der-kollege/My_kicad_hardware/FPGA_Board_BA/Render3.png

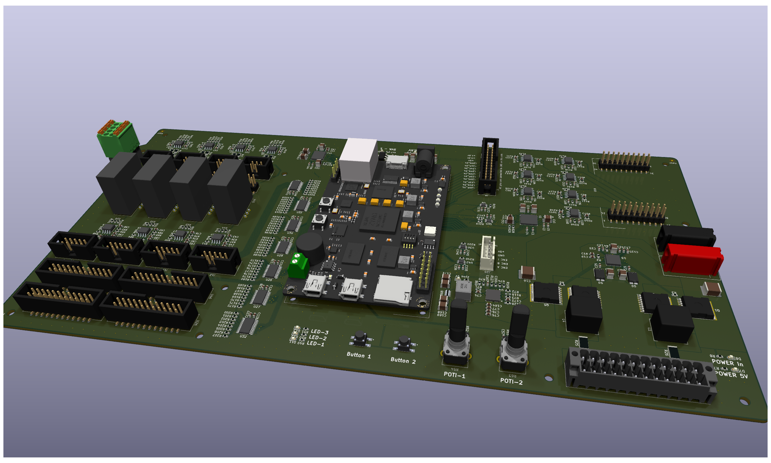
FPGA_Board_BA/Render3.png
