der-kollege/My_kicad_hardware/FPGA_Board_BA/Render1.png

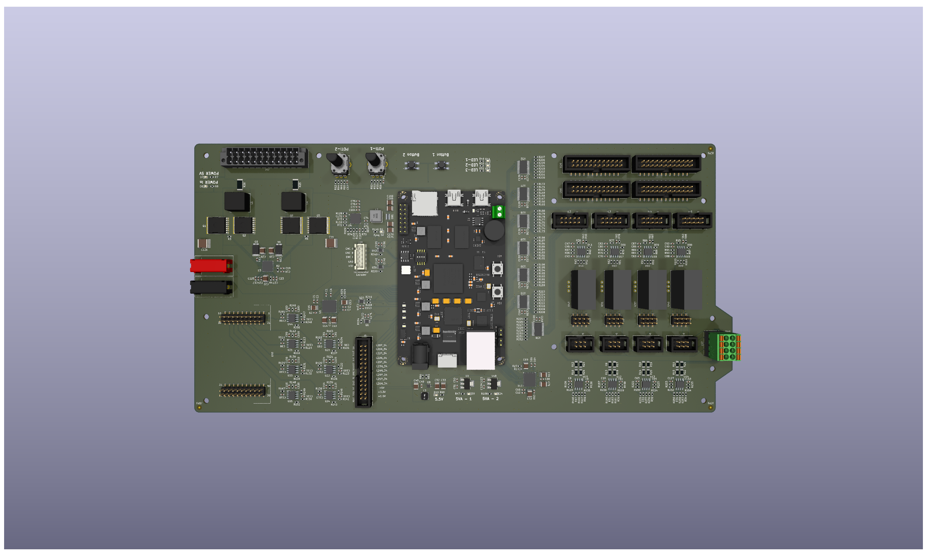
FPGA_Board_BA/Render1.png
