der-kollege/My_kicad_hardware/Adapter_Board/notes.txt

Zweilaging alle gnd stecker an gnd
Pads so breit wie möglich
Bei Versorgung pins viele vias
