der-kollege/My_kicad_hardware/FPGA_Board_BA/Pins FPGA.txt

Pins FPGA:

Bank 13: number of pins 12
Bank 34: ... 48
Bank 35: #48

CHB Connector: Wannenstecker - 10 pin (Harting-ML10)
