der-kollege/My_kicad_hardware/FPGA_Board_BA/FPGA_board.drawio.png

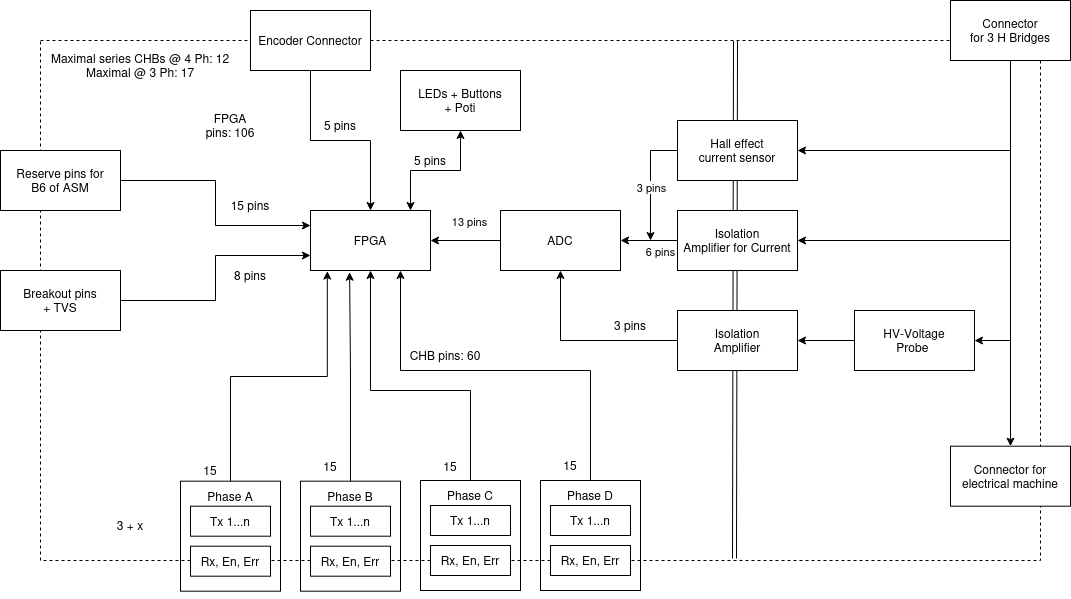
FPGA_Board_BA/FPGA_board.drawio.png
