der-kollege/My_kicad_hardware/FPGA_Board_BA/IMG_6897.jpeg

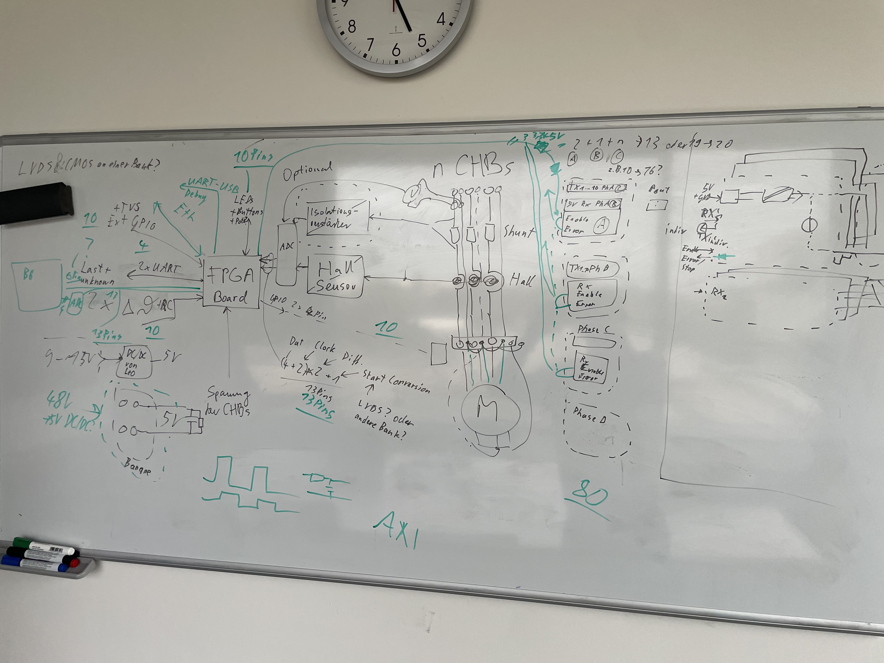
FPGA_Board_BA/IMG_6897.jpeg
