der-kollege/My_kicad_hardware/FPGA_Board_BA/IMG_7021.jpeg

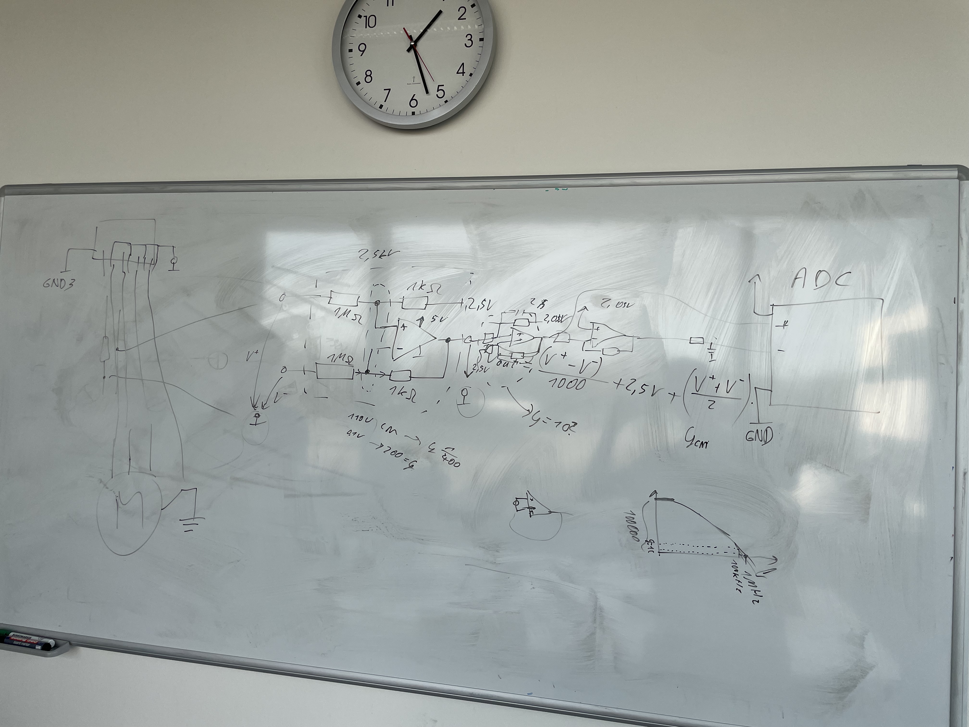
FPGA_Board_BA/IMG_7021.jpeg
