der-kollege/My_kicad_hardware/FPGA_Board_BA/IMG_7337.jpeg

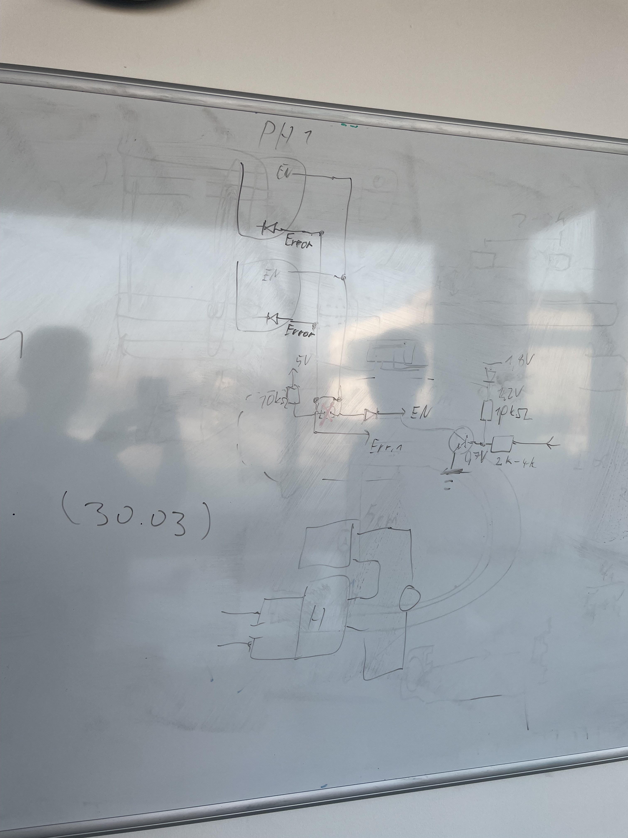
FPGA_Board_BA/IMG_7337.jpeg
