der-kollege/My_kicad_hardware/FPGA_Board_BA/Render2.png

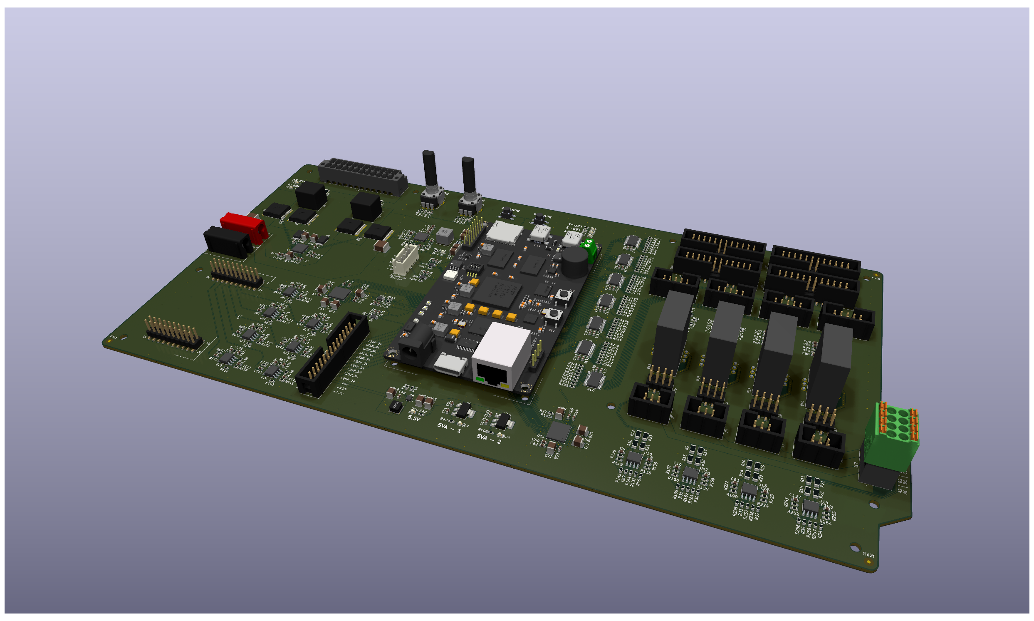
FPGA_Board_BA/Render2.png
