der-kollege/My_kicad_hardware/FPGA_Board_BA/Vivado_pinout_adc_in.png

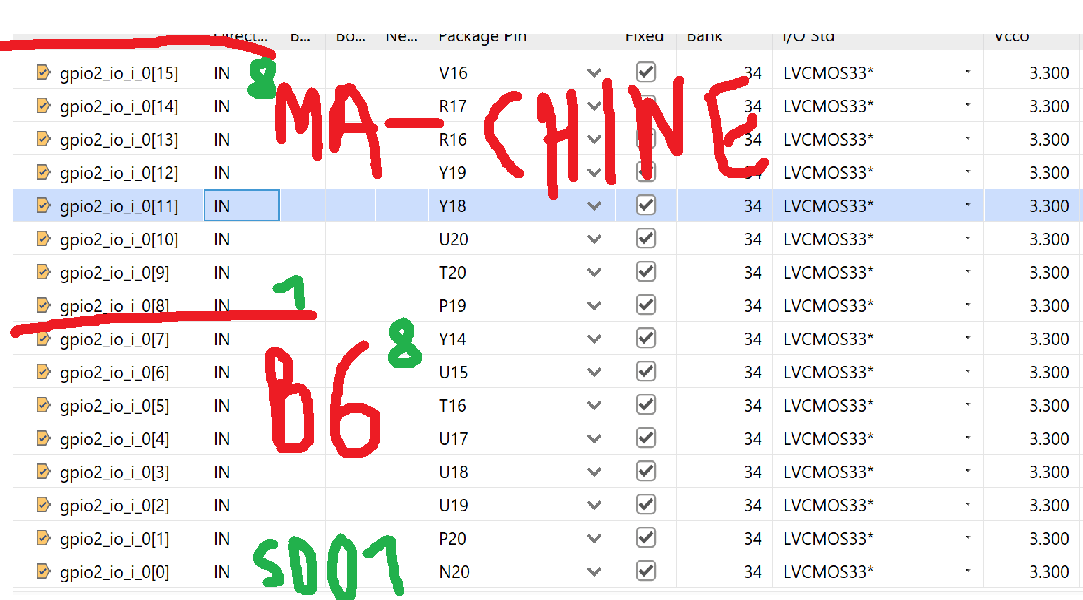
FPGA_Board_BA/Vivado_pinout_adc_in.png
