der-kollege/My_kicad_hardware/FPGA_Board_BA/vivado_pinout_buttons.png

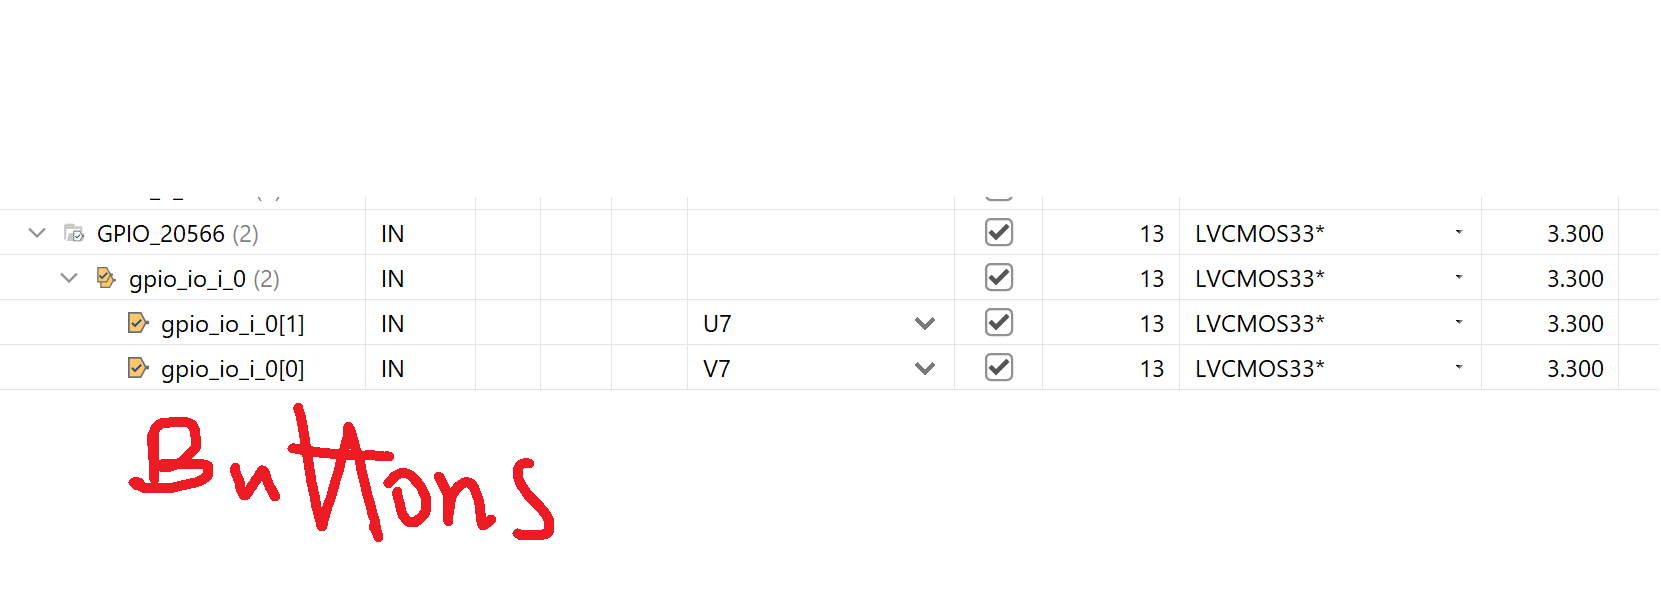
FPGA_Board_BA/vivado_pinout_buttons.png
