der-kollege/My_kicad_hardware/FPGA_Board_BA/vivado_pinout_zynq_out.png

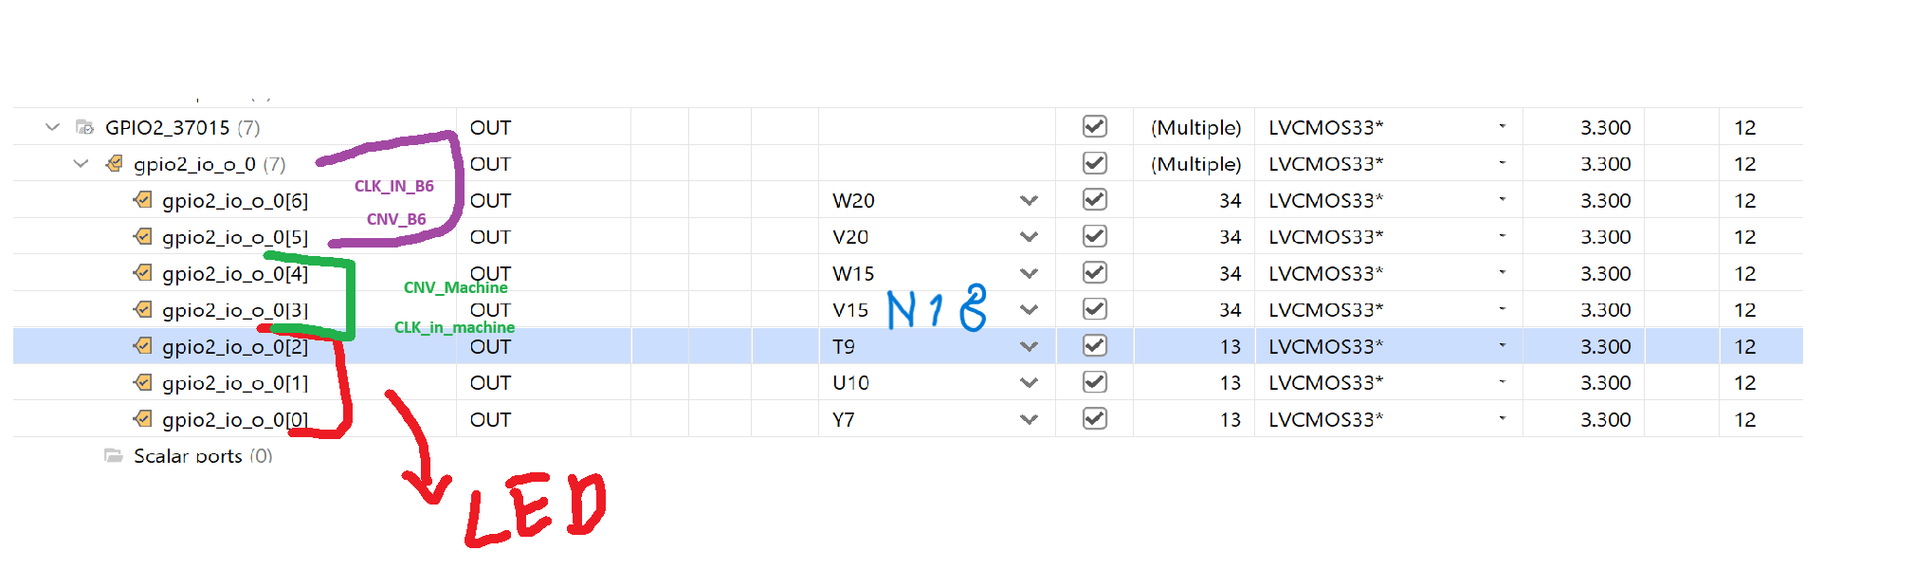
FPGA_Board_BA/vivado_pinout_zynq_out.png
