der-kollege/My_kicad_hardware/FPGA_Board_BA/vivado_pintout_rx_tx.png

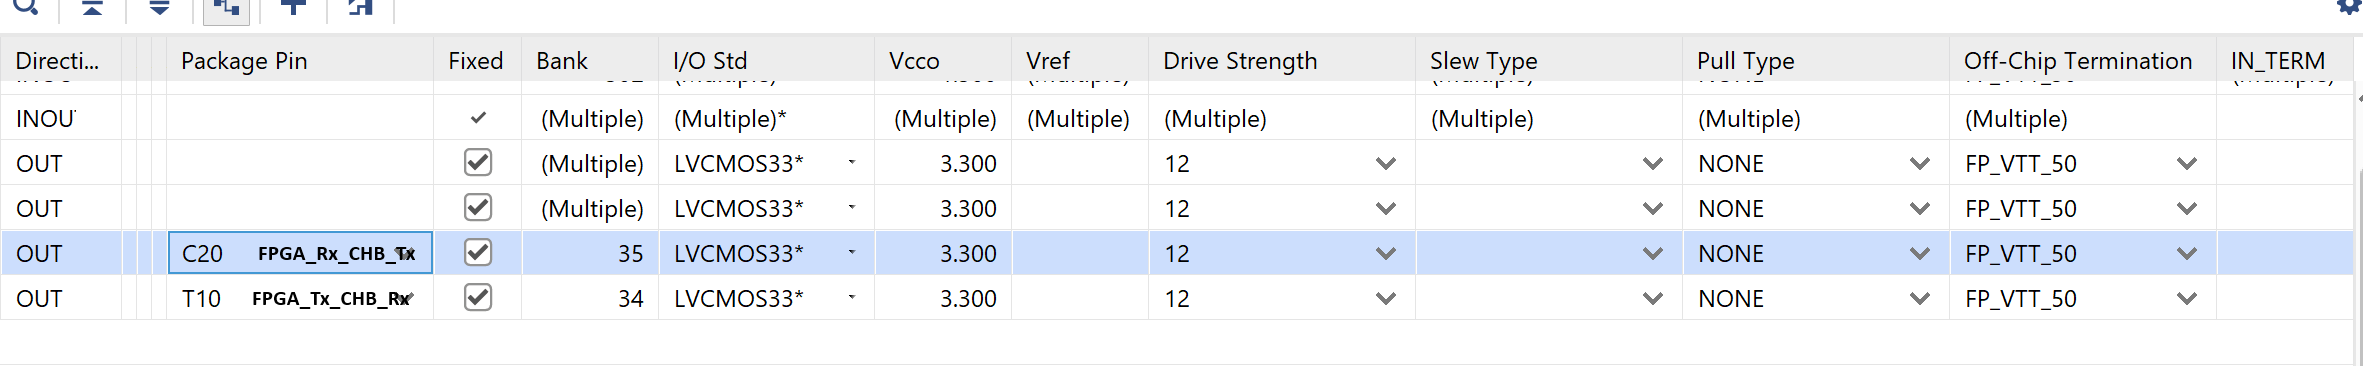
FPGA_Board_BA/vivado_pintout_rx_tx.png
