der-kollege/My_kicad_hardware/FPGA_Board_BA/exports/BOM/FPGA_Board_BA_final_left.csv

Id | Designator | Footprint | Quantity | Designation | Supplier and ref
25 | L2 | L_5u6_78439346056 | 1 | Inductor 5.6uH
35 | U4 | RRX Package, 29-Pin VQFN | 1 | LM70860RRXR
37 | U43,U31,U37,U40 | Tamura_S22P006S05 | 4 | S22P006S05
61 | J20 | JST_XH_B5B-XH-A_1x05_P2.50mm_Vertical | 1 | JST_XH_05_vertical
