der-kollege/My_kicad_hardware/FPGA_Board_BA/exports/BOM/BOM_Mouser_1.xls

WARENKORB
Dies ist keine Rechnung
01-Dez-25 09:17:06
 | Mouser-Nr. | Herst.- Nr. | Hersteller | Kunden-Teilenr | Beschreibung | RoHS | Lebenszyklus | Stückzahl | Preis (EUR) | Gesamtpreis: (EUR)
1 | 584-LT1819IS8#PBF | LT1819IS8#PBF | Analog Devices Inc. | LT1819IS8#PBF | Hochgeschwindigkeits-Operationsverstärker 400MHz, 2500V/ s, 9mA 2x Op Amps | RoHS-konform |  | 15 | 3,84 € | 57,60 €
2 | 838-S22P006S05 | S22P006S05 | Tamura | S22P006S05 | Stromsensoren für Plattenmontage CURRENT SENSOR ( 6A; +5V) | RoHS-konform |  | 4 | 13,52 € | 54,08 €
3 | 595-74LXC2T45QDCURQ1 | SN74LXC2T45QDCURQ1 | Texas Instruments | SN74LXC2T45QDCURQ1 | Übersetzungsspannungs-Pegel Automotive two-bit d ual-supply transceiv | RoHS-konform |  | 6 | 0,869 € | 5,21 €
4 | 595-N74LXCH8T245RHLR | SN74LXCH8T245RHLR | Texas Instruments | SN74LXCH8T245RHLR | Übersetzungsspannungs-Pegel 8-bit dual-supply bu s transceiver with c | RoHS-konform |  | 7 | 1,63 € | 11,41 €
5 | 584-C2320CUKG-16PBF | LTC2320CUKG-16#PBF | Analog Devices Inc. | LTC2320CUKG-16#PBF | Analog-in-Digital-Wandler - ADC Octal, 16-B, 1.5Msps/Ch Simultaneous Smp | RoHS-konform |  | 2 | 31,02 € | 62,04 €
6 | 579-MCP1703AT5002EDB | MCP1703AT-5002E/DB | Microchip | MCP1703AT-5002E/DB | LDO Spannungs-Regulator LOW Iq, High Vin LDO | RoHS-konform |  | 1 | 0,722 € | 0,72 €
7 | 595-TPS61022RWUT | TPS61022RWUT | Texas Instruments | TPS61022RWUT | Schaltspannungsregler 8-A boost converter with 0.5-V ultra-low A 595-TPS61022RWUR | RoHS-konform |  | 1 | 2,06 € | 2,06 €
8 | 595-LM5143RHAR | LM5143RHAR | Texas Instruments | LM5143RHAR | Schaltregler 3.5-V to 65-V dual- output stackable s | RoHS-konform |  | 1 | 4,02 € | 4,02 €
9 | 612-TL3305BF100QG | TL3305BF100QG | E-Switch | TL3305BF100QG | Sensorschalter TACT, 50mA, SPST-NO, Surface Mount | RoHS-konform | Neues Produkt | 2 | 0,181 € | 0,36 €
10 | 688-RK09D1130A1N | RK09D1130A1N | Alps Alpine | RK09D1130A1N | Potentiometer 9MM 10K V/ADJ | RoHS-konform |  | 2 | 3,16 € | 6,32 €
11 | 726-IPT017N12NM6ATMA | IPT017N12NM6ATMA1 | Infineon | IPT017N12NM6ATMA1 | MOSFETs TRENCH >=100V | RoHS-konform |  | 4 | 5,14 € | 20,56 €
12 | 621-SBR10U200P5-13 | SBR10U200P5-13 | Diodes Incorporated | SBR10U200P5-13 | Schottky Dioden & Gleichrichter 10A 200V MATT TIN FINISH | RoHS-konform |  | 2 | 1,23 € | 2,46 €
13 | 871-B72590D50H160 | B72590D50H160 | TDK | B72590D50H160 | Varistoren 5.6 VDC .9P 210PF | RoHS-konform |  | 14 | 0,047 € | 0,66 €
14 | 845-973582101 | 973582101 | Altech | 973582101 | Prüfstecker und Messbuchsen PCB Test Socket PB4 RED | RoHS-konform |  | 1 | 2,92 € | 2,92 €
15 | 845-973582100 | 973582100 | Altech | 973582100 | Prüfstecker und Messbuchsen PCB Test Socket PB 4 BLACK | RoHS-konform |  | 1 | 2,92 € | 2,92 €
16 | 710-61202421621 | 61202421621 | Wurth Elektronik | 61202421621 | Sockel & Kabelgehäuse WR-BHD 2.54mm Male 24P Str Gold Box Hdr | RoHS-konform |  | 4 | 0,869 € | 3,48 €
17 | 755-PMR18EZPJV2L0 | PMR18EZPJV2L0 | ROHM Semiconductor |  | Strommesswiderstände - SMD 1206 2mOhm 5% AEC-Q200 | RoHS-konform |  | 2 | 0,576 € | 1,15 €
18 | 651-1787496 | 1787496 | Phoenix Contact |  | Steckbare Anschlussblöcke 12 Pos 3.5mm Dbl Row Through Hole Header | RoHS-konform |  | 1 | 7,46 € | 7,46 €
19 | 651-1790580 | 1790580 | Phoenix Contact |  | Steckbare Anschlussblöcke 12 Pos 3.5mm Dbl Row Plug 24-16AWG Sprin | RoHS-konform |  | 1 | 15,61 € | 15,61 €
20 | 710-61202423021 | 61202423021 | Wurth Elektronik |  | Sockel & Kabelgehäuse WR-BHD 2.54mm Female 24P Gold IDC Conn | RoHS-konform |  | 4 | 2,00 € | 8,00 €
Durch das Absenden Ihrer Bestellung erklären Sie sich mit diesen Geschäftsbedingungen einverstanden. (https://www.mouser.de/saleterms) |  |  |  |  |  |  |  |  | Ware: | 269,04 €
Die Preise sind zum angezeigten Datum und zur Uhrzeit reflektiert. |  |  |  |  |  |  |  |  | Versandkosten: | 0,00 €
 |  |  |  |  |  |  |  |  | Versand von Nachlieferungen: | 0,00 €
