der-kollege/My_kicad_hardware/FPGA_Board_BA/exports/BOM/Final/Zynq_Farnell_BOM.csv

Nr. | Best.-Nr. | RoHS-konform? | Ihre Bestellnummer | Hinweise | Menge | Hersteller-Teilenr. | Herstellername | Hersteller / Beschreibung | Verfügbarkeit | Stückpreis (&euro;) | Positionspreis (&euro;) | Rabattpreis (&euro;)
1 | 2447451 | RoHS: Y-EX / PHTHALATE: YES |  |  | 10.0 | MCWR06X9101FTL | MULTICOMP PRO | MULTICOMP PRO Chipwiderstand, Oberflächenmontage, 9.1 kohm, ± 1%, 100 mW, 0603 [Metrisch 1608] | 7189 | 0.0054 | 0.05
2 | 2447272 | RoHS: Y-EX / PHTHALATE: YES |  |  | 40.0 | MCWR06X1001FTL | MULTICOMP PRO | MULTICOMP PRO Chipwiderstand, Oberflächenmontage, 1 kohm, ± 1%, 100 mW, 0603 [Metrisch 1608] | 402564 | 0.0048 | 0.19
3 | 2447404 | RoHS: Y-EX / PHTHALATE: YES |  |  | 10.0 | MCWR06X5101FTL | MULTICOMP PRO | MULTICOMP PRO Chipwiderstand, Oberflächenmontage, 5.1 kohm, ± 1%, 100 mW, 0603 [Metrisch 1608] | 35660 | 0.0051 | 0.05
4 | 2447335 | RoHS: Y-EX / PHTHALATE: YES |  |  | 30.0 | MCWR06X30R0FTL | MULTICOMP PRO | MULTICOMP PRO Chipwiderstand, Oberflächenmontage, 30 ohm, ± 1%, 100 mW, 0603 [Metrisch 1608] | 6942 | 0.0051 | 0.15
5 | 2694689 | RoHS: YES / PHTHALATE: YES |  |  | 90.0 | MCWR06X103 JTL | MULTICOMP PRO | MULTICOMP PRO Chipwiderstand, Oberflächenmontage, 10 kohm, ± 5%, 100 mW, 0603 [Metrisch 1608] | 33083 | 0.0048 | 0.43
6 | 2447227 | RoHS: Y-EX / PHTHALATE: YES |  |  | 20.0 | MCWR06X1000FTL | MULTICOMP PRO | MULTICOMP PRO Chipwiderstand, Oberflächenmontage, 100 ohm, ± 1%, 100 mW, 0603 [Metrisch 1608] | 163509 | 0.0049 | 0.10
7 | 2694690 | RoHS: YES / PHTHALATE: YES |  |  | 20.0 | MCWR06X104 JTL | MULTICOMP PRO | MULTICOMP PRO Chipwiderstand, Oberflächenmontage, 100 kohm, ± 5%, 100 mW, 0603 [Metrisch 1608] | 3910 | 0.0049 | 0.10
8 | 2670906 | RoHS: YES / PHTHALATE: YES |  |  | 10.0 | WR06X824 JTL | MULTICOMP PRO | MULTICOMP PRO Chipwiderstand, Oberflächenmontage, 820 kohm, ± 5%, 100 mW, 0603 [Metrisch 1608] | 580 Verfügbar | bis der Lagerbestand erschöpft ist. | 0.0035 | 0.04
9 | 2694815 | RoHS: YES / PHTHALATE: YES |  |  | 10.0 | MCWR06X2R2 JTL | MULTICOMP PRO | MULTICOMP PRO Chipwiderstand, Oberflächenmontage, 2.2 ohm, ± 5%, 100 mW, 0603 [Metrisch 1608] | 3730 Verfügbar | bis der Lagerbestand erschöpft ist. | 0.0051 | 0.05
10 | 2694851 | RoHS: YES / PHTHALATE: YES |  |  | 10.0 | MCWR06X3922FTL | MULTICOMP PRO | MULTICOMP PRO Chipwiderstand, Oberflächenmontage, 39.2 kohm, ± 1%, 100 mW, 0603 [Metrisch 1608] | 1036 | 0.0053 | 0.05
11 | 2670720 | RoHS: YES / PHTHALATE: YES |  |  | 10.0 | WR06X2552FTL | MULTICOMP PRO | MULTICOMP PRO Chipwiderstand, Oberflächenmontage, 25.5 kohm, ± 1%, 100 mW, 0603 [Metrisch 1608] | 2622 | 0.0051 | 0.05
12 | 2073345 | RoHS: Y-EX / PHTHALATE: YES |  |  | 20.0 | MCMR06X000 PTL | MULTICOMP PRO | MULTICOMP PRO Null-Ohm-Widerstand, Jumper, AEC-Q200, 0603 [Metrisch 1608], Dickschichtwiderstand, 100 mW, 1 A | 51500 | 0.0137 | 0.27
13 | 4539043 | RoHS: YES / PHTHALATE: YES |  |  | 10.0 | CL10B104KB8NNNC | SAMSUNG ELECTRO-MECHANICS | SAMSUNG ELECTRO-MECHANICS Keramikvielschichtkondensator, SMD, 0.1 µF, 50 V, 0603 [Metrisch 1608], ± 10%, X7R | 169323 | 0.0060 | 0.06
14 | 3013441 | RoHS: YES / PHTHALATE: YES |  |  | 50.0 | CL10C150JB8NNNC | SAMSUNG ELECTRO-MECHANICS | SAMSUNG ELECTRO-MECHANICS Keramikvielschichtkondensator, SMD, 15 pF, 50 V, 0603 [Metrisch 1608], ± 5%, C0G / NP0 | 8088 | 0.0174 | 0.87
15 | 3013399 | RoHS: YES / PHTHALATE: YES |  |  | 10.0 | CL10A475KQ8NNNC | SAMSUNG ELECTRO-MECHANICS | SAMSUNG ELECTRO-MECHANICS Keramikvielschichtkondensator, SMD, 4.7 µF, 6.3 V, 0603 [Metrisch 1608], ± 10%, X5R | 3173 | 0.0130 | 0.13
16 | 3764545 | RoHS: YES / PHTHALATE: YES |  |  | 10.0 | CC0603KRX7R9BB124 | YAGEO | YAGEO Keramikvielschichtkondensator, SMD, 0.12 µF, 50 V, 0603 [Metrisch 1608], ± 10%, X7R | 2027 | 0.0584 | 0.58
17 | 722054 | RoHS: YES / PHTHALATE: YES |  |  | 10.0 | CC0603JRNPO9BN560 | YAGEO | YAGEO Keramikvielschichtkondensator, SMD, 56 pF, 50 V, 0603 [Metrisch 1608], ± 5%, C0G / NP0 | 11673 | 0.0201 | 0.20
18 | 8819920 | RoHS: YES / PHTHALATE: YES |  |  | 10.0 | GRM1885C1H102JA01D | MURATA | MURATA Keramikvielschichtkondensator, SMD, 1000 pF, 50 V, 0603 [Metrisch 1608], ± 5%, C0G / NP0 | 31700 | 0.0105 | 0.11
19 | 4666646 | RoHS: YES / PHTHALATE: YES |  |  | 5.0 | MSASE32NSB5106KTNA01 | TAIYO YUDEN | TAIYO YUDEN Keramikvielschichtkondensator, SMD, 10 µF, 16 V, 1210 [Metrisch 3225], ± 10%, X5R | 1640 | 0.1410 | 0.71
20 | 4255901 | RoHS: YES / PHTHALATE: YES |  |  | 6.0 | CC1210KFX7R9BB106 | YAGEO | YAGEO Keramikvielschichtkondensator, SMD, 10 µF, 50 V, 1210 [Metrisch 3225], ± 10%, X7R | 4765 Verfügbar | bis der Lagerbestand erschöpft ist. | 0.5700 | 3.42
21 | 1358511 | RoHS: YES / PHTHALATE: YES |  |  | 10.0 | C1210C475K5RACTU | KEMET | KEMET Keramikvielschichtkondensator, SMD, 4.7 µF, 50 V, 1210 [Metrisch 3225], ± 10%, X7R | 26895 | 0.2860 | 2.86
22 | 2610410 | RoHS: YES / PHTHALATE: YES |  |  | 5.0 | KPT-1608LVVBC-D | KINGBRIGHT | KINGBRIGHT LED, 1.6mm x 0.8mm, Blau, Oberflächenmontage, 603, 2 mA, 2.65 V, 470 nm | 1760 | 0.3170 | 1.59
23 | 2610409 | RoHS: YES / PHTHALATE: YES |  |  | 10.0 | KPT-1608LVZGCK | KINGBRIGHT | KINGBRIGHT LED, 1.6mm x 0.8mm, Grün, Oberflächenmontage, 603, 2 mA, 2.65 V, 525 nm | 20148 | 0.2700 | 2.70
24 | 2610406 | RoHS: YES / PHTHALATE: YES |  |  | 5.0 | KPT-1608LVSECK-J3-PRV | KINGBRIGHT | KINGBRIGHT LED, 1.6mm x 0.8mm, Rot, Oberflächenmontage, 603, 2 mA, 1.8 V, 625 nm | 38399 | 0.2880 | 1.44
25 | 3785802 | RoHS: YES / PHTHALATE: YES |  |  | 10.0 | GRM155R61A106ME11D | MURATA | MURATA Keramikvielschichtkondensator, SMD, 10 µF, 10 V, 0402 [Metrisch 1005], ± 20%, X5R | 130241 | 0.0134 | 0.13
26 | 3013435 | RoHS: YES / PHTHALATE: YES |  |  | 10.0 | CL10B474KO8NNNC | SAMSUNG ELECTRO-MECHANICS | SAMSUNG ELECTRO-MECHANICS Keramikvielschichtkondensator, SMD, 0.47 µF, 16 V, 0603 [Metrisch 1608], ± 10%, X7R | 12152 | 0.0238 | 0.24
27 | 3764545 | RoHS: YES / PHTHALATE: YES |  |  | 10.0 | CC0603KRX7R9BB124 | YAGEO | YAGEO Keramikvielschichtkondensator, SMD, 0.12 µF, 50 V, 0603 [Metrisch 1608], ± 10%, X7R | 2027 | 0.0584 | 0.58
28 | 4539043 | RoHS: YES / PHTHALATE: YES |  |  | 90.0 | CL10B104KB8NNNC | SAMSUNG ELECTRO-MECHANICS | SAMSUNG ELECTRO-MECHANICS Keramikvielschichtkondensator, SMD, 0.1 µF, 50 V, 0603 [Metrisch 1608], ± 10%, X7R | 169323 | 0.0060 | 0.54
29 | 2496840 | RoHS: YES / PHTHALATE: YES |  |  | 10.0 | 0603B153K500CT | MULTICOMP PRO | MULTICOMP PRO Keramikvielschichtkondensator, SMD, 0.015 µF, 50 V, 0603 [Metrisch 1608], ± 10%, X7R | 2872 Verfügbar | bis der Lagerbestand erschöpft ist. | 0.0225 | 0.23
30 | 3013384 | RoHS: YES / PHTHALATE: YES |  |  | 20.0 | CL10A105KO8NNNC | SAMSUNG ELECTRO-MECHANICS | SAMSUNG ELECTRO-MECHANICS Keramikvielschichtkondensator, SMD, 1 µF, 16 V, 0603 [Metrisch 1608], ± 10%, X5R | 96218 | 0.0101 | 0.20
31 | 3816866 | RoHS: YES / PHTHALATE: YES |  |  | 4.0 | C5750X7R1H226M250KB | TDK | TDK Keramikvielschichtkondensator, SMD, 22 µF, 50 V, 2220 [Metrisch 5750], ± 20%, X7R | 2719 | 4.2000 | 16.80
32 | 3581426 | RoHS: YES / PHTHALATE: YES |  |  | 10.0 | GRM32EC81C476KE15K | MURATA | MURATA Keramikvielschichtkondensator, SMD, 47 µF, 16 V, 1210 [Metrisch 3225], ± 10%, X6S | 13848 | 0.2130 | 2.13
33 | 3764454 | RoHS: YES / PHTHALATE: YES |  |  | 10.0 | CC0603JPNPO9BN220 | YAGEO | YAGEO Keramikvielschichtkondensator, SMD, 22 pF, 50 V, 0603 [Metrisch 1608], ± 5%, C0G / NP0 | 377510 | 0.0190 | 0.19
34 | 2562024 | RoHS: Y-EX / PHTHALATE: YES |  |  | 10.0 | ERJPA3F4122V | PANASONIC | PANASONIC Chipwiderstand, Oberflächenmontage, 41.2 kohm, ± 1%, 250 mW, 0603 [Metrisch 1608] | 4854 | 0.0639 | 0.64
35 | 2447351 | RoHS: Y-EX / PHTHALATE: YES |  |  | 10.0 | MCWR06X3832FTL | MULTICOMP PRO | MULTICOMP PRO Chipwiderstand, Oberflächenmontage, 38.3 kohm, ± 1%, 100 mW, 0603 [Metrisch 1608] | 6289 | 0.0053 | 0.05
36 | 3539940 | RoHS: Y-EX / PHTHALATE: YES |  |  | 10.0 | RK73H1JTTD3922F | KOA | KOA Chipwiderstand, Oberflächenmontage, 39.2 kohm, ± 1%, 100 mW, 0603 [Metrisch 1608] | 24721 | 0.0138 | 0.14
37 | 3993385 | RoHS: Y-EX / PHTHALATE: YES |  |  | 30.0 | RC0603FR-075K1P | YAGEO | YAGEO Chipwiderstand, Oberflächenmontage, 5.1 kohm, ± 1%, 100 mW, 0603 [Metrisch 1608] | 3120 | 0.0098 | 0.29
38 | 1469649 | RoHS: Y-EX / PHTHALATE: YES |  |  | 10.0 | CRCW0603100KFKEA | VISHAY | VISHAY Chipwiderstand, Oberflächenmontage, 100 kohm, ± 1%, 125 mW, 0603 [Metrisch 1608] | 3953063 | 0.0164 | 0.16
39 | 4009405 | RoHS: YES / PHTHALATE: YES |  |  | 10.0 | ESR03EZPF8203 | ROHM | ROHM Chipwiderstand, Oberflächenmontage, 820 kohm, ± 1%, 250 mW, 0603 [Metrisch 1608] | 4620 | 0.0649 | 0.65
40 | 2059474 | RoHS: Y-EX / PHTHALATE: YES |  |  | 10.0 | ERJ3EKF5232V | PANASONIC | PANASONIC Chipwiderstand, Oberflächenmontage, 52.3 kohm, ± 1%, 100 mW, 0603 [Metrisch 1608] | 17000 | 0.0248 | 0.25
41 | 4079285 | RoHS: Y-EX / PHTHALATE: YES |  |  | 10.0 | RP0603BRD0724K9L | YAGEO | YAGEO Chipwiderstand, Oberflächenmontage, 24.9 kohm, ± 0.1%, 100 mW, 0603 [Metrisch 1608] | 7720 | 0.1250 | 1.25
42 | 2059483 | RoHS: Y-EX / PHTHALATE: YES |  |  | 10.0 | ERJ3EKF7152V | PANASONIC | PANASONIC Chipwiderstand, Oberflächenmontage, 71.5 kohm, ± 1%, 100 mW, 0603 [Metrisch 1608] | 31169 | 0.0201 | 0.20
43 | 3646096 | RoHS: YES / PHTHALATE: YES |  |  | 10.0 | ERJH3QJ1R0V | PANASONIC | PANASONIC Chipwiderstand, Oberflächenmontage, 1 ohm, ± 5%, 250 mW, 0603 [Metrisch 1608] | 4300 | 0.0805 | 0.81
44 | 4312048 | RoHS: Y-EX / PHTHALATE: YES |  |  | 20.0 | RC1206FR-13100KL | YAGEO | YAGEO Chipwiderstand, Oberflächenmontage, 100 kohm, ± 1%, 250 mW, 1206 [Metrisch 3216] | 12180 | 0.0108 | 0.22
45 | 722054 | RoHS: YES / PHTHALATE: YES |  |  | 10.0 | CC0603JRNPO9BN560 | YAGEO | YAGEO Keramikvielschichtkondensator, SMD, 56 pF, 50 V, 0603 [Metrisch 1608], ± 5%, C0G / NP0 | 11673 | 0.0201 | 0.20
 |  |  |  |  |  |  | Zwischensumme | &euro;42.10
 |  |  |  |  |  |  | Warengesamtsumme | &euro;42.10
 |  |  |  |  |  |  | Lieferung | &euro;11.99
 |  |  |  |  |  |  | USt. | &euro;10.28
 |  |  |  |  |  |  | Gesamt | &euro;64.37
