der-kollege/My_kicad_hardware/FPGA_Board_BA/exports/BOM/Final/Zynq_Mouser_BOM.xls

SHOPPING BASKET
This is not an invoice
27-Jan-26 10:34:43
 | Mouser No | Mfr. No | Manufacturer | Customer No | Description | RoHS | Lifecycle | Order Qty. | Price (EUR) | Ext.: (EUR)
1 | 584-LT1819IS8#PBF | LT1819IS8#PBF | Analog Devices Inc. |  | High Speed Operational Amplifiers 400MHz, 2500V/ s, 9mA 2x Op Amps | RoHS Compliant |  | 15 | 5,60 € | 84,00 €
2 | 595-74LXC2T45QDCURQ1 | SN74LXC2T45QDCURQ1 | Texas Instruments |  | Translation - Voltage Levels Automotive two-bit d ual-supply transcei | RoHS Compliant |  | 8 | 1,73 € | 13,84 €
3 | 595-N74LXCH8T245RHLR | SN74LXCH8T245RHLR | Texas Instruments |  | Translation - Voltage Levels 8-bit dual-supply bu s transceiver with | RoHS Compliant |  | 7 | 1,84 € | 12,88 €
4 | 584-C2320CUKG-16PBF | LTC2320CUKG-16#PBF | Analog Devices Inc. |  | Analog to Digital Converters - ADC Octal, 16-B, 1.5Msps/Ch Simultaneous Smp | RoHS Compliant |  | 2 | 38,11 € | 76,22 €
5 | 579-MCP1703AT5002EDB | MCP1703AT-5002E/DB | Microchip |  | LDO Voltage Regulators LOW Iq, High Vin LDO | RoHS Compliant |  | 2 | 0,722 € | 1,44 €
6 | 595-TPS61022RWUT | TPS61022RWUT | Texas Instruments |  | Switching Voltage Regulators 8-A boost converter with 0.5-V ultra-low A 595-TPS61022RWUR | RoHS Compliant |  | 1 | 2,06 € | 2,06 €
7 | 595-LM5143RHAR | LM5143RHAR | Texas Instruments |  | Switching Controllers 3.5-V to 65-V dual- output stackable s | RoHS Compliant |  | 1 | 4,02 € | 4,02 €
8 | 612-TL3305BF100QG | TL3305BF100QG | E-Switch |  | Tactile Switches TACT, 50mA, SPST-NO, Surface Mount | RoHS Compliant | New Product | 2 | 0,181 € | 0,36 €
9 | 688-RK09D1130A1N | RK09D1130A1N | Alps Alpine |  | Potentiometers 9MM 10K V/ADJ | RoHS Compliant |  | 2 | 3,11 € | 6,22 €
10 | 726-IPT017N12NM6ATMA | IPT017N12NM6ATMA1 | Infineon |  | MOSFETs IFX FET >100-150V | RoHS Compliant |  | 4 | 5,14 € | 20,56 €
11 | 621-SBR10U200P5-13 | SBR10U200P5-13 | Diodes Incorporated |  | Schottky Diodes & Rectifiers 10A 200V MATT TIN FINISH | RoHS Compliant |  | 2 | 1,23 € | 2,46 €
12 | 871-B72590D50H160 | B72590D50H160 | TDK |  | Varistors 5.6 VDC .9P 210PF | RoHS Compliant |  | 13 | 0,046 € | 0,60 €
13 | 845-973582101 | 973582101 | Altech |  | Test Plugs & Test Jacks PCB Test Socket PB4 RED | RoHS Compliant |  | 1 | 2,92 € | 2,92 €
14 | 845-973582100 | 973582100 | Altech |  | Test Plugs & Test Jacks PCB Test Socket PB 4 BLACK | RoHS Compliant |  | 1 | 2,92 € | 2,92 €
15 | 710-61202421621 | 61202421621 | Wurth Elektronik |  | Headers & Wire Housings WR-BHD 2.54mm Male 24P Str Gold Box Hdr | RoHS Compliant |  | 8 | 0,869 € | 6,95 €
16 | 651-1787496 | 1787496 | Phoenix Contact |  | Pluggable Terminal Blocks 12 Pos 3.5mm Dbl Row Through Hole Header | RoHS Compliant |  | 1 | 7,46 € | 7,46 €
17 | 651-1790580 | 1790580 | Phoenix Contact |  | Pluggable Terminal Blocks 12 Pos 3.5mm Dbl Row Plug 24-16AWG Sprin | RoHS Compliant |  | 1 | 15,61 € | 15,61 €
18 | 710-61202423021 | 61202423021 | Wurth Elektronik |  | Headers & Wire Housings WR-BHD 2.54mm Female 24P Gold IDC Conn | RoHS Compliant |  | 4 | 2,00 € | 8,00 €
19 | 754-PRL1632-R006-FT1 | PRL1632-R006-F-T1 | Susumu |  | Current Sense Resistors - SMD 1W 0.006ohm 1% | RoHS Compliant |  | 1 | 0,679 € | 0,68 €
20 | 708-CSNL2512FT2L00 | CSNL2512FT2L00 | SEI Stackpole |  | Current Sense Resistors - SMD 0.002Ohms 2512 2W 50 ppm 1% Metal Plate | RoHS Compliant |  | 2 | 0,533 € | 1,07 €
21 | 621-B130LAW-F | B130LAW-7-F | Diodes Incorporated |  | Schottky Diodes & Rectifiers 30V 1A | RoHS Compliant |  | 8 | 0,292 € | 2,34 €
22 | 710-74404043010A | 74404043010A | Wurth Elektronik |  | Power Inductors - SMD WE-LQS 1uH 4.9A DCR=14mOhms AEC-Q200 | RoHS Compliant |  | 1 | 0,55 € | 0,55 €
23 | 651-1787221 | 1787221 | Phoenix Contact |  | Pluggable Terminal Blocks 4 Pos 3.5mm Dbl Row Through Hole Header | RoHS Compliant |  | 1 | 2,13 € | 2,13 €
24 | 651-1790124 | 1790124 | Phoenix Contact |  | Pluggable Terminal Blocks 4 Pos 3.5mm Dbl Row Plug 24-16AWG Spring | RoHS Compliant |  | 1 | 5,27 € | 5,27 €
25 | 994-XAL1010-152MED | XAL1010-152MED | Coilcraft |  | Power Inductors - SMD 1.5uH Shld 20% 40.5A 1.76mOhms AECQ2 | RoHS Compliant |  | 2 | 7,13 € | 14,26 €
26 | 863-NTR5103NT1G | NTR5103NT1G | onsemi |  | MOSFETs NFET SOT23 60V 310MA 2.5 | RoHS Compliant |  | 4 | 0,163 € | 0,65 €
27 | 200-TFM14002LDWT | TFM-140-02-L-D-WT | Samtec |  | Headers & Wire Housings High-Reliability Tiger Eye Terminal Strips | RoHS Compliant |  | 2 | 7,76 € | 15,52 €
28 | 710-61002021121 | 61002021121 | Wurth Elektronik |  | Headers & Wire Housings WR-PHD 2.54mm SMT 20 P Hdr Dual Strt | RoHS Compliant |  | 2 | 3,20 € | 6,40 €
29 | 594-MCT06030D5000BP1 | MCT06030D5000BP100 | Vishay |  | Thin Film Resistors - SMD MCT 0603-25 0.1% P1 500R | RoHS Compliant By Exemption |  | 22 | 0,463 € | 10,19 €
30 | 710-61030821121 | 61030821121 | Wurth Elektronik |  | Headers & Wire Housings WR-PHD 2.54mm SMTHdr 8P Dual Strt Gold | RoHS Compliant |  | 4 | 1,57 € | 6,28 €
31 | 855-M7680-46 | M7680-46 | Harwin |  | Headers & Wire Housings 14MM JUMPER SKT W/HNDL LT GREY | RoHS Compliant |  | 16 | 0,382 € | 6,11 €
By submitting your order you agree to these terms and conditions. (https://www.mouser.de/saleterms) |  |  |  |  |  |  |  |  | Merchandise: | 339,97 €
Prices are reflected at the date and time shown. |  |  |  |  |  |  |  |  | Delivery Charge: | 0,00 €
