der-kollege/My_kicad_hardware/FPGA_Board_BA/Zynq_pinout.xlsx

 | GPIO_0 |  |  | GPIO_1
 | CN1 |  |  | CN1 |  |  | CN2
 | Pin nr | Package Pin | Description | Pin nr | Package Pin | Description | 2 | W8 | ENC_I
 | 12 | T15 | En_ph_c | 29 | V7 | User_btn_2 | 1 | V8 | ENC_B | GPIO_0 | Output
 | 11 | U13 | En_ph_b | 28 | U7 | User_btn_1 | 0 | Y6 | ENC_A | GPIO_1 | Input
 | 10 | T11 | En_ph_a | 27 | Y8 | Err_ph_c
 | 9 | T14 | Rx_ph_c | 26 | V11 | Err_ph_b
 | 8 | V13 | Rx_ph_b | 25 | V10 | Err_ph_a
 | 7 | T10 | Rx_ph_a | 24 | J18 | Tx3_ph_c_CHB
 | 6 | W20 | CNV_B6 | 23 | H17 | Tx2_ph_c_CHB
 | 5 | V20 | CLK_B6 | 22 | H16 | Tx1_ph_c_CHB
 | 4 | W15 | CNV_CHB | 21 | M17 | Tx3_ph_b_CHB
 | 3 | Y17 | CLK_CHB | 20 | M20 | Tx2_ph_b_CHB
 | 2 | T9 | LED3 | 19 | M19 | Tx1_ph_b_CHB
 | 1 | U10 | LED2 | 18 | B19 | Tx3_ph_a_CHB
 | 0 | Y7 | LED1 | 17 | B20 | Tx2_ph_a_CHB
 |  |  |  | 16 | C20 | Tx1_ph_a_CHB
 |  |  |  | 15 | Y16 | SDO8_CHB
Correction: | En_ph_c | T14 |  | 14 | R17 | SDO7_CHB
 | Rx_ph_c | T15 |  | 13 | R16 | SDO6_CHB
 |  |  |  | 12 | Y19 | SDO5_CHB
Noticed | T14 | Y17 |  | 11 | Y18 | SDO4_CHB
 |  |  |  | 10 | U20 | SDO3_CHB
 |  |  |  | 9 | T20 | SDO2_CHB
 |  |  |  | 8 | P19 | SDO1_CHB
 |  |  |  | 7 | Y14 | SDO8_B6
 |  |  |  | 6 | U15 | SDO7_B6
 |  |  |  | 5 | T16 | SDO6_B6
 |  |  |  | 4 | U17 | SDO5_B6
 |  |  |  | 3 | U18 | SDO4_B6
 |  |  |  | 2 | U19 | SDO3_B6
 |  |  |  | 1 | P20 | SDO2_B6
 |  |  |  | 0 | N20 | SDO1_B6
