der-kollege/My_kicad_hardware/FPGA_Board_BA/exports/BOM/Reichelt_BOM.txt

WSL 10G (Stecker)- 4 St
  + PFL 10 (Buchse) - 4 St
WSL 6W (Stecker)- 4 St
  + PFL 6 (Buchse) - 4 St
WSL 26G (Stecker) - 1 St
  + PFL 26 (Buchse) - 1 St
