der-kollege/My_kicad_hardware/FPGA_Board_BA/exports/Drawings/FPGA_Board_BA-User_Comments.dxf

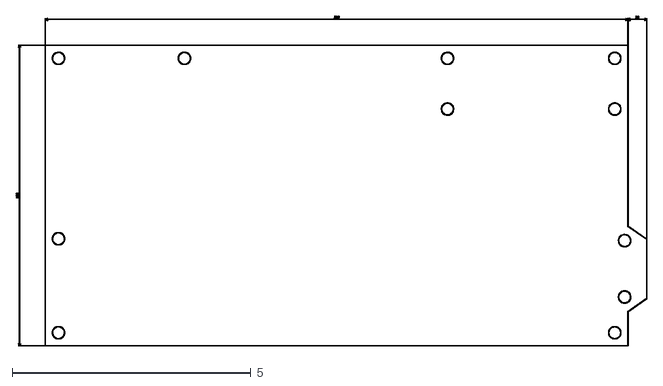
[picture p13: CAD file, 2026-03-02]
FPGA_Board_BA/exports/Drawings/FPGA_Board_BA-User_Comments.dxf
13.2 x 6.91
