der-kollege/My_kicad_hardware/FPGA_Board_BA/exports/Drawings/FPGA_Board_BA-User_Drawings.dxf

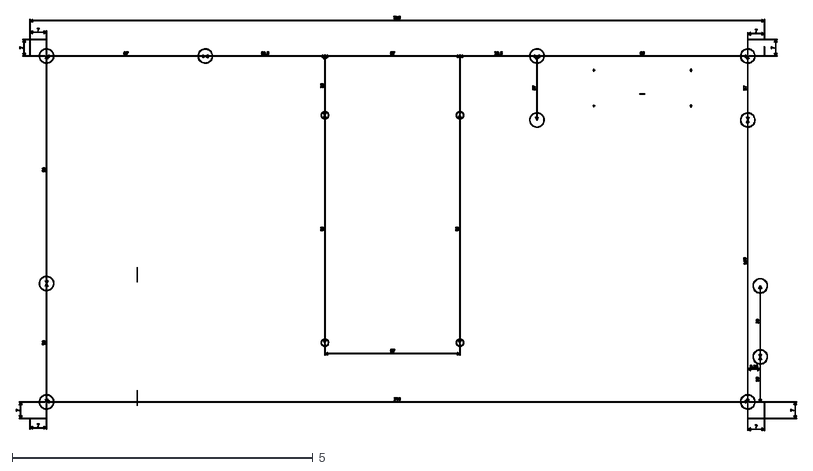
[picture p14: CAD file, 2026-03-02]
FPGA_Board_BA/exports/Drawings/FPGA_Board_BA-User_Drawings.dxf
13.0 x 6.89
