der-kollege/My_kicad_hardware/FPGA_Board_BA/PCB/FPGA_Board_BA.kicad_pcb

## KiCad design FPGA_Board_BA/PCB/FPGA_Board_BA.kicad_pcb (2025-12-30)

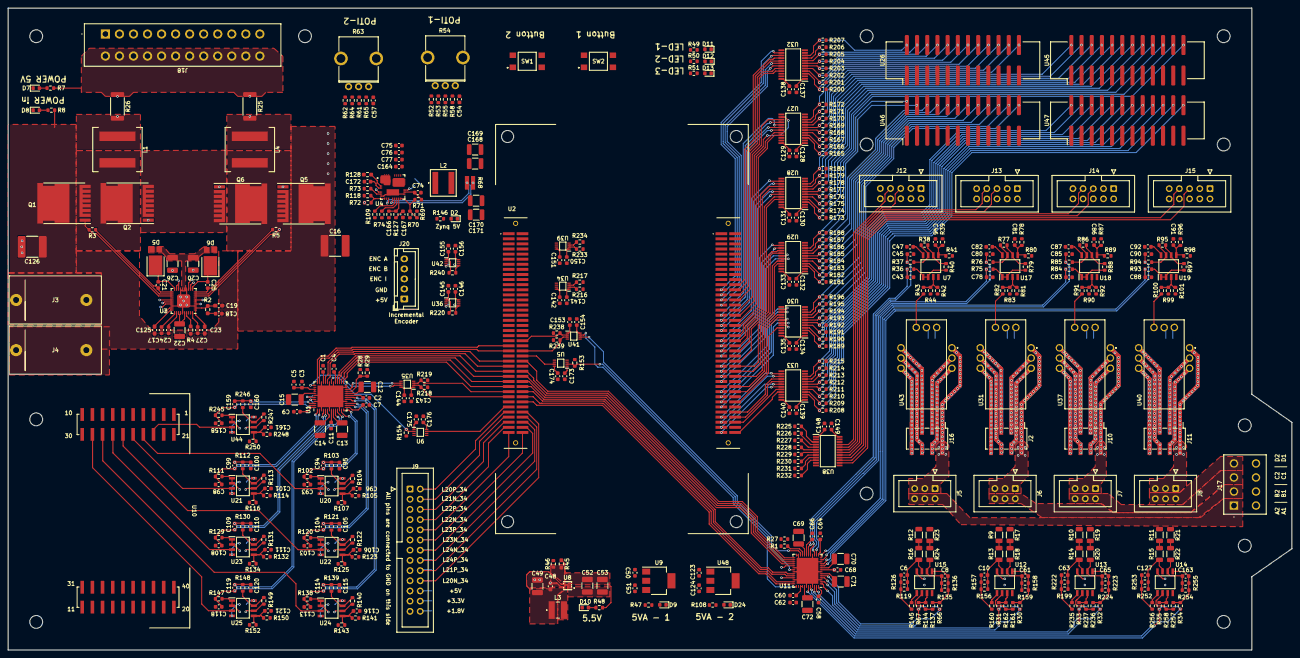
[picture p15: board FPGA_Board_BA.kicad_pcb from above]

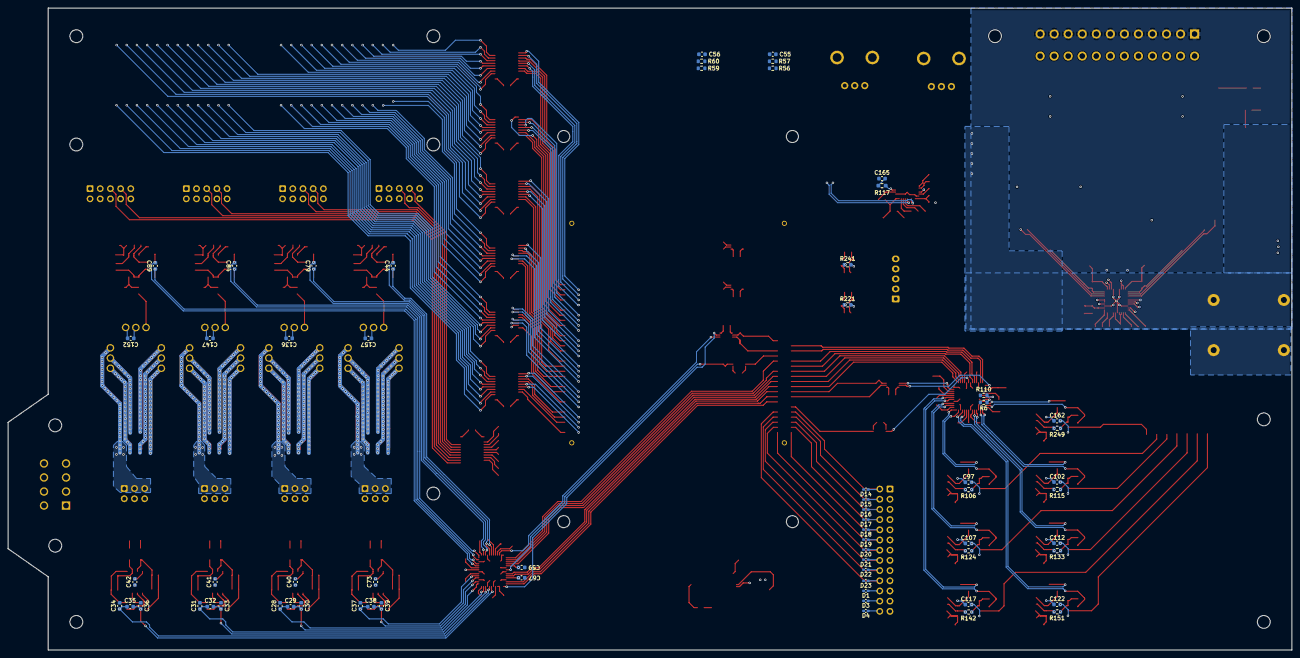
[picture p16: board FPGA_Board_BA.kicad_pcb from below]

Board: 4 copper layers, 320.0 x 160.0 mm, 524 parts (65 on the bottom side), 390 nets.

Parts:
C1, C2, C11, C24, C50, C51, C58, C59, C68, C123, C124: 1u_0603; C_0603
C3, C4, C5, C6, C7, C8, C9, C10, C40, C41, C42, C46, C47, C48, C54, C55, C56, C57, C60, C61, C62, C63, C64, C65, C66, C67, C73, C81, C82, C86, C87, C91, C92, C96, C97, C101, C102, C106, C107, C111, C112, C116, C117, C121, C122, C127, C128, C129, C130, C131, C132, C133, C134, C135, C136, C137, C138, C139, C140, C141, C142, C143, C144, C145, C146, C147, C148, C149, C150, C151, C152, C153, C154, C155, C156, C157, C161, C162, C163, C173, C174, C175, C176: 100n_0603; C_0603
C12, C13, C14, C15, C20, C22, C26, C49, C52, C53, C69, C70, C71, C72: 10u_1210; C_1210
C16, C126: 25uF_2220; C_2220_5650Metric_Pad1.97x5.40mm_HandSolder
C17, C21, C25, C27, C75, C76, C77, C164, C165: 4u7_0603; C_0603
C18: 1n_0603; C_0603
C19: 56pF_0603; C_0603_1608Metric_Pad1.08x0.95mm_HandSolder
C23, C125: 120nF_0603; C_0603_1608Metric_Pad1.08x0.95mm_HandSolder
C28, C29, C30, C31, C32, C33, C34, C35, C36, C37, C38, C39, C43, C44, C45, C78, C79, C80, C83, C84, C85, C88, C89, C90, C93, C94, C95, C98, C99, C100, C103, C104, C105, C108, C109, C110, C113, C114, C115, C118, C119, C120, C158, C159, C160: 15p_0603; C_0603
C74: 470n_0603; C_0603
C166: 220p_0603; R_0603_1608Metric
C167, C172: 15n_0603; C_0603
C168, C169, C170, C171: 47u_1210; C_1210_3225Metric
D1, D3, D4, D14, D15, D16, D17, D18, D19, D20, D21, D22, D23: B72590D50H160; C_0402_1005Metric_Pad0.74x0.62mm_HandSolder
D2, D7, D8, D9, D10, D12, D24: LED_G_0603; LED_0603_1608Metric
D5, D6: SBR10U200P5-13; SBR10U200P5
D11: LED_B_0603; LED_0603_1608Metric
D13: LED_R_0603; LED_0603_1608Metric
J2, J10, J11, J16: PinHeader_2x4_SMD; PinHeader_2x04_P2.54mm_Vertical_SMD
J3: Banana_Socket_Red; Banana_Socket_Altech_Red
J4: Banana_Socket_Black; Banana_Socket_Aletch_Black
J5, J6, J7, J8: Box_Header_6pin; IDC-Header_2x03_P2.54mm_Vertical
J9: Box_Header_26pin; IDC-Header_2x13_P2.54mm_Vertical
J12, J13, J14, J15: Box_Header_2x05_THT; IDC-Header_2x05_P2.54mm_Vertical
J17: Plug_Terminal_2x4_Vertical
J18: Plug_Terminal_2x12pin; DMCV 1,5_12-G1F-3,5-LR P20THR
J20: JST_XH_05_vertical; JST_XH_B5B-XH-A_1x05_P2.50mm_Vertical
L1, L4: XAL1010-152MED; L_Coilcraft_XAL1010-XXX
L2: Inductor 5.6uH; L_5u6_78439346056
L3: SMD_Inductor_1u; 74404043010A
Q1, Q2, Q5, Q6: IPT017N12NM6; Infineon_PG-HSOF-8-1
R1, R27, R28, R29, R72, R118, R220, R221, R240, R241: 0R_0603; R_0603_1608Metric
R2: 25k5_0603; R_0603_1608Metric_Pad0.98x0.95mm_HandSolder
R3, R5: 2R2_0603; R_0603_1608Metric
R4: 39k2_0603; R_0603_1608Metric_Pad0.98x0.95mm_HandSolder
R6, R43, R82, R91, R100, R110, R119, R126, R135, R136, R137, R144, R145, R156, R157, R158, R159, R160, R161, R162, R199, R222, R223, R224, R235, R236, R237, R252, R253, R254, R255, R256, R257, R258: 1k_0603; R_0603_1608Metric
R7, R47, R48, R49, R50, R51, R52, R53, R55, R57, R60, R61, R62, R64, R70, R108, R146, R153, R154, R165, R166, R167, R168, R169, R170, R171, R172, R173, R174, R175, R176, R177, R178, R179, R180, R181, R182, R183, R184, R185, R186, R187, R188, R189, R190, R191, R192, R193, R194, R195, R196, R200, R201, R202, R203, R204, R205, R206, R207, R208, R209, R210, R211, R212, R213, R214, R215, R216, R217, R218, R219, R225, R226, R227, R228, R229, R230, R231, R232, R233, R234, R238, R239: 10k_0603; R_0603_1608Metric
R8, R46, R73: 100k_0603; R_0603_1608Metric
R9, R10, R11, R12, R13, R14, R15, R16, R17, R18, R19, R20, R21, R22, R23, R24: 100k_1206; R_1206_3216Metric
R25, R26: 0R002_2512; R_2512_6332Metric
R30, R31, R32, R33, R34, R35, R36, R37, R66, R67, R75, R76, R84, R85, R93, R94, R102, R103, R111, R112, R120, R121, R129, R130, R138, R139, R147, R148, R245, R246: 30R_0603; R_0603_1608Metric
R38, R40, R77, R79, R86, R88, R95, R97, R104, R106, R113, R115, R122, R124, R131, R133, R140, R142, R149, R151, R247, R249: 500R_0603; R_0603_1608Metric
R39, R41, R78, R80, R87, R89, R96, R98, R105, R107, R114, R116, R123, R125, R132, R134, R141, R143, R150, R152, R248, R250: 5k1_0603; R_0603_1608Metric
R42, R44, R81, R83, R90, R92, R99, R101: 9k1_0603; R_0603_1608Metric
R45: 820k_0603; R_0603_1608Metric_Pad0.98x0.95mm_HandSolder
R54, R63: Poti_10k; RK09D1130A1N
R56, R58, R59, R65: 100R_0603; R_0603_1608Metric
R68: Shunt_0R006; PRL1632-R006-F-T1
R69: 52K3_0603; R_0603_1608Metric
R71: 24k9_0603; R_0603_1608Metric
R74: 71k5_0603; R_0603_1608Metric
R109: 41k2_0603; R_0603_1608Metric
R117, R128: 1R_0603; R_0603_1608Metric_Pad0.98x0.95mm_HandSolder
R127: 3k83_0603; R_0603_1608Metric
SW1, SW2: TL3305BF100QG; TL3305BF160QG
U1, U11: LTC2320-16_CMOS; UKG_52_7mm_8mm
U2: Zynq7020
U3: LM5143; VQFN 40 pin 5.8mm x 5.8mm
U4: LM70860RRXR; RRX Package, 29-Pin VQFN
U5, U6, U34, U35, U36, U39, U41, U42: SN74LXC2T45Q1; SN74LXC2T45QDCURQ1
U7, U12, U13, U14, U15, U17, U18, U19, U20, U21, U22, U23, U24, U25, U44: 1819_IS8; LT1819
U8: TPS61022
U9, U48: MCP1703AT-5002EDB; SOT-223
U10: BOOSTXL-3PHGANINV; TI_BOOSTXL_3PH
U26, U45, U46, U47: BoxHeader_24pin; IDC-Header_2x12_P2.54mm_Vertical_SMD
U27, U28, U29, U30, U32, U33, U38: SN74LXCH8T245RHLR; SN74LXCH8T245
U31, U37, U40, U43: S22P006S05; Tamura_S22P006S05

Connections:
+1V8: C1.1, C4.1, C59.1, C67.1, C144.1, C154.1, C173.2, C175.2, D4.1 (A1), J9.26, R1.2, R28.2, U1.31 (OVDD), U1.37 (OVDD), U2.b9 (XADC_VCC), U5.1 (VCCA), U6.1 (VCCA), U11.31 (OVDD), U11.37 (OVDD), U35.8 (VCCB), U41.8 (VCCB)
+3.3V: C129.1, C131.1, C133.1, C135.1, C138.1, C140.1, C142.1, C143.2, C146.1, C148.2, C151.1, C153.2, C156.1, C174.1, C176.1, D3.1 (A1), J9.24, R218.1, R219.1, R225.1, R226.1, R227.1, R228.1, R229.1, R230.1, R231.1, R232.1, R238.1, R239.1, SW1.3, SW1.4, SW2.3, SW2.4, U2.a3 (VDD_3V), U2.b3 (VDD_3V), U5.8 (VCCB), U6.8 (VCCB), U27.23 (V_{CCB}), U27.24 (V_{CCB}), U28.23 (V_{CCB}), U28.24 (V_{CCB}), U29.23 (V_{CCB}), U29.24 (V_{CCB}), U30.23 (V_{CCB}), U30.24 (V_{CCB}), U32.23 (V_{CCB}), U32.24 (V_{CCB}), U33.23 (V_{CCB}), U33.24 (V_{CCB}), U34.8 (VCCB), U35.1 (VCCA), U36.8 (VCCB), U38.1 (V_{CCA}), U38.2 (DIR), U39.8 (VCCB), U41.1 (VCCA), U42.8 (VCCB)
+5V: C48.1, C49.1, C128.2, C130.2, C132.2, C134.2, C137.2, C139.2, C141.2, C145.2, C149.1, C150.2, C155.2, D1.1 (A1), J9.22, J12.9, J12.10, J13.9, J13.10, J14.9, J14.10, J15.9, J15.10, J18.2, J18.4, J18.6, J18.8, J18.10, J18.12, J18.14, J18.16, J18.18, J18.20, J18.22, J18.24, J20.1, L3.1, R7.1, R25.1, R26.1, R165.1, R166.1, R167.1, R168.1, R169.1, R170.1, R171.1, R172.1, R173.1, R174.1, R175.1, R176.1, R177.1, R178.1, R179.1, R180.1, R181.1, R182.1, R183.1, R184.1, R185.1, R186.1, R187.1, R188.1, R189.1, R190.1, R191.1, R192.1, R193.1, R194.1, R195.1, R196.1, R200.1, R201.1, R202.1, R203.1, R204.1, R205.1, R206.1, R207.1, R208.1, R209.1, R210.1, R211.1, R212.1, R213.1, R214.1, R215.1, R216.1, R217.1, R220.1, R233.1, R234.1, R240.1, U3.5 (VOUT2), U3.6 (VCCX), U3.26 (VOUT1), U8.5 (EN), U8.7 (VIN), U27.1 (V_{CCA}), U27.2 (DIR), U28.1 (V_{CCA}), U28.2 (DIR), U29.1 (V_{CCA}), U29.2 (DIR), U30.1 (V_{CCA}), U30.2 (DIR), U32.1 (V_{CCA}), U32.2 (DIR), U33.1 (V_{CCA}), U33.2 (DIR), U34.1 (VCCA), U36.1 (VCCA), U38.23 (V_{CCB}), U38.24 (V_{CCB}), U39.1 (VCCA), U42.1 (VCCA)
+5VA: C2.1, C3.1, C5.1, C7.1, C9.1, C40.2, C41.2, C42.2, C47.1, C51.1, C58.1, C60.1, C62.1, C64.1, C66.1, C73.2, C82.1, C87.1, C92.1, C97.1, C102.1, C107.1, C112.1, C117.1, C122.1, C162.1, R47.1, R52.1, R53.1, R55.1, R61.1, R62.1, R64.1, U1.15 (VDD), U1.21 (VDD), U1.43 (REFBUFEN), U1.44 (VDD), U1.52 (VDD), U7.8 (V+), U9.3 (Vout), U11.15 (VDD), U11.21 (VDD), U11.43 (REFBUFEN), U11.44 (VDD), U11.52 (VDD), U12.4 (V-), U13.4 (V-), U14.4 (V-), U15.4 (V-), U17.8 (V+), U18.8 (V+), U19.8 (V+), U20.8 (V+), U21.8 (V+), U22.8 (V+), U23.8 (V+), U24.8 (V+), U25.8 (V+), U44.8 (V+)
+5VA_2: C124.1, C136.2, C147.2, C152.2, C157.2, R108.1, U31.9 (5V), U37.9 (5V), U40.9 (5V), U43.9 (5V), U48.3 (Vout)
+5V_Zynq: C168.2, C169.2, C170.2, C171.2, R68.2, R69.1, R146.1, U2.a1 (VDD_5V), U2.b1 (VDD_5V), U4.6 (BIAS), U4.12 (Vout)
/ADC for B6/CLK_IN: R218.2, U2.a65 (IO_L16N_T2_34), U35.2 (A1)
/ADC for B6/CLK_OUT: U2.a69 (IO_L18N_T2_34), U6.7 (B1)
/ADC for B6/Diffamp_1/Ain+: C158.1, C159.1, R245.1, U1.51 (Ain7+)
/ADC for B6/Diffamp_1/Ain-: C159.2, C160.1, R246.1, U1.50 (Ain7-)
/ADC for B6/Diffamp_2/Ain+: C93.1, C94.1, R102.1, U1.14 (Ain3+)
/ADC for B6/Diffamp_2/Ain-: C94.2, C95.1, R103.1, U1.13 (Ain3-)
/ADC for B6/Diffamp_3/Ain+: C98.1, C99.1, R111.1, U1.2 (Ain6+)
/ADC for B6/Diffamp_3/Ain-: C99.2, C100.1, R112.1, U1.1 (Ain6-)
/ADC for B6/Diffamp_4/Ain+: C103.1, C104.1, R120.1, U1.17 (Ain2+)
/ADC for B6/Diffamp_4/Ain-: C104.2, C105.1, R121.1, U1.16 (Ain2-)
/ADC for B6/Diffamp_5/Ain+: C108.1, C109.1, R129.1, U1.5 (Ain5+)
/ADC for B6/Diffamp_5/Ain-: C109.2, C110.1, R130.1, U1.4 (Ain5-)
/ADC for B6/Diffamp_6/Ain+: C113.1, C114.1, R138.1, U1.20 (Ain1+)
/ADC for B6/Diffamp_6/Ain-: C114.2, C115.1, R139.1, U1.19 (Ain1-)
/ADC for B6/Diffamp_7/Ain+: C118.1, C119.1, R147.1, U1.11 (Ain4+)
/ADC for B6/Diffamp_7/Ain-: C119.2, C120.1, R148.1, U1.10 (Ain4-)
/ADC for B6/I_A: U10.27 (IA), U23.3 (+)
/ADC for B6/I_B: U10.28 (IB), U24.3 (+)
/ADC for B6/I_C: U10.29 (IC), U25.3 (+)
/ADC for B6/LS CLKOUT/A1: R154.1, U1.33 (CLKOUT+), U6.2 (A1)
/ADC for B6/Level Shift for DIO/B1: U1.41 (SCK), U35.7 (B1)
/ADC for B6/Level Shift for DIO/B2: U1.24 (~CNV), U35.6 (B2)
/ADC for B6/SDO1: U1.27 (SDO1), U2.a59 (IO_L14P_T2_34)
/ADC for B6/SDO2: U1.28 (SDO2), U2.a61 (IO_L14N_T2_34)
/ADC for B6/SDO3: U1.29 (SDO3), U2.a57 (IO_L12N_T1_34)
/ADC for B6/SDO4: U1.30 (SDO4), U2.a55 (IO_L12P_T1_34)
/ADC for B6/SDO5: U1.35 (SDO5), U2.a53 (IO_L9N_T2_34)
/ADC for B6/SDO6: U1.36 (SDO6), U2.a51 (IO_L9P_T1_34)
/ADC for B6/SDO7: U1.39 (SDO7), U2.a47 (IO_L11N_T1_34)
/ADC for B6/SDO8: U1.40 (SDO8), U2.a43 (IO_L8N_T1_34)
/ADC for B6/V_A: U10.24 (VA), U20.3 (+)
/ADC for B6/V_B: U10.25 (VB), U21.3 (+)
/ADC for B6/V_C: U10.26 (VC), U22.3 (+)
/ADC for B6/V_DC: U10.23 (VDC), U44.3 (+)
/ADC for B6/~CNV: R219.2, U2.a63 (IO_L16P_T2_34), U35.3 (A2)
/ADC for Machine/CLK_IN_1: R238.2, U2.a46 (IO_L10P_T1_34), U41.2 (A1)
/ADC for Machine/CLK_OUT_1: U2.a50 (IO_L13P_T2_34), U5.7 (B1)
/ADC for Machine/Diffamp5/Ain+: C43.1, C44.1, R36.1, U11.20 (Ain1+)
/ADC for Machine/Diffamp5/Ain-: C44.2, C45.1, R37.1, U11.19 (Ain1-)
/ADC for Machine/Diffamp6/Ain+: C78.1, C79.1, R75.1, U11.17 (Ain2+)
/ADC for Machine/Diffamp6/Ain-: C79.2, C80.1, R76.1, U11.16 (Ain2-)
/ADC for Machine/Diffamp7/Ain+: C83.1, C84.1, R84.1, U11.14 (Ain3+)
/ADC for Machine/Diffamp7/Ain-: C84.2, C85.1, R85.1, U11.13 (Ain3-)
/ADC for Machine/Diffamp8/Ain+: C88.1, C89.1, R93.1, U11.11 (Ain4+)
/ADC for Machine/Diffamp8/Ain-: C89.2, C90.1, R94.1, U11.10 (Ain4-)
/ADC for Machine/LS CLKOUT/A1: R153.1, U5.2 (A1), U11.33 (CLKOUT+)
/ADC for Machine/Level Shift for DIO/B1: U11.41 (SCK), U41.7 (B1)
/ADC for Machine/Level Shift for DIO/B2: U11.24 (~CNV), U41.6 (B2)
/ADC for Machine/SDO1_1: U2.a52 (IO_L13N_T2_34), U11.27 (SDO1)
/ADC for Machine/SDO2_1: U2.a56 (IO_L15P_T2_34), U11.28 (SDO2)
/ADC for Machine/SDO3_1: U2.a58 (IO_L15N_T2_34), U11.29 (SDO3)
/ADC for Machine/SDO4_1: U2.a60 (IO_L17P_T2_34), U11.30 (SDO4)
/ADC for Machine/SDO5_1: U2.a62 (IO_L17N_T2_34), U11.35 (SDO5)
/ADC for Machine/SDO6_1: U2.a64 (IO_L19P_T3_34), U11.36 (SDO6)
/ADC for Machine/SDO7_1: U2.a66 (IO_L19N_T3_34), U11.39 (SDO7)
/ADC for Machine/SDO8_1: U2.a70 (IO_L18P_T2_34), U11.40 (SDO8)
/ADC for Machine/~CNV_1: R239.2, U2.a48 (IO_L10N_T1_34), U41.3 (A2)
/Analog Voltage/5.5V: C50.1, C52.1, C53.1, C123.1, R45.1, R48.1, U8.3 (VOUT), U9.1 (Vin), U48.1 (Vin)
/CHB Communication/En_Ph1: R225.2, U38.3 (A1)
/CHB Communication/En_Ph2: R227.2, U38.5 (A3)
/CHB Communication/En_Ph3: R229.2, U38.7 (A5)
/CHB Communication/En_Ph4: R231.2, U38.9 (A7)
/CHB Communication/Level_Shifter_8bit_1/A1: R200.2, U26.16, U32.3 (A1)
/CHB Communication/Level_Shifter_8bit_1/A2: R201.2, U26.14, U32.4 (A2)
/CHB Communication/Level_Shifter_8bit_1/A3: R202.2, U26.12, U32.5 (A3)
/CHB Communication/Level_Shifter_8bit_1/A4: R203.2, U26.10, U32.6 (A4)
/CHB Communication/Level_Shifter_8bit_1/A5: R204.2, U26.8, U32.7 (A5)
/CHB Communication/Level_Shifter_8bit_1/A6: R205.2, U26.6, U32.8 (A6)
/CHB Communication/Level_Shifter_8bit_1/A7: R206.2, U26.4, U32.9 (A7)
/CHB Communication/Level_Shifter_8bit_2/A1: R165.2, U27.3 (A1), U45.8
/CHB Communication/Level_Shifter_8bit_2/A2: R166.2, U27.4 (A2), U45.6
/CHB Communication/Level_Shifter_8bit_2/A3: R167.2, U27.5 (A3), U45.4
/CHB Communication/Level_Shifter_8bit_2/A5: R169.2, U26.24, U27.7 (A5)
/CHB Communication/Level_Shifter_8bit_2/A6: R170.2, U26.22, U27.8 (A6)
/CHB Communication/Level_Shifter_8bit_2/A7: R171.2, U26.20, U27.9 (A7)
/CHB Communication/Level_Shifter_8bit_2/A8: R172.2, U26.18, U27.10 (A8)
/CHB Communication/Level_Shifter_8bit_3/A1: R173.2, U28.3 (A1), U45.24
/CHB Communication/Level_Shifter_8bit_3/A2: R174.2, U28.4 (A2), U45.22
/CHB Communication/Level_Shifter_8bit_3/A3: R175.2, U28.5 (A3), U45.20
/CHB Communication/Level_Shifter_8bit_3/A4: R176.2, U28.6 (A4), U45.18
/CHB Communication/Level_Shifter_8bit_3/A5: R177.2, U28.7 (A5), U45.16
/CHB Communication/Level_Shifter_8bit_3/A6: R178.2, U28.8 (A6), U45.14
/CHB Communication/Level_Shifter_8bit_3/A7: R179.2, U28.9 (A7), U45.12
/CHB Communication/Level_Shifter_8bit_3/A8: R180.2, U28.10 (A8), U45.10
/CHB Communication/Level_Shifter_8bit_4/A1: R181.2, U29.3 (A1), U46.16
/CHB Communication/Level_Shifter_8bit_4/A2: R182.2, U29.4 (A2), U46.14
/CHB Communication/Level_Shifter_8bit_4/A3: R183.2, U29.5 (A3), U46.12
/CHB Communication/Level_Shifter_8bit_4/A4: R184.2, U29.6 (A4), U46.10
/CHB Communication/Level_Shifter_8bit_4/A5: R185.2, U29.7 (A5), U46.8
/CHB Communication/Level_Shifter_8bit_4/A6: R186.2, U29.8 (A6), U46.6
/CHB Communication/Level_Shifter_8bit_4/A7: R187.2, U29.9 (A7), U46.4
/CHB Communication/Level_Shifter_8bit_5/A1: R189.2, U30.3 (A1), U47.8
/CHB Communication/Level_Shifter_8bit_5/A2: R190.2, U30.4 (A2), U47.6
/CHB Communication/Level_Shifter_8bit_5/A3: R191.2, U30.5 (A3), U47.4
/CHB Communication/Level_Shifter_8bit_5/A5: R193.2, U30.7 (A5), U46.24
/CHB Communication/Level_Shifter_8bit_5/A6: R194.2, U30.8 (A6), U46.22
/CHB Communication/Level_Shifter_8bit_5/A7: R195.2, U30.9 (A7), U46.20
/CHB Communication/Level_Shifter_8bit_5/A8: R196.2, U30.10 (A8), U46.18
/CHB Communication/Level_Shifter_8bit_6/A1: R208.2, U33.3 (A1), U47.24
/CHB Communication/Level_Shifter_8bit_6/A2: R209.2, U33.4 (A2), U47.22
/CHB Communication/Level_Shifter_8bit_6/A3: R210.2, U33.5 (A3), U47.20
/CHB Communication/Level_Shifter_8bit_6/A4: R211.2, U33.6 (A4), U47.18
/CHB Communication/Level_Shifter_8bit_6/A5: R212.2, U33.7 (A5), U47.16
/CHB Communication/Level_Shifter_8bit_6/A6: R213.2, U33.8 (A6), U47.14
/CHB Communication/Level_Shifter_8bit_6/A7: R214.2, U33.9 (A7), U47.12
/CHB Communication/Level_Shifter_8bit_6/A8: R215.2, U33.10 (A8), U47.10
/CHB Communication/Level_shifter_Rx_En/B1: J12.7, U38.21 (B1)
/CHB Communication/Level_shifter_Rx_En/B2: J12.5, U38.20 (B2)
/CHB Communication/Level_shifter_Rx_En/B3: J13.7, U38.19 (B3)
/CHB Communication/Level_shifter_Rx_En/B4: J13.5, U38.18 (B4)
/CHB Communication/Level_shifter_Rx_En/B5: J14.7, U38.17 (B5)
/CHB Communication/Level_shifter_Rx_En/B6: J14.5, U38.16 (B6)
/CHB Communication/Level_shifter_Rx_En/B7: J15.7, U38.15 (B7)
/CHB Communication/Level_shifter_Rx_En/B8: J15.5, U38.14 (B8)
/CHB Communication/Level_shifter_error_1/A1: J12.1, R233.2, U39.2 (A1)
/CHB Communication/Level_shifter_error_1/A2: J13.1, R234.2, U39.3 (A2)
/CHB Communication/Level_shifter_error_2/A1: J14.1, R216.2, U34.2 (A1)
/CHB Communication/Level_shifter_error_2/A2: J15.1, R217.2, U34.3 (A2)
/CHB Communication/Ph_A_Tx1: U2.b23 (IO_L1P_T0_35), U32.14 (B8)
/CHB Communication/Ph_A_Tx1_5V: J12.3, R207.2, U26.2, U32.10 (A8)
/CHB Communication/Ph_A_Tx2: U2.b25 (IO_L1N_T0_35), U32.15 (B7)
/CHB Communication/Ph_A_Tx3: U2.b22 (IO_L2P_T0_35), U32.16 (B6)
/CHB Communication/Ph_A_Tx4: U2.b24 (IO_L2N_T0_35), U32.17 (B5)
/CHB Communication/Ph_A_Tx5: U2.b27 (IO_L3P_T0_35), U32.18 (B4)
/CHB Communication/Ph_A_Tx6: U2.b29 (IO_L3N_T0_35), U32.19 (B3)
/CHB Communication/Ph_A_Tx7: U2.b26 (IO_L4P_T0_35), U32.20 (B2)
/CHB Communication/Ph_A_Tx8: U2.b28 (IO_L4N_T0_35), U32.21 (B1)
/CHB Communication/Ph_A_Tx9: U2.b34 (IO_L6N_T0_35), U27.14 (B8)
/CHB Communication/Ph_A_Tx10: U2.b32 (IO_L6P_T0_35), U27.15 (B7)
/CHB Communication/Ph_A_Tx11: U2.b35 (IO_L5N_T0_35), U27.16 (B6)
/CHB Communication/Ph_A_Tx12: U2.b33 (IO_L5P_T0_35), U27.17 (B5)
/CHB Communication/Ph_B_Tx1: U2.b37 (IO_L7P_T1_35), U27.18 (B4)
/CHB Communication/Ph_B_Tx1_5V: J13.3, R168.2, U27.6 (A4), U45.2
/CHB Communication/Ph_B_Tx2: U2.b39 (IO_L7N_T1_35), U27.19 (B3)
/CHB Communication/Ph_B_Tx3: U2.b36 (IO_L8P_T1_35), U27.20 (B2)
/CHB Communication/Ph_B_Tx4: U2.b38 (IO_L8N_T1_35), U27.21 (B1)
/CHB Communication/Ph_B_Tx5: U2.b43 (IO_L9P_T1_35), U28.14 (B8)
/CHB Communication/Ph_B_Tx6: U2.b45 (IO_L9N_T1_35), U28.15 (B7)
/CHB Communication/Ph_B_Tx7: U2.b42 (IO_L10P_T1_35), U28.16 (B6)
/CHB Communication/Ph_B_Tx8: U2.b44 (IO_L10N_T1_35), U28.17 (B5)
/CHB Communication/Ph_B_Tx9: U2.b47 (IO_L11P_T1_35), U28.18 (B4)
/CHB Communication/Ph_B_Tx10: U2.b49 (IO_L11N_T1_35), U28.19 (B3)
/CHB Communication/Ph_B_Tx11: U2.b46 (IO_L12P_T1_35), U28.20 (B2)
/CHB Communication/Ph_B_Tx12: U2.b48 (IO_L12N_T1_35), U28.21 (B1)
/CHB Communication/Ph_C_Tx1: U2.b53 (IO_L13P_35), U29.14 (B8)
/CHB Communication/Ph_C_Tx1_5V: J14.3, R188.2, U29.10 (A8), U46.2
/CHB Communication/Ph_C_Tx2: U2.b55 (IO_L13N_35), U29.15 (B7)
/CHB Communication/Ph_C_Tx3: U2.b52 (IO_L14P_T2_35), U29.16 (B6)
/CHB Communication/Ph_C_Tx4: U2.b54 (IO_L14N_T2_35), U29.17 (B5)
/CHB Communication/Ph_C_Tx5: U2.b57 (IO_L15P_T2_35), U29.18 (B4)
/CHB Communication/Ph_C_Tx6: U2.b59 (IO_L15N_T2_35), U29.19 (B3)
/CHB Communication/Ph_C_Tx7: U2.b56 (IO_L16P_T2_35), U29.20 (B2)
/CHB Communication/Ph_C_Tx8: U2.b58 (IO_L16N_T2_35), U29.21 (B1)
/CHB Communication/Ph_C_Tx9: U2.b63 (IO_L17P_T2_35), U30.14 (B8)
/CHB Communication/Ph_C_Tx10: U2.b65 (IO_L17N_T2_35), U30.15 (B7)
/CHB Communication/Ph_C_Tx11: U2.b62 (IO_L18P_T2_35), U30.16 (B6)
/CHB Communication/Ph_C_Tx12: U2.b64 (IO_L18N_T2_35), U30.17 (B5)
/CHB Communication/Ph_D_Tx1: U2.b67 (IO_L19P_T3_35), U30.18 (B4)
/CHB Communication/Ph_D_Tx1_5V: J15.3, R192.2, U30.6 (A4), U47.2
/CHB Communication/Ph_D_Tx2: U2.b69 (IO_L19N_T3_35), U30.19 (B3)
/CHB Communication/Ph_D_Tx3: U2.b66 (IO_L20P_T3_35), U30.20 (B2)
/CHB Communication/Ph_D_Tx4: U2.b68 (IO_L20N_T3_35), U30.21 (B1)
/CHB Communication/Ph_D_Tx5: U2.b73 (IO_L21P_T3_35), U33.14 (B8)
/CHB Communication/Ph_D_Tx6: U2.b75 (IO_L21N_T3_35), U33.15 (B7)
/CHB Communication/Ph_D_Tx7: U2.b72 (IO_L22P_T3_35), U33.16 (B6)
/CHB Communication/Ph_D_Tx8: U2.b74 (IO_L22N_T3_35), U33.17 (B5)
/CHB Communication/Ph_D_Tx9: U2.b77 (IO_L23P_T3_35), U33.18 (B4)
/CHB Communication/Ph_D_Tx10: U2.b79 (IO_L23N_T3_35), U33.19 (B3)
/CHB Communication/Ph_D_Tx11: U2.b76 (IO_L24P_T3_35), U33.20 (B2)
/CHB Communication/Ph_D_Tx12: U2.b78 (IO_L24N_T3_35), U33.21 (B1)
/CHB Communication/Rx_Ph1: R226.2, U38.4 (A2)
/CHB Communication/Rx_Ph2: R228.2, U38.6 (A4)
/CHB Communication/Rx_Ph3: R230.2, U38.8 (A6)
/CHB Communication/Rx_Ph4: R232.2, U38.10 (A8)
/CHB to 3Ph/Ph_A2_out: J5.2, J5.4, J5.6, J17.1, R23.1
/CHB to 3Ph/Ph_B2_out: J6.2, J6.4, J6.6, J17.2 (Pin_3), R17.1
/CHB to 3Ph/Ph_C2_out: J7.2, J7.4, J7.6, J17.3 (Pin_5), R19.1
/CHB to 3Ph/Ph_D2_out: J8.2, J8.4, J8.6, J17.4 (Pin_7), R21.1
/Current measure/Tamura_1/pin1: J5.1, J5.3, J5.5, J16.1, J16.2, U43.1 (In_1)
/Current measure/Tamura_1/pin2: J16.3, U43.2 (In_2)
/Current measure/Tamura_1/pin3: J16.4, U43.3 (In_3)
/Current measure/Tamura_1/pin4: J16.7, J16.8, J17.5 (Pin_2), R12.1, U43.4 (Out_1)
/Current measure/Tamura_1/pin5: J16.6, U43.5 (Out_2)
/Current measure/Tamura_1/pin6: J16.5, U43.6 (Out_3)
/Current measure/Tamura_2/pin1: J2.1, J2.2, J6.1, J6.3, J6.5, U31.1 (In_1)
/Current measure/Tamura_2/pin2: J2.3, U31.2 (In_2)
/Current measure/Tamura_2/pin3: J2.4, U31.3 (In_3)
/Current measure/Tamura_2/pin4: J2.7, J2.8, J17.6 (Pin_4), R9.1, U31.4 (Out_1)
/Current measure/Tamura_2/pin5: J2.6, U31.5 (Out_2)
/Current measure/Tamura_2/pin6: J2.5, U31.6 (Out_3)
/Current measure/Tamura_3/pin1: J7.1, J7.3, J7.5, J10.1, J10.2, U37.1 (In_1)
/Current measure/Tamura_3/pin2: J10.3, U37.2 (In_2)
/Current measure/Tamura_3/pin3: J10.4, U37.3 (In_3)
/Current measure/Tamura_3/pin4: J10.7, J10.8, J17.7 (Pin_6), R10.1, U37.4 (Out_1)
/Current measure/Tamura_3/pin5: J10.6, U37.5 (Out_2)
/Current measure/Tamura_3/pin6: J10.5, U37.6 (Out_3)
/Current measure/Tamura_4/pin1: J8.1, J8.3, J8.5, J11.1, J11.2, U40.1 (In_1)
/Current measure/Tamura_4/pin2: J11.3, U40.2 (In_2)
/Current measure/Tamura_4/pin3: J11.4, U40.3 (In_3)
/Current measure/Tamura_4/pin4: J11.7, J11.8, J17.8, R11.1, U40.4 (Out_1)
/Current measure/Tamura_4/pin5: J11.6, U40.5 (Out_2)
/Current measure/Tamura_4/pin6: J11.5, U40.6 (Out_3)
/Encoder/ENC_A_5V: J20.5, U42.2 (A1)
/Encoder/ENC_B_5V: J20.4, U42.3 (A2)
/Encoder/ENC_I_5V: J20.3, U36.2 (A1)
/FPGA/B6_En: U2.a16 (IO_L14P_T2_13), U10.13 (En)
/FPGA/Button1: C55.1, R56.2, R57.1
/FPGA/Button2: C56.1, R59.2, R60.1
/FPGA/Freepin1: D23.1 (A1), J9.20, U2.a72 (IO_L20N_T3_34)
/FPGA/Freepin2: D22.1 (A1), J9.18, U2.a74 (IO_L21P_T3_34)
/FPGA/Freepin3: D21.1 (A1), J9.16, U2.a76 (IO_L24P_T3_34)
/FPGA/Freepin4: D20.1 (A1), J9.14, U2.a78 (IO_L24N_T3_34)
/FPGA/Freepin5: D19.1 (A1), J9.12, U2.a80 (IO_L23N_T3_34)
/FPGA/Freepin6: D18.1 (A1), J9.10, U2.a79 (IO_L23P_T3_34)
/FPGA/Freepin7: D17.1 (A1), J9.8, U2.a77 (IO_L22N_T3_34)
/FPGA/Freepin8: D16.1 (A1), J9.6, U2.a75 (IO_L22P_T3_34)
/FPGA/Freepin9: D15.1 (A1), J9.4, U2.a73 (IO_L21N_T3_34)
/FPGA/Freepin10: D14.1 (A1), J9.2, U2.a71 (IO_L20P_T3_34)
/FPGA/OT: U2.a18 (IO_L14N_T2_13), U10.34 (OT)
/FPGA/PWM_AH: U2.a7 (IO_L11P_T1_13), U10.40 (PWM_AH)
/FPGA/PWM_AL: U2.a9 (IO_L11N_T1_13), U10.39 (PWM_AL)
/FPGA/PWM_BH: U2.a11 (IO_L12P_T1_13), U10.38 (PWM_BH)
/FPGA/PWM_BL: U2.a13 (IO_L12N_T1_13), U10.37 (PWM_BL)
/FPGA/PWM_CH: U2.a17 (IO_L13P_T2_13), U10.36 (PWM_CH)
/FPGA/PWM_CL: U2.a19 (IO_L13N_T2_13), U10.35 (PWM_CL)
/FPGA/Poti: R58.2, U2.b5 (XADC_INP0)
/FPGA/Poti2: R65.2, U2.b6 (DXP_0)
/Main_DCDC/Comp1: C19.1, R2.2, U3.2 (COMP2), U3.29 (COMP1)
/Main_DCDC/Leg-1/Gate_H: Q1.1 (G), R3.1, U3.23 (HOL1)
/Main_DCDC/Leg-1/Gate_L: Q2.1 (G), U3.18 (LO1), U3.19 (LOL1)
/Main_DCDC/Leg-1/R_I+: L1.1, R26.2, U3.27 (CS1)
/Main_DCDC/Leg-1/SW: C21.2, L1.2, Q1.2 (S), Q2.3 (D), U3.21 (SW1)
/Main_DCDC/Leg-2/Gate_H: Q5.1 (G), R5.1, U3.8 (HOL2)
/Main_DCDC/Leg-2/Gate_L: Q6.1 (G), U3.12 (LOL2), U3.13 (LO2)
/Main_DCDC/Leg-2/R_I+: L4.1, R25.2, U3.4 (CS2)
/Main_DCDC/Leg-2/SW: C25.2, L4.2, Q5.2 (S), Q6.3 (D), U3.10 (SW2)
/Main_DCDC/Mode: C22.1, U3.33 (DEMB), U3.34 (MODE), U3.36 (VDDA)
/Main_DCDC/Vin: C16.1, C17.1, C27.1, C75.1, C76.1, C77.1, C126.1, C164.1, J3.1, Q1.3 (D), Q5.3 (D), R8.1, R72.1, U3.25 (VIN), U3.31 (EN1), U3.40 (EN2), U4.1 (Vin), U4.2 (Vin), U4.3 (Vin), U4.27 (Vin), U4.28 (Vin), U4.29 (Vin)
/Voltage Measure/PHA_V+: C37.1, C38.1, R66.1
/Voltage Measure/PHA_V-: C38.2, C39.1, R67.1
/Voltage Measure/PHB_V+: C28.1, C29.1, R30.1
/Voltage Measure/PHB_V-: C29.2, C30.1, R31.1
/Voltage Measure/PHC_V+: C31.1, C32.1, R32.1
/Voltage Measure/PHC_V-: C32.2, C33.1, R33.1
/Voltage Measure/PHD_V+: C34.1, C35.1, R34.1
/Voltage Measure/PHD_V-: C35.2, C36.1, R35.1
/Zynq_5V/CBOOT: R128.2, U4.4 (CBOOT)
/Zynq_5V/FB: R69.2, R70.1, R71.1, U4.16 (FB)
/Zynq_5V/SW: C172.2, L2.1, U4.5 (SW), U4.20 (SW), U4.21 (SW), U4.22 (SW)
GND: C1.2, C2.2, C3.2, C4.2, C5.2, C7.2, C9.2, C11.2, C12.2, C13.2, C14.2, C15.2, C16.2, C17.2, C18.2, C19.2, C20.2, C22.2, C23.2, C24.2, C26.2, C27.2, C28.2, C30.2, C31.2, C33.2, C34.2, C36.2, C37.2, C39.2, C40.1, C41.1, C42.1, C43.2, C45.2, C46.2, C47.2, C48.2, C49.2, C50.2, C51.2, C52.2, C53.2, C54.2, C55.2, C56.2, C57.2, C58.2, C59.2, C60.2, C62.2, C64.2, C66.2, C67.2, C68.2, C69.2, C70.2, C71.2, C72.2, C73.1, C74.2, C75.2, C76.2, C77.2, C78.2, C80.2, C81.2, C82.2, C83.2, C85.2, C86.2, C87.2, C88.2, C90.2, C91.2, C92.2, C93.2, C95.2, C96.2, C97.2, C98.2, C100.2, C101.2, C102.2, C103.2, C105.2, C106.2, C107.2, C108.2, C110.2, C111.2, C112.2, C113.2, C115.2, C116.2, C117.2, C118.2, C120.2, C121.2, C122.2, C123.2, C124.2, C125.2, C126.2, C128.1, C129.2, C130.1, C131.2, C132.1, C133.2, C134.1, C135.2, C136.1, C137.1, C138.2, C139.1, C140.2, C141.1, C142.2, C143.1, C144.2, C145.1, C146.2, C147.1, C148.1, C149.2, C150.1, C151.2, C152.1, C153.1, C154.2, C155.1, C156.2, C157.1, C158.2, C160.2, C161.2, C162.2, C164.2, C165.2, C166.1, C167.2, C168.1, C169.1, C170.1, C171.1, C173.1, C174.2, C175.1, C176.2, D1.2 (A2), D2.1 (K), D3.2 (A2), D4.2 (A2), D7.1 (K), D8.1 (K), D9.1 (K), D10.1 (K), D11.1 (K), D12.1 (K), D13.1 (K), D14.2 (A2), D15.2 (A2), D16.2 (A2), D17.2 (A2), D18.2 (A2), D19.2 (A2), D20.2 (A2), D21.2 (A2), D22.2 (A2), D23.2 (A2), D24.1 (K), J4.1, J9.1, J9.3, J9.5, J9.7, J9.9, J9.11, J9.13, J9.15, J9.17, J9.19, J9.21, J9.23, J9.25, J12.2, J12.4, J12.6, J12.8, J13.2, J13.4, J13.6, J13.8, J14.2, J14.4, J14.6, J14.8, J15.2, J15.4, J15.6, J15.8, J18.1, J18.3, J18.5, J18.7, J18.9, J18.11, J18.13, J18.15, J18.17, J18.19, J18.21, J18.23, J20.2, Q2.2 (S), Q6.2 (S), R4.1, R6.2, R27.2, R29.2, R39.1, R42.2, R44.2, R46.2, R54.3, R54.4, R54.5, R57.2, R60.2, R63.3, R63.4, R63.5, R70.2, R73.1, R74.1, R78.1, R81.2, R83.2, R87.1, R90.2, R92.2, R96.1, R99.2, R101.2, R105.1, R109.1, R110.2, R114.1, R118.1, R123.1, R132.1, R141.1, R150.1, R153.2, R154.2, R221.1, R241.1, R248.1, U1.3 (GND), U1.7 (GND), U1.12 (GND), U1.18 (GND), U1.25 (~CMOS/LVDS), U1.26 (GND), U1.32 (GND), U1.34 (CLKOUT-), U1.38 (GND), U1.46 (GND), U1.49 (GND), U1.53 (GND), U2.a2 (GND), U2.a4 (GND), U2.a24 (GND), U2.a25 (GND), U2.a34 (GND), U2.a35 (GND), U2.a44 (GND), U2.a54 (GND), U2.a67 (GND), U2.a68 (GND), U2.b2 (GND), U2.b4 (GND), U2.b7 (XADC_INN0), U2.b8 (DXN_0), U2.b10 (GND), U2.b20 (GND), U2.b21 (GND), U2.b30 (GND), U2.b31 (GND), U2.b40 (GND), U2.b41 (GND), U2.b50 (GND), U2.b60 (GND), U2.b61 (GND), U2.b70 (GND), U2.b71 (GND), U2.b80 (GND), U3.3 (FB2), U3.14 (PGND2), U3.17 (PGND1), U3.28 (FB1), U3.35 (AGND), U3.41 (Pad), U4.8 (PFM/SYNCIN), U4.17 (AGND), U4.23 (PGND), U4.24 (PGND), U4.25 (PGND), U4.26 (PGND), U4.30 (PGND), U5.4 (GND), U5.5 (DIR), U6.4 (GND), U6.5 (DIR), U7.4 (V-), U8.1 (GND), U8.6 (MODE), U9.2 (GND), U9.4 (GND), U10.20 (GND), U10.22 (GND), U11.3 (GND), U11.7 (GND), U11.12 (GND), U11.18 (GND), U11.25 (~CMOS/LVDS), U11.26 (GND), U11.32 (GND), U11.34 (CLKOUT-), U11.38 (GND), U11.46 (GND), U11.49 (GND), U11.53 (GND), U12.8 (V+), U13.8 (V+), U14.8 (V+), U15.8 (V+), U17.4 (V-), U18.4 (V-), U19.4 (V-), U20.4 (V-), U21.4 (V-), U22.4 (V-), U23.4 (V-), U24.4 (V-), U25.4 (V-), U26.1, U26.3, U26.5, U26.7, U26.9, U26.11, U26.13, U26.15, U26.17, U26.19, U26.21, U26.23, U27.11 (GND), U27.12 (GND), U27.13 (GND), U27.22 (~OE), U28.11 (GND), U28.12 (GND), U28.13 (GND), U28.22 (~OE), U29.11 (GND), U29.12 (GND), U29.13 (GND), U29.22 (~OE), U30.11 (GND), U30.12 (GND), U30.13 (GND), U30.22 (~OE), U31.8 (GND), U32.11 (GND), U32.12 (GND), U32.13 (GND), U32.22 (~OE), U33.11 (GND), U33.12 (GND), U33.13 (GND), U33.22 (~OE), U34.4 (GND), U34.5 (DIR), U35.4 (GND), U35.5 (DIR), U36.4 (GND), U37.8 (GND), U38.11 (GND), U38.12 (GND), U38.13 (GND), U38.22 (~OE), U39.4 (GND), U39.5 (DIR), U40.8 (GND), U41.4 (GND), U41.5 (DIR), U42.4 (GND), U43.8 (GND), U44.4 (V-), U45.1, U45.3, U45.5, U45.7, U45.9, U45.11, U45.13, U45.15, U45.17, U45.19, U45.21, U45.23, U46.1, U46.3, U46.5, U46.7, U46.9, U46.11, U46.13, U46.15, U46.17, U46.19, U46.21, U46.23, U47.1, U47.3, U47.5, U47.7, U47.9, U47.11, U47.13, U47.15, U47.17, U47.19, U47.21, U47.23, U48.2 (GND), U48.4 (GND)
unnamed: C8.2, R66.2, R135.2, R136.2, R137.1, U15.1
unnamed: C18.1, R2.1
unnamed: C54.1, R54.2, R58.1
unnamed: C57.1, R63.2, R65.1
unnamed: C61.2, R30.2, R158.2, R159.2, R161.1, U12.1
unnamed: C65.2, R32.2, R223.2, R224.2, R236.1, U13.1
unnamed: C163.2, R34.2, R254.2, R255.2, R257.1, U14.1
unnamed: C165.1, R117.2
unnamed: C167.1, R127.1
unnamed: C172.1, R128.1
unnamed: D2.2 (A), R146.2
unnamed: C20.1, C26.1, D5.2 (A), D6.2 (A), U3.15 (VCC), U3.16 (VCC)
unnamed: C21.1, D5.1 (K), U3.20 (HB1)
unnamed: C25.1, D6.1 (K), U3.11 (HB2)
unnamed: D7.2 (A), R7.2
unnamed: D8.2 (A), R8.2
unnamed: D9.2 (A), R47.2
unnamed: D10.2 (A), R48.2
unnamed: D11.2 (A), R49.2
unnamed: D12.2 (A), R50.2
unnamed: D13.2 (A), R51.2
unnamed: D24.2 (A), R108.2
unnamed: R10.2, R14.1
unnamed: R11.2, R15.1
unnamed: R12.2, R16.1
unnamed: R9.2, R13.1
unnamed: R17.2, R18.1
unnamed: R19.2, R20.1
unnamed: R21.2, R22.1
unnamed: R23.2, R24.1
unnamed: R37.2, R38.1, U7.7
unnamed: R52.2, R53.2, R54.1, R55.2
unnamed: R56.1, SW1.1, SW1.2
unnamed: R59.1, SW2.1, SW2.2
unnamed: R61.2, R62.2, R63.1, R64.2
unnamed: R76.2, R77.1, U17.7
unnamed: R85.2, R86.1, U18.7
unnamed: R94.2, R95.1, U19.7
unnamed: R103.2, R104.1, U20.7
unnamed: R112.2, R113.1, U21.7
unnamed: R121.2, R122.1, U22.7
unnamed: R130.2, R131.1, U23.7
unnamed: R139.2, R140.1, U24.7
unnamed: R67.2, R144.2, U15.7
unnamed: R148.2, R149.1, U25.7
unnamed: R31.2, R162.2, U12.7
unnamed: R33.2, R237.2, U13.7
unnamed: R246.2, R247.1, U44.7
unnamed: R35.2, R258.2, U14.7
unnamed: R6.1, U1.48 (Ain8+)
unnamed: R110.1, U1.47 (Ain8-)
unnamed: C12.1, U1.22 (REFOUT1)
unnamed: C13.1, U1.9 (REFOUT2)
unnamed: C14.1, U1.6 (REFOUT3)
unnamed: C15.1, U1.45 (REFOUT4)
unnamed: R28.1, R29.1, U1.23 (~SDR/DDR)
unnamed: R3.2, U3.22 (HO1)
unnamed: R5.2, U3.9 (HO2)
unnamed: C24.1, U3.32 (RES)
unnamed: R4.2, U3.37 (RT)
unnamed: C125.1, U3.30 (SS1)
unnamed: C23.1, U3.1 (SS2)
unnamed: R109.2, U4.13 (CONFIG)
unnamed: C166.2, R127.2, U4.15 (EXTCOMP)
unnamed: R72.2, R118.2, U4.9 (En/UVLO)
unnamed: L2.2, R68.1, U4.11 (ISNS+)
unnamed: R73.2, U4.7 (PG/SYNCOUT)
unnamed: R74.2, U4.14 (RT)
unnamed: R117.1, U4.19 (VCC)
unnamed: C74.1, R71.2, U4.18 (VDDA)
unnamed: R42.1, R43.2, R44.1, U7.3 (+)
unnamed: R36.2, R40.2, U7.1, U7.2 (-)
unnamed: C46.1, R39.2, R41.1, U7.5 (+)
unnamed: R38.2, R40.1, U7.6 (-)
unnamed: R45.2, R46.1, U8.4 (FB)
unnamed: L3.2, U8.2 (SW)
unnamed: C69.1, U11.22 (REFOUT1)
unnamed: C70.1, U11.9 (REFOUT2)
unnamed: C71.1, U11.6 (REFOUT3)
unnamed: C72.1, U11.45 (REFOUT4)
unnamed: R1.1, R27.1, U11.23 (~SDR/DDR)
unnamed: C10.1, R13.2, R156.1, R157.1, U12.3 (+)
unnamed: C61.1, R18.2, R158.1, R159.1, U12.2 (-)
unnamed: R160.2, U12.5 (+)
unnamed: R161.2, R162.1, U12.6 (-)
unnamed: C63.1, R14.2, R199.1, R222.1, U13.3 (+)
unnamed: C65.1, R20.2, R223.1, R224.1, U13.2 (-)
unnamed: R235.2, U13.5 (+)
unnamed: R236.2, R237.1, U13.6 (-)
unnamed: C127.1, R15.2, R252.1, R253.1, U14.3 (+)
unnamed: C163.1, R22.2, R254.1, R255.1, U14.2 (-)
unnamed: R256.2, U14.5 (+)
unnamed: R257.2, R258.1, U14.6 (-)
unnamed: C6.1, R16.2, R119.1, R126.1, U15.3 (+)
unnamed: C8.1, R24.2, R135.1, R136.1, U15.2 (-)
unnamed: R145.2, U15.5 (+)
unnamed: R137.2, R144.1, U15.6 (-)
unnamed: R81.1, R82.2, R83.1, U17.3 (+)
unnamed: R75.2, R79.2, U17.1, U17.2 (-)
unnamed: C81.1, R78.2, R80.1, U17.5 (+)
unnamed: R77.2, R79.1, U17.6 (-)
unnamed: R90.1, R91.2, R92.1, U18.3 (+)
unnamed: R84.2, R88.2, U18.1, U18.2 (-)
unnamed: C86.1, R87.2, R89.1, U18.5 (+)
unnamed: R86.2, R88.1, U18.6 (-)
unnamed: R99.1, R100.2, R101.1, U19.3 (+)
unnamed: R93.2, R97.2, U19.1, U19.2 (-)
unnamed: C91.1, R96.2, R98.1, U19.5 (+)
unnamed: R95.2, R97.1, U19.6 (-)
unnamed: R102.2, R106.2, U20.1, U20.2 (-)
unnamed: C96.1, R105.2, R107.1, U20.5 (+)
unnamed: R104.2, R106.1, U20.6 (-)
unnamed: R111.2, R115.2, U21.1, U21.2 (-)
unnamed: C101.1, R114.2, R116.1, U21.5 (+)
unnamed: R113.2, R115.1, U21.6 (-)
unnamed: R120.2, R124.2, U22.1, U22.2 (-)
unnamed: C106.1, R123.2, R125.1, U22.5 (+)
unnamed: R122.2, R124.1, U22.6 (-)
unnamed: R129.2, R133.2, U23.1, U23.2 (-)
unnamed: C111.1, R132.2, R134.1, U23.5 (+)
unnamed: R131.2, R133.1, U23.6 (-)
unnamed: R138.2, R142.2, U24.1, U24.2 (-)
unnamed: C116.1, R141.2, R143.1, U24.5 (+)
unnamed: R140.2, R142.1, U24.6 (-)
unnamed: R147.2, R151.2, U25.1, U25.2 (-)
unnamed: C121.1, R150.2, R152.1, U25.5 (+)
unnamed: R149.2, R151.1, U25.6 (-)
unnamed: R220.2, R221.2, U36.5 (DIR)
unnamed: R240.2, R241.2, U42.5 (DIR)
unnamed: R245.2, R249.2, U44.1, U44.2 (-)
unnamed: C161.1, R248.2, R250.1, U44.5 (+)
unnamed: R247.2, R249.1, U44.6 (-)
REFOUT_B6: C11.1, R107.2, R116.2, R125.2, R134.2, R143.2, R152.2, R250.2, U1.8 (REF)
REFOUT_M: C6.2, C10.2, C63.2, C68.1, C127.2, R41.2, R80.2, R89.2, R98.2, R119.2, R126.2, R145.1, R156.2, R157.2, R160.1, R199.2, R222.2, R235.1, R252.2, R253.2, R256.1, U11.8 (REF)
