der-kollege/My_kicad_hardware/FPGA_Board_BA/PCB_Leo_edit/FPGA_Board_feb 01/5va.kicad_sch

## KiCad design FPGA_Board_BA/PCB_Leo_edit/FPGA_Board_feb 01/5va.kicad_sch (2025-12-10)

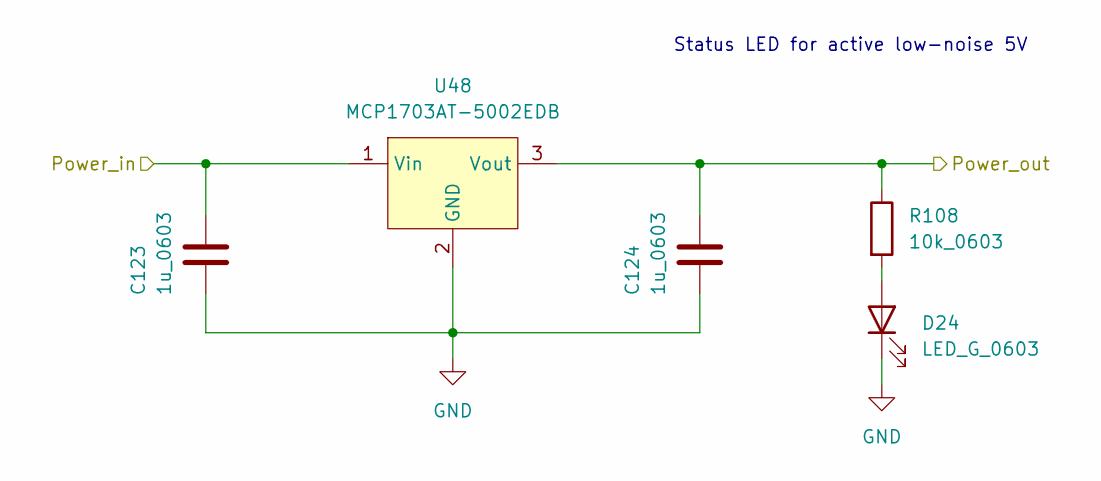
[picture p17: schematic 5va.kicad_sch]

Parts:
C123, C124: 1u_0603; C_0603; FARNELL 3013414
D24: LED_G_0603; LED_0603_1608Metric; Forward Voltage 2.65 V @ 2mA; FARNELL 2610409
R108: 10k_0603; R_0603_1608Metric; FARNELL 2447230
U48: MCP1703AT-5002EDB; SOT-223; Mouser nr 579-MCP1703AT5002EDB

Connections:
GND: C123.2, C124.2, D24.1 (K), U48.2 (GND), U48.4 (GND)
unnamed: D24.2 (A), R108.2
Power_in: C123.1, U48.1 (Vin)
Power_out: C124.1, R108.1, U48.3 (Vout)

Notes on the sheet:
Status LED for active low-noise 5V
