der-kollege/My_kicad_hardware/FPGA_Board_BA/PCB_Leo_edit/FPGA_Board_feb 01/adc.kicad_sch

## KiCad design FPGA_Board_BA/PCB_Leo_edit/FPGA_Board_feb 01/adc.kicad_sch (2026-02-26)

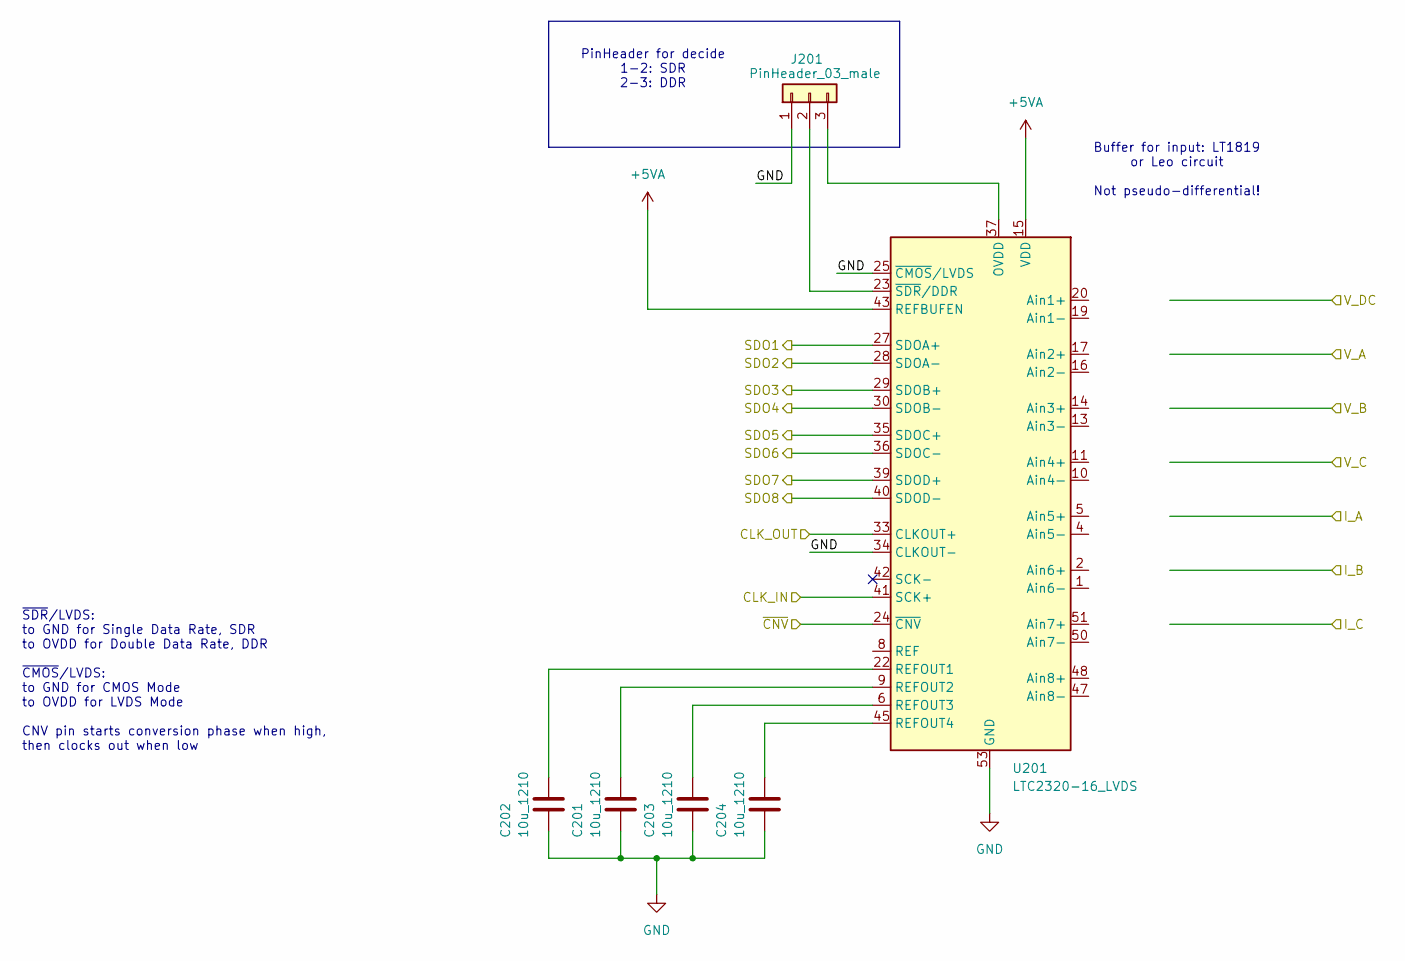
[picture p18: schematic adc.kicad_sch]

Parts:
C201, C202, C203, C204: 10u_1210; C_1210; FARNELL 1327737
J201: PinHeader_03_male; PinHeader_1x03_P2.54mm_Vertical; FARNELL 1022248
U201: LTC2320-16_LVDS; UKG_52_7mm_8mm

Connections:
+5VA: U201.15 (VDD), U201.21 (VDD), U201.43 (REFBUFEN), U201.44 (VDD), U201.52 (VDD)
CLK_IN: U201.41 (SCK+)
CLK_OUT: U201.33 (CLKOUT+)
GND: C201.2, C202.2, C203.2, C204.2, J201.1, U201.3 (GND), U201.7 (GND), U201.12 (GND), U201.18 (GND), U201.25 (~CMOS/LVDS), U201.26 (GND), U201.32 (GND), U201.34 (CLKOUT-), U201.38 (GND), U201.46 (GND), U201.49 (GND), U201.53 (GND)
unnamed: C201.1, U201.9 (REFOUT2)
unnamed: C202.1, U201.22 (REFOUT1)
unnamed: C203.1, U201.6 (REFOUT3)
unnamed: C204.1, U201.45 (REFOUT4)
unnamed: J201.2, U201.23 (~SDR/DDR)
unnamed: J201.3, U201.31 (OVDD), U201.37 (OVDD)
SDO1: U201.27 (SDOA+)
SDO2: U201.28 (SDOA-)
SDO3: U201.29 (SDOB+)
SDO4: U201.30 (SDOB-)
SDO5: U201.35 (SDOC+)
SDO6: U201.36 (SDOC-)
SDO7: U201.39 (SDOD+)
SDO8: U201.40 (SDOD-)
~CNV: U201.24 (~CNV)

Notes on the sheet:
Buffer for input: LT1819 or Leo circuit Not pseudo-differential!
PinHeader for decide 1-2: SDR 2-3: DDR
~{SDR}/LVDS: to GND for Single Data Rate, SDR to OVDD for Double Data Rate, DDR ~{CMOS}/LVDS: to GND for CMOS Mode to OVDD for LVDS Mode CNV pin starts conversion phase when high, then clocks out when low
