der-kollege/My_kicad_hardware/FPGA_Board_BA/PCB_Leo_edit/FPGA_Board_feb 01/adc_for_b6.kicad_sch

## KiCad design FPGA_Board_BA/PCB_Leo_edit/FPGA_Board_feb 01/adc_for_b6.kicad_sch (2026-01-24)

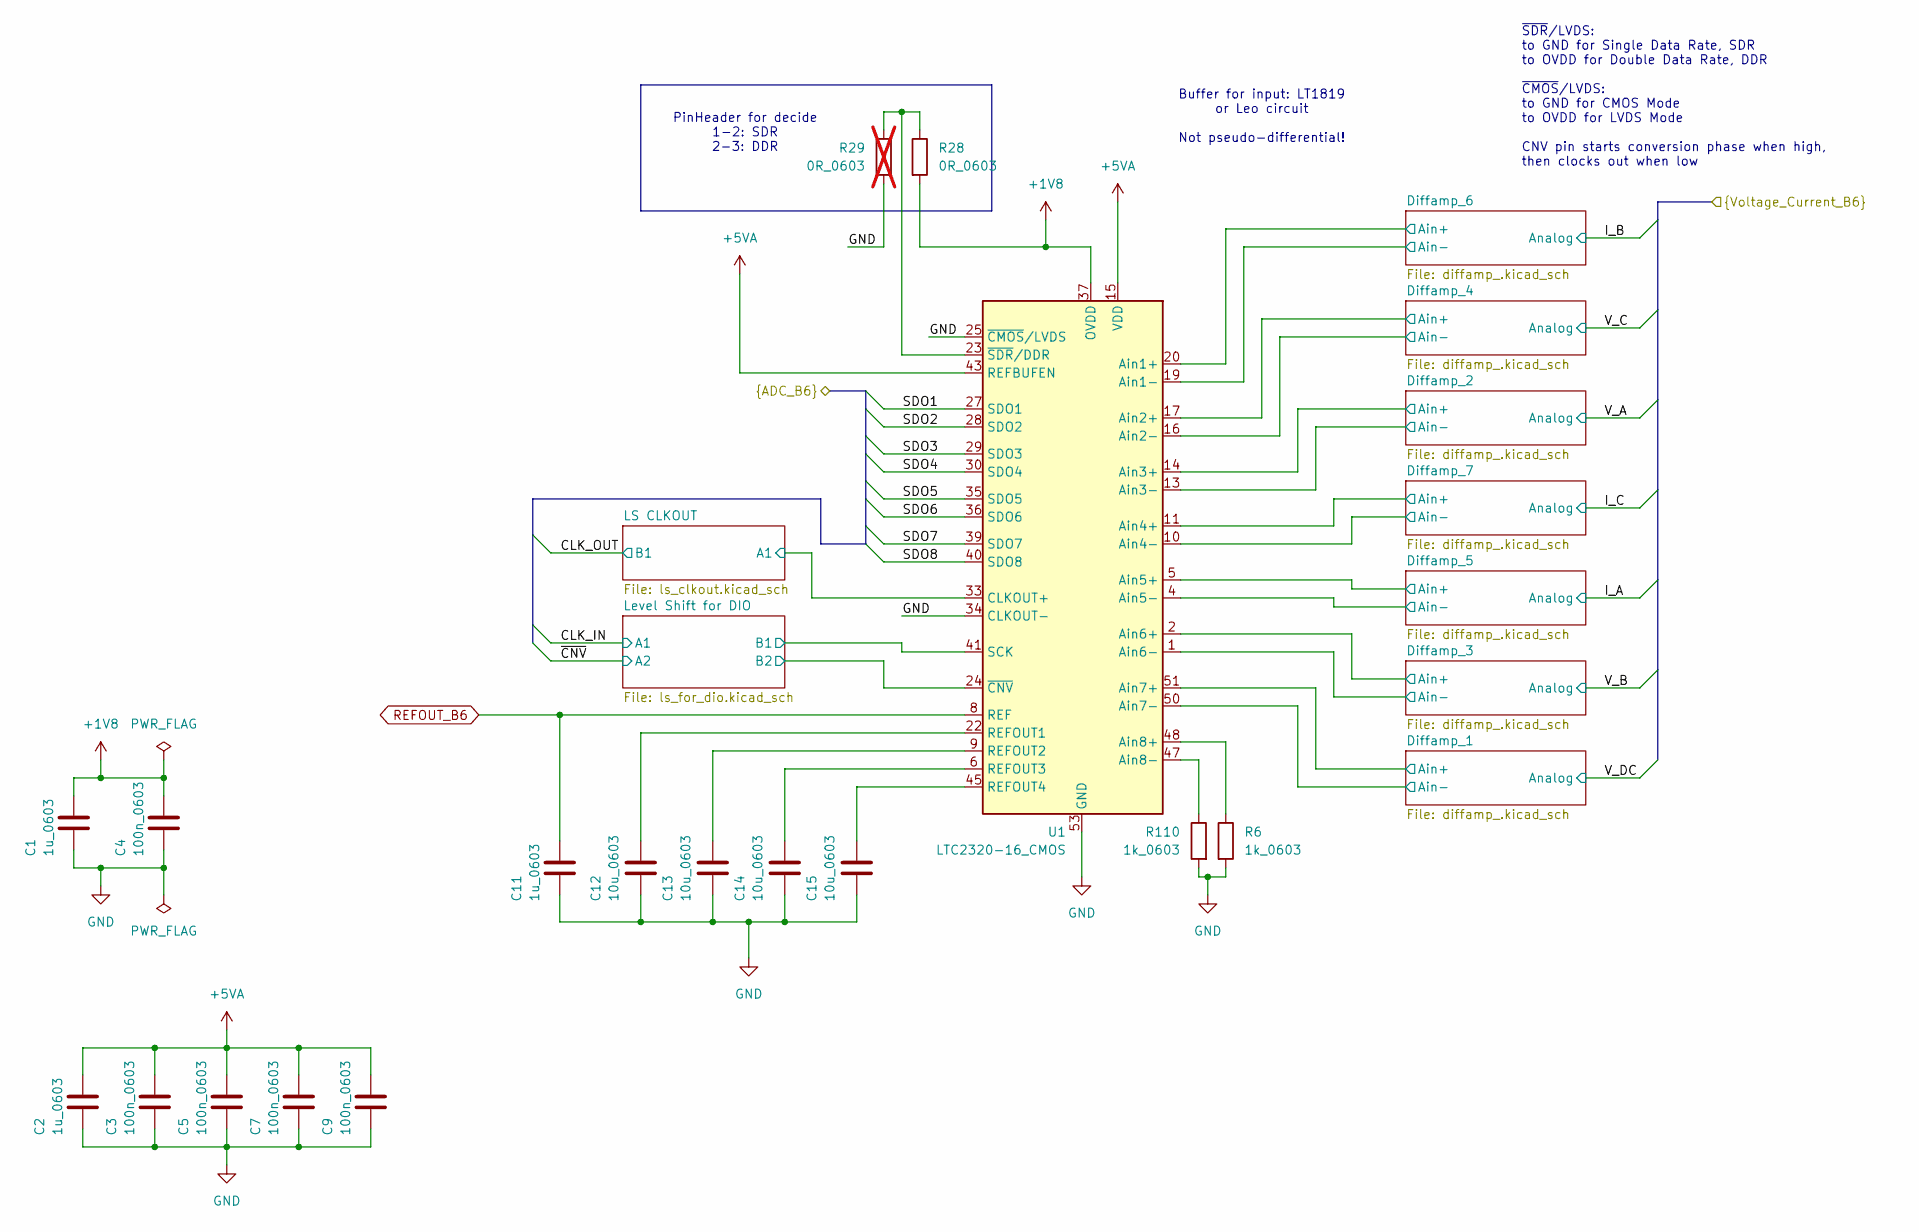
[picture p19: schematic adc_for_b6.kicad_sch]

Parts:
C1, C2, C11: 1u_0603; C_0603; FARNELL 3013414
C3, C4, C5, C7, C9: 100n_0603; C_0603; FARNELL 1759037
C12, C13, C14, C15: 10u_0603; C_0603_1608Metric
R6, R110: 1k_0603; R_0603_1608Metric; FARNELL 2078907
R28: 0R_0603; R_0603_1608Metric; FARNELL 2309111
R29: 0R_0603; R_0603_1608Metric; FARNELL 2309111; not fitted
U1: LTC2320-16_CMOS; UKG_52_7mm_8mm

Connections:
+1V8: C1.1, C4.1, R28.2, U1.31 (OVDD), U1.37 (OVDD)
+5VA: C2.1, C3.1, C5.1, C7.1, C9.1, U1.15 (VDD), U1.21 (VDD), U1.43 (REFBUFEN), U1.44 (VDD), U1.52 (VDD)
A1: U1.33 (CLKOUT+)
Ain+: U1.2 (Ain6+), U1.5 (Ain5+), U1.11 (Ain4+), U1.14 (Ain3+), U1.17 (Ain2+), U1.20 (Ain1+), U1.51 (Ain7+)
Ain-: U1.1 (Ain6-), U1.4 (Ain5-), U1.10 (Ain4-), U1.13 (Ain3-), U1.16 (Ain2-), U1.19 (Ain1-), U1.50 (Ain7-)
B1: U1.41 (SCK)
B2: U1.24 (~CNV)
GND: C1.2, C2.2, C3.2, C4.2, C5.2, C7.2, C9.2, C11.2, C12.1, C13.1, C14.1, C15.1, R6.2, R29.2, R110.2, U1.3 (GND), U1.7 (GND), U1.12 (GND), U1.18 (GND), U1.25 (~CMOS/LVDS), U1.26 (GND), U1.32 (GND), U1.34 (CLKOUT-), U1.38 (GND), U1.46 (GND), U1.49 (GND), U1.53 (GND)
unnamed: C12.2, U1.22 (REFOUT1)
unnamed: C13.2, U1.9 (REFOUT2)
unnamed: C14.2, U1.6 (REFOUT3)
unnamed: C15.2, U1.45 (REFOUT4)
unnamed: R6.1, U1.48 (Ain8+)
unnamed: R28.1, R29.1, U1.23 (~SDR/DDR)
unnamed: R110.1, U1.47 (Ain8-)
REFOUT_B6: C11.1, U1.8 (REF)
SDO1: U1.27 (SDO1)
SDO2: U1.28 (SDO2)
SDO3: U1.29 (SDO3)
SDO4: U1.30 (SDO4)
SDO5: U1.35 (SDO5)
SDO6: U1.36 (SDO6)
SDO7: U1.39 (SDO7)
SDO8: U1.40 (SDO8)

Notes on the sheet:
Buffer for input: LT1819 or Leo circuit Not pseudo-differential!
PinHeader for decide 1-2: SDR 2-3: DDR
~{SDR}/LVDS: to GND for Single Data Rate, SDR to OVDD for Double Data Rate, DDR ~{CMOS}/LVDS: to GND for CMOS Mode to OVDD for LVDS Mode CNV pin starts conversion phase when high, then clocks out when low
