der-kollege/My_kicad_hardware/FPGA_Board_BA/PCB_Leo_edit/FPGA_Board_feb 01/adc_machine.kicad_sch

## KiCad design FPGA_Board_BA/PCB_Leo_edit/FPGA_Board_feb 01/adc_machine.kicad_sch (2026-01-25)

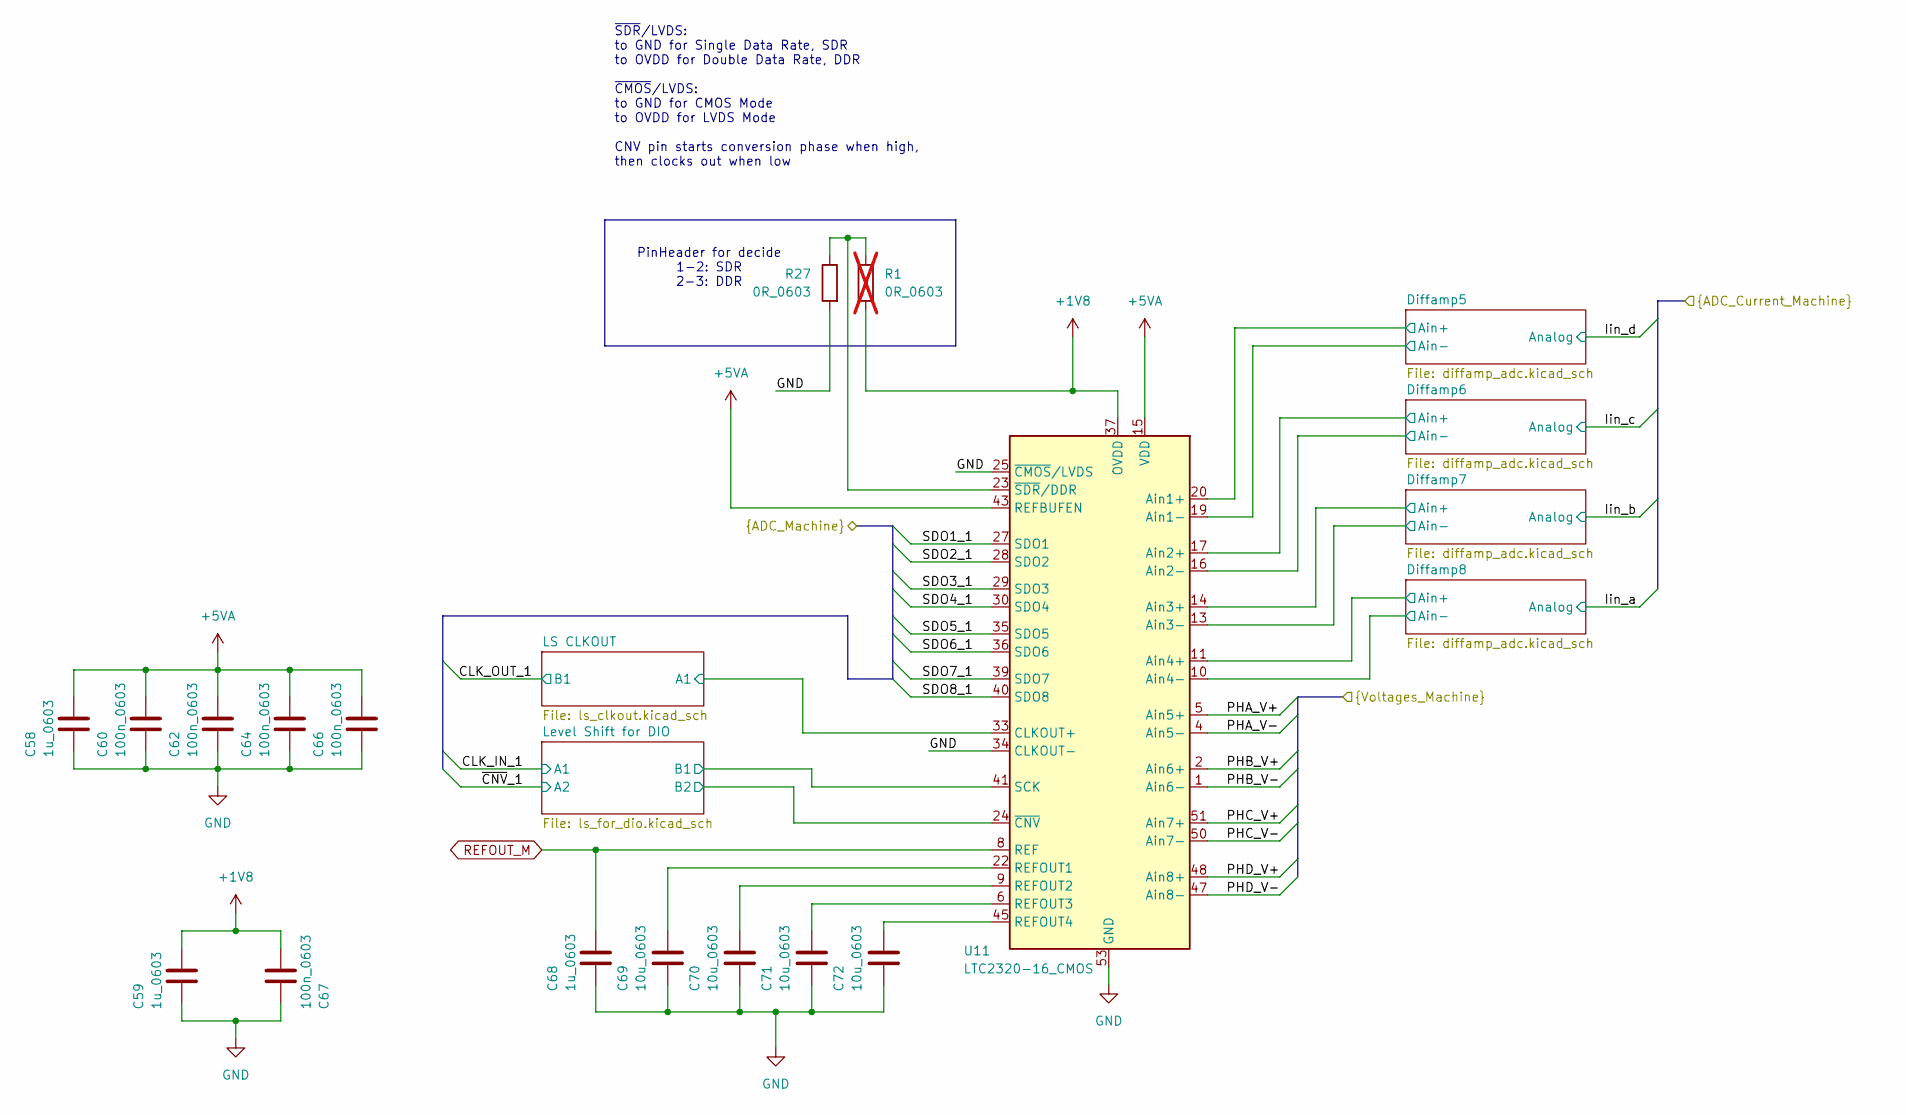
[picture p20: schematic adc_machine.kicad_sch]

Parts:
C58, C59, C68: 1u_0603; C_0603; FARNELL 3013414
C60, C62, C64, C66, C67: 100n_0603; C_0603; FARNELL 1759037
C69, C70, C71, C72: 10u_0603; C_0603_1608Metric
R1: 0R_0603; R_0603_1608Metric; FARNELL 2309111; not fitted
R27: 0R_0603; R_0603_1608Metric; FARNELL 2309111
U11: LTC2320-16_CMOS; UKG_52_7mm_8mm

Connections:
+1V8: C59.1, C67.1, R1.2, U11.31 (OVDD), U11.37 (OVDD)
+5VA: C58.1, C60.1, C62.1, C64.1, C66.1, U11.15 (VDD), U11.21 (VDD), U11.43 (REFBUFEN), U11.44 (VDD), U11.52 (VDD)
A1: U11.33 (CLKOUT+)
Ain+: U11.11 (Ain4+), U11.14 (Ain3+), U11.17 (Ain2+), U11.20 (Ain1+)
Ain-: U11.10 (Ain4-), U11.13 (Ain3-), U11.16 (Ain2-), U11.19 (Ain1-)
B1: U11.41 (SCK)
B2: U11.24 (~CNV)
GND: C58.2, C59.2, C60.2, C62.2, C64.2, C66.2, C67.2, C68.2, C69.1, C70.1, C71.1, C72.1, R27.2, U11.3 (GND), U11.7 (GND), U11.12 (GND), U11.18 (GND), U11.25 (~CMOS/LVDS), U11.26 (GND), U11.32 (GND), U11.34 (CLKOUT-), U11.38 (GND), U11.46 (GND), U11.49 (GND), U11.53 (GND)
unnamed: C69.2, U11.22 (REFOUT1)
unnamed: C70.2, U11.9 (REFOUT2)
unnamed: C71.2, U11.6 (REFOUT3)
unnamed: C72.2, U11.45 (REFOUT4)
unnamed: R1.1, R27.1, U11.23 (~SDR/DDR)
PHA_V+: U11.5 (Ain5+)
PHA_V-: U11.4 (Ain5-)
PHB_V+: U11.2 (Ain6+)
PHB_V-: U11.1 (Ain6-)
PHC_V+: U11.51 (Ain7+)
PHC_V-: U11.50 (Ain7-)
PHD_V+: U11.48 (Ain8+)
PHD_V-: U11.47 (Ain8-)
REFOUT_M: C68.1, U11.8 (REF)
SDO1_1: U11.27 (SDO1)
SDO2_1: U11.28 (SDO2)
SDO3_1: U11.29 (SDO3)
SDO4_1: U11.30 (SDO4)
SDO5_1: U11.35 (SDO5)
SDO6_1: U11.36 (SDO6)
SDO7_1: U11.39 (SDO7)
SDO8_1: U11.40 (SDO8)

Notes on the sheet:
~{SDR}/LVDS: to GND for Single Data Rate, SDR to OVDD for Double Data Rate, DDR ~{CMOS}/LVDS: to GND for CMOS Mode to OVDD for LVDS Mode CNV pin starts conversion phase when high, then clocks out when low
PinHeader for decide 1-2: SDR 2-3: DDR
