der-kollege/My_kicad_hardware/FPGA_Board_BA/PCB_Leo_edit/FPGA_Board_feb 01/adc_power.kicad_sch

## KiCad design FPGA_Board_BA/PCB_Leo_edit/FPGA_Board_feb 01/adc_power.kicad_sch (2025-11-18)

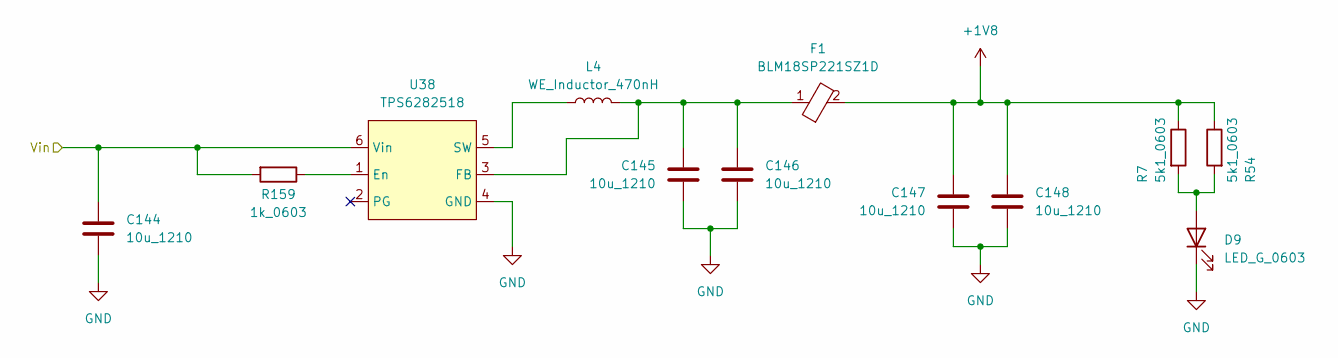
[picture p21: schematic adc_power.kicad_sch]

Parts:
C144, C145, C146, C147, C148: 10u_1210; C_1210; FARNELL 1327737
D9: LED_G_0603; LED_0603_1608Metric; Forward Voltage 2.65 V @ 2mA; FARNELL 2610409
F1: BLM18SP221SZ1D
L4: WE_Inductor_470nH; WE_74479275147; Mouser Nr 710-74479275147
R7, R54: 5k1_0603; R_0603_1608Metric; FARNELL 2447404
R159: 1k_0603; R_0603_1608Metric; FARNELL 2078907
U38: TPS6282518; TPS6282518DMQR; Mouser nr 595-TPS6282518DMQR

Connections:
+1V8: C147.1, C148.1, F1.2, R7.1, R54.1
GND: C144.2, C145.2, C146.2, C147.2, C148.2, D9.1 (K), U38.4 (GND)
unnamed: C145.1, C146.1, F1.1, L4.2, U38.3 (FB)
unnamed: D9.2 (A), R7.2, R54.2
unnamed: L4.1, U38.5 (SW)
unnamed: R159.1, U38.1 (En)
Vin: C144.1, R159.2, U38.6 (Vin)
