der-kollege/My_kicad_hardware/FPGA_Board_BA/PCB_Leo_edit/FPGA_Board_feb 01/analog_voltage.kicad_sch

## KiCad design FPGA_Board_BA/PCB_Leo_edit/FPGA_Board_feb 01/analog_voltage.kicad_sch (2025-12-28)

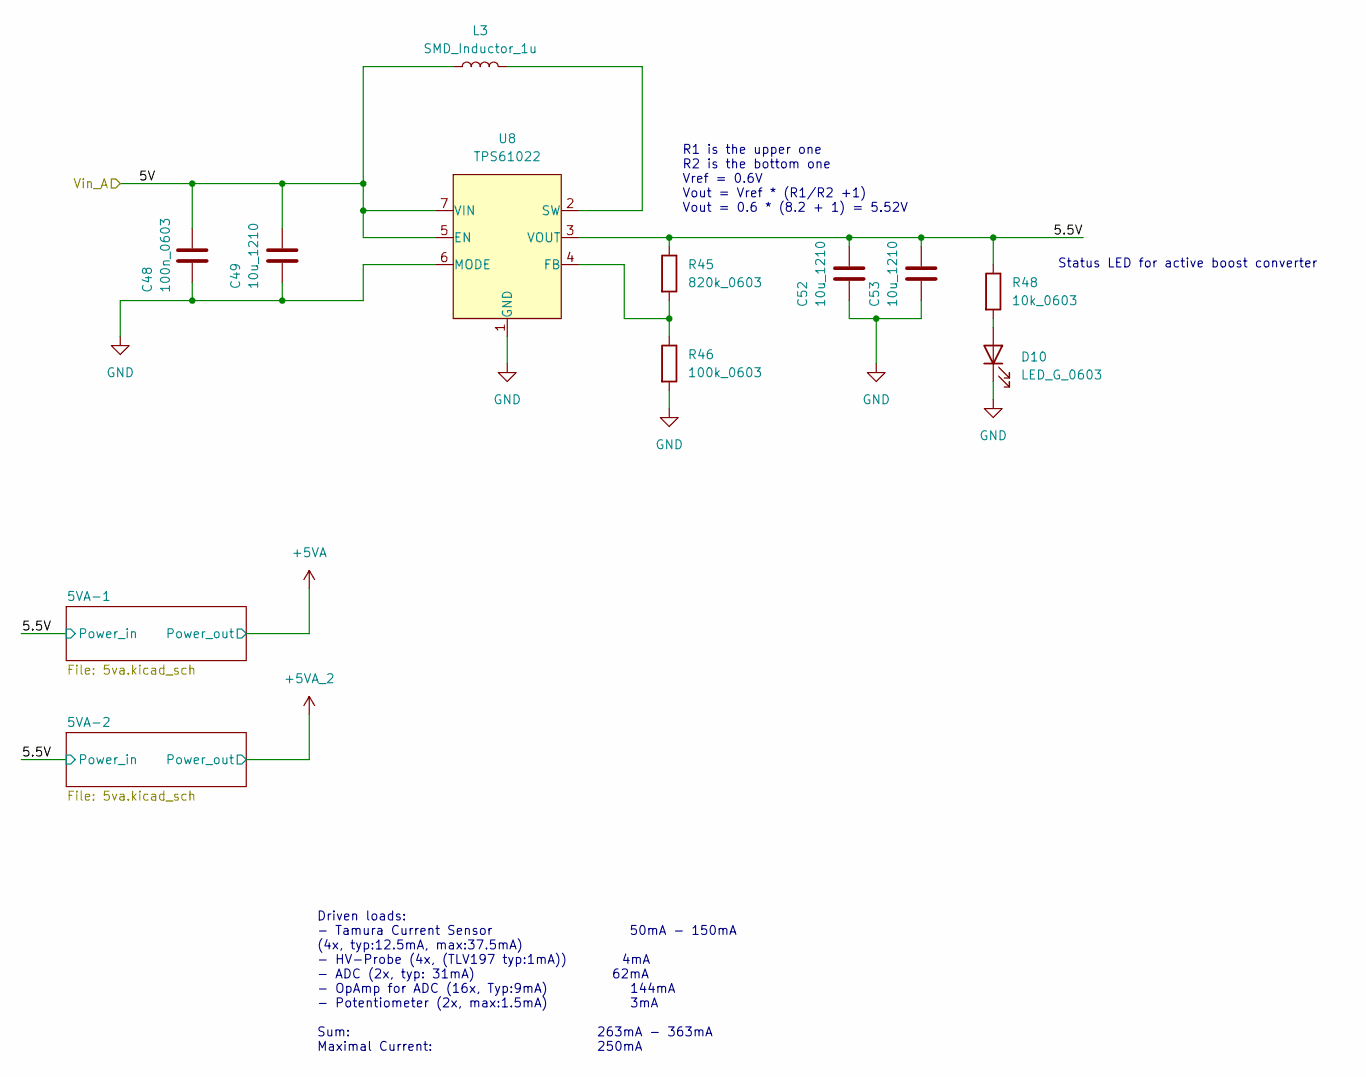
[picture p22: schematic analog_voltage.kicad_sch]

Parts:
C48: 100n_0603; C_0603; FARNELL 1759037
C49, C52, C53: 10u_1210; C_1210; FARNELL 1327737
D10: LED_G_0603; LED_0603_1608Metric; Forward Voltage 2.65 V @ 2mA; FARNELL 2610409
L3: SMD_Inductor_1u; 74404043010A; Mouser nr. 710-74404043010A
R45: 820k_0603; R_0603_1608Metric_Pad0.98x0.95mm_HandSolder
R46: 100k_0603; R_0603_1608Metric; Power Rating 100mW; FARNELL 2078921
R48: 10k_0603; R_0603_1608Metric; FARNELL 2447230
U8: TPS61022

Connections:
5.5V: C52.1, C53.1, R45.1, R48.1, U8.3 (VOUT)
5V: C48.1, C49.1, L3.1, U8.5 (EN), U8.7 (VIN)
GND: C48.2, C49.2, C52.2, C53.2, D10.1 (K), R46.2, U8.1 (GND), U8.6 (MODE)
unnamed: D10.2 (A), R48.2
unnamed: L3.2, U8.2 (SW)
unnamed: R45.2, R46.1, U8.4 (FB)

Notes on the sheet:
Status LED for active boost converter
R1 is the upper one R2 is the bottom one Vref = 0.6V Vout = Vref * (R1/R2 +1) Vout = 0.6 * (8.2 + 1) = 5.52V
Driven loads: - Tamura Current Sensor 50mA - 150mA (4x, typ:12.5mA, max:37.5mA) - HV-Probe (4x, (TLV197 typ:1mA)) 4mA - ADC (2x, typ: 31mA) 62mA - OpAmp for ADC (16x, Typ:9mA) 144mA - Potentiometer (2x, max:1.5mA) 3mA Sum: 263mA - 363mA Maximal Current: 250mA
