der-kollege/My_kicad_hardware/FPGA_Board_BA/PCB_Leo_edit/FPGA_Board_feb 01/b6_ain1.kicad_sch

## KiCad design FPGA_Board_BA/PCB_Leo_edit/FPGA_Board_feb 01/b6_ain1.kicad_sch (2025-11-17)

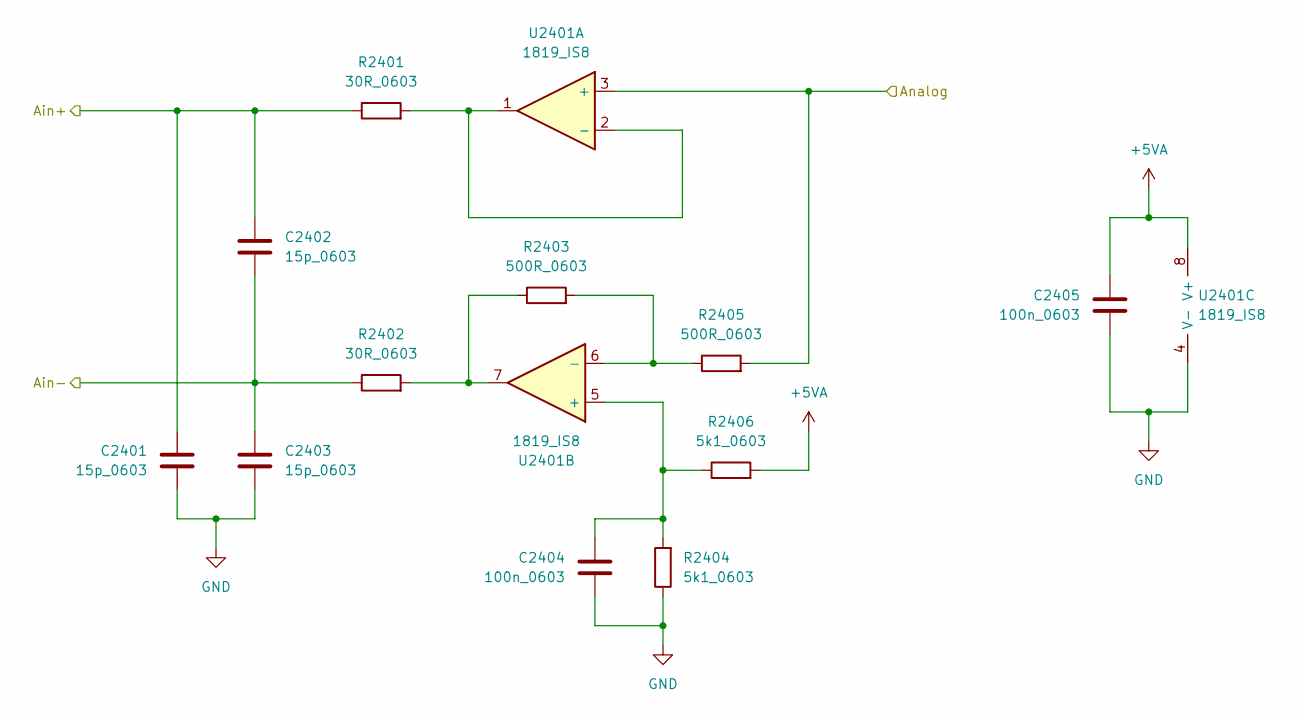
[picture p23: schematic b6_ain1.kicad_sch]

Parts:
C2401, C2402, C2403: 15p_0603; C_0603; FARNELL 1759124
C2404, C2405: 100n_0603; C_0603; FARNELL 1759037
R2401, R2402: 30R_0603; R_0603_1608Metric; Power Rating 50mW; FARNELL 1711574
R2403, R2405: 500R_0603; R_0603_1608Metric; FARNELL 2059312
R2404, R2406: 5k1_0603; R_0603_1608Metric; FARNELL 2447404
U2401: 1819_IS8; LT1819

Connections:
+5VA: C2405.1, R2406.2, U2401.8 (V+)
Ain+: C2401.1, C2402.1, R2401.1
Ain-: C2402.2, C2403.1, R2402.1
Analog: R2405.2, U2401.3 (+)
GND: C2401.2, C2403.2, C2404.2, C2405.2, R2404.1, U2401.4 (V-)
unnamed: C2404.1, R2404.2, R2406.1, U2401.5 (+)
unnamed: R2401.2, U2401.1, U2401.2 (-)
unnamed: R2402.2, R2403.1, U2401.7
unnamed: R2403.2, R2405.1, U2401.6 (-)
