der-kollege/My_kicad_hardware/FPGA_Board_BA/PCB_Leo_edit/FPGA_Board_feb 01/chb_com.kicad_sch

## KiCad design FPGA_Board_BA/PCB_Leo_edit/FPGA_Board_feb 01/chb_com.kicad_sch (2026-01-25)

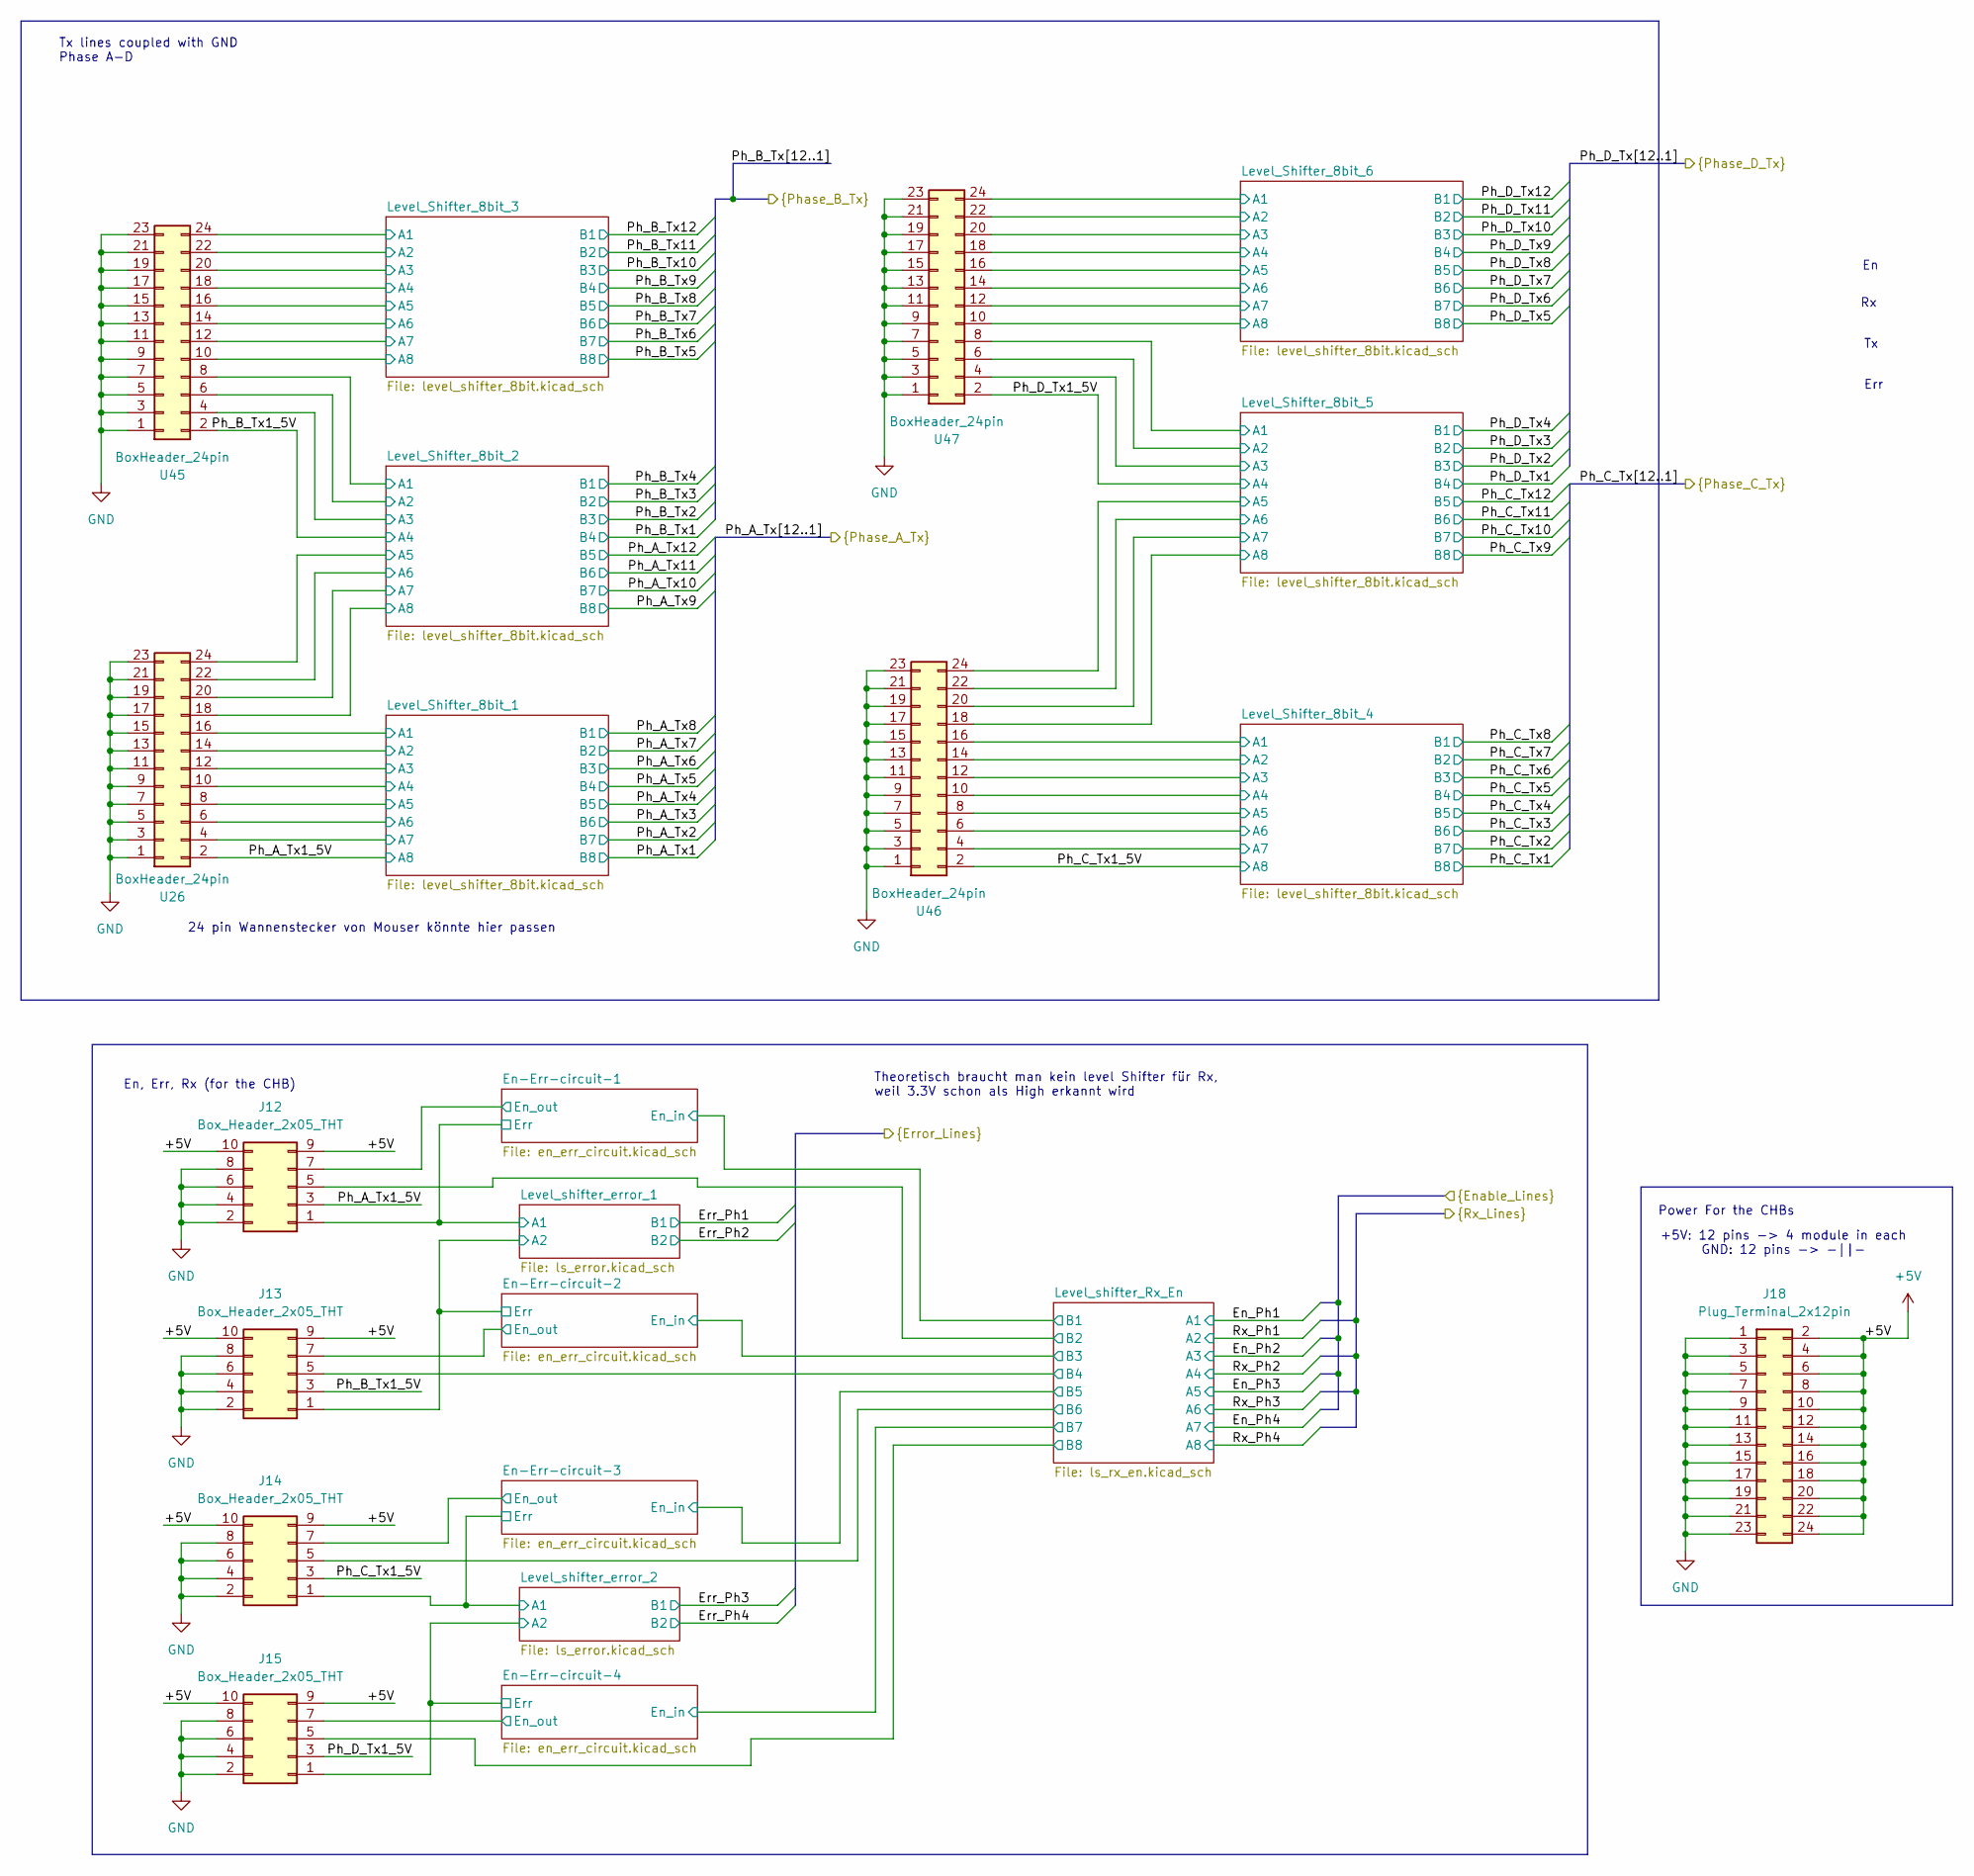
[picture p24: schematic chb_com.kicad_sch]

Parts:
J12, J13, J14, J15: Box_Header_2x05_THT; IDC-Header_2x05_P2.54mm_Vertical
J18: Plug_Terminal_2x12pin; DMCV 1,5_12-G1F-3,5-LR P20THR
U26, U45, U46, U47: BoxHeader_24pin; IDC-Header_2x12_P2.54mm_Vertical_SMD; Mouser nr 710-61202421621

Connections:
+5V: J12.9, J12.10, J13.9, J13.10, J14.9, J14.10, J15.9, J15.10, J18.2, J18.4, J18.6, J18.8, J18.10, J18.12, J18.14, J18.16, J18.18, J18.20, J18.22, J18.24
A1: J12.1, J14.1, U26.16, U45.8, U45.24, U46.16, U47.8, U47.24
A2: J13.1, J15.1, U26.14, U45.6, U45.22, U46.14, U47.6, U47.22
A3: U26.12, U45.4, U45.20, U46.12, U47.4, U47.20
A4: U26.10, U45.18, U46.10, U47.18
A5: U26.8, U26.24, U45.16, U46.8, U46.24, U47.16
A6: U26.6, U26.22, U45.14, U46.6, U46.22, U47.14
A7: U26.4, U26.20, U45.12, U46.4, U46.20, U47.12
A8: U26.18, U45.10, U46.18, U47.10
B2: J12.5
B4: J13.5
B6: J14.5
B8: J15.5
En_out: J12.7, J13.7, J14.7, J15.7
GND: J12.2, J12.4, J12.6, J12.8, J13.2, J13.4, J13.6, J13.8, J14.2, J14.4, J14.6, J14.8, J15.2, J15.4, J15.6, J15.8, J18.1, J18.3, J18.5, J18.7, J18.9, J18.11, J18.13, J18.15, J18.17, J18.19, J18.21, J18.23, U26.1, U26.3, U26.5, U26.7, U26.9, U26.11, U26.13, U26.15, U26.17, U26.19, U26.21, U26.23, U45.1, U45.3, U45.5, U45.7, U45.9, U45.11, U45.13, U45.15, U45.17, U45.19, U45.21, U45.23, U46.1, U46.3, U46.5, U46.7, U46.9, U46.11, U46.13, U46.15, U46.17, U46.19, U46.21, U46.23, U47.1, U47.3, U47.5, U47.7, U47.9, U47.11, U47.13, U47.15, U47.17, U47.19, U47.21, U47.23
Ph_A_Tx1_5V: J12.3, U26.2
Ph_B_Tx1_5V: J13.3, U45.2
Ph_C_Tx1_5V: J14.3, U46.2
Ph_D_Tx1_5V: J15.3, U47.2

Notes on the sheet:
Err
24 pin Wannenstecker von Mouser könnte hier passen
Power For the CHBs
En, Err, Rx (for the CHB)
Tx lines coupled with GND Phase A-D
Theoretisch braucht man kein level Shifter für Rx, weil 3.3V schon als High erkannt wird
+5V: 12 pins -> 4 module in each GND: 12 pins -> -||-
