der-kollege/My_kicad_hardware/FPGA_Board_BA/PCB_Leo_edit/FPGA_Board_feb 01/chb_phase_a.kicad_sch

## KiCad design FPGA_Board_BA/PCB_Leo_edit/FPGA_Board_feb 01/chb_phase_a.kicad_sch (2025-11-10)

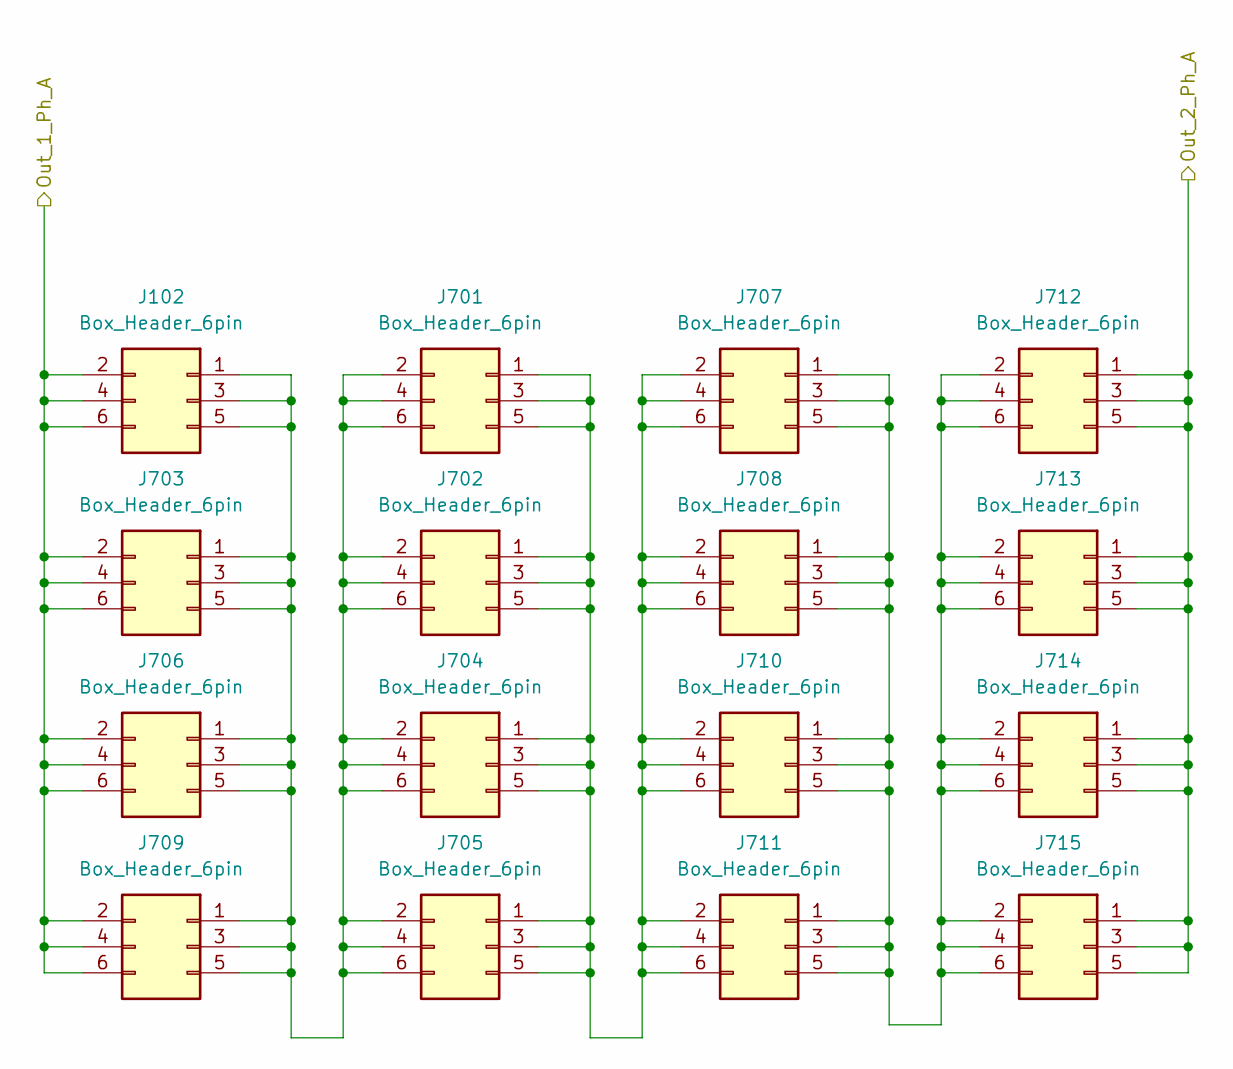
[picture p25: schematic chb_phase_a.kicad_sch]

Parts:
J102, J701, J702, J703, J704, J705, J706, J707, J708, J709, J710, J711, J712, J713, J714, J715: Box_Header_6pin; IDC-Header_2x03_P2.54mm_Vertical

Connections:
unnamed: J102.1, J102.3, J102.5, J701.2, J701.4, J701.6, J702.2, J702.4, J702.6, J703.1, J703.3, J703.5, J704.2, J704.4, J704.6, J705.2, J705.4, J705.6, J706.1, J706.3, J706.5, J709.1, J709.3, J709.5
unnamed: J701.1, J701.3, J701.5, J702.1, J702.3, J702.5, J704.1, J704.3, J704.5, J705.1, J705.3, J705.5, J707.2, J707.4, J707.6, J708.2, J708.4, J708.6, J710.2, J710.4, J710.6, J711.2, J711.4, J711.6
unnamed: J707.1, J707.3, J707.5, J708.1, J708.3, J708.5, J710.1, J710.3, J710.5, J711.1, J711.3, J711.5, J712.2, J712.4, J712.6, J713.2, J713.4, J713.6, J714.2, J714.4, J714.6, J715.2, J715.4, J715.6
Out_1_Ph_A: J102.2, J102.4, J102.6, J703.2, J703.4, J703.6, J706.2, J706.4, J706.6, J709.2, J709.4, J709.6
Out_2_Ph_A: J712.1, J712.3, J712.5, J713.1, J713.3, J713.5, J714.1, J714.3, J714.5, J715.1, J715.3, J715.5
