der-kollege/My_kicad_hardware/FPGA_Board_BA/PCB_Leo_edit/FPGA_Board_feb 01/chb_phase_b.kicad_sch

## KiCad design FPGA_Board_BA/PCB_Leo_edit/FPGA_Board_feb 01/chb_phase_b.kicad_sch (2025-11-10)

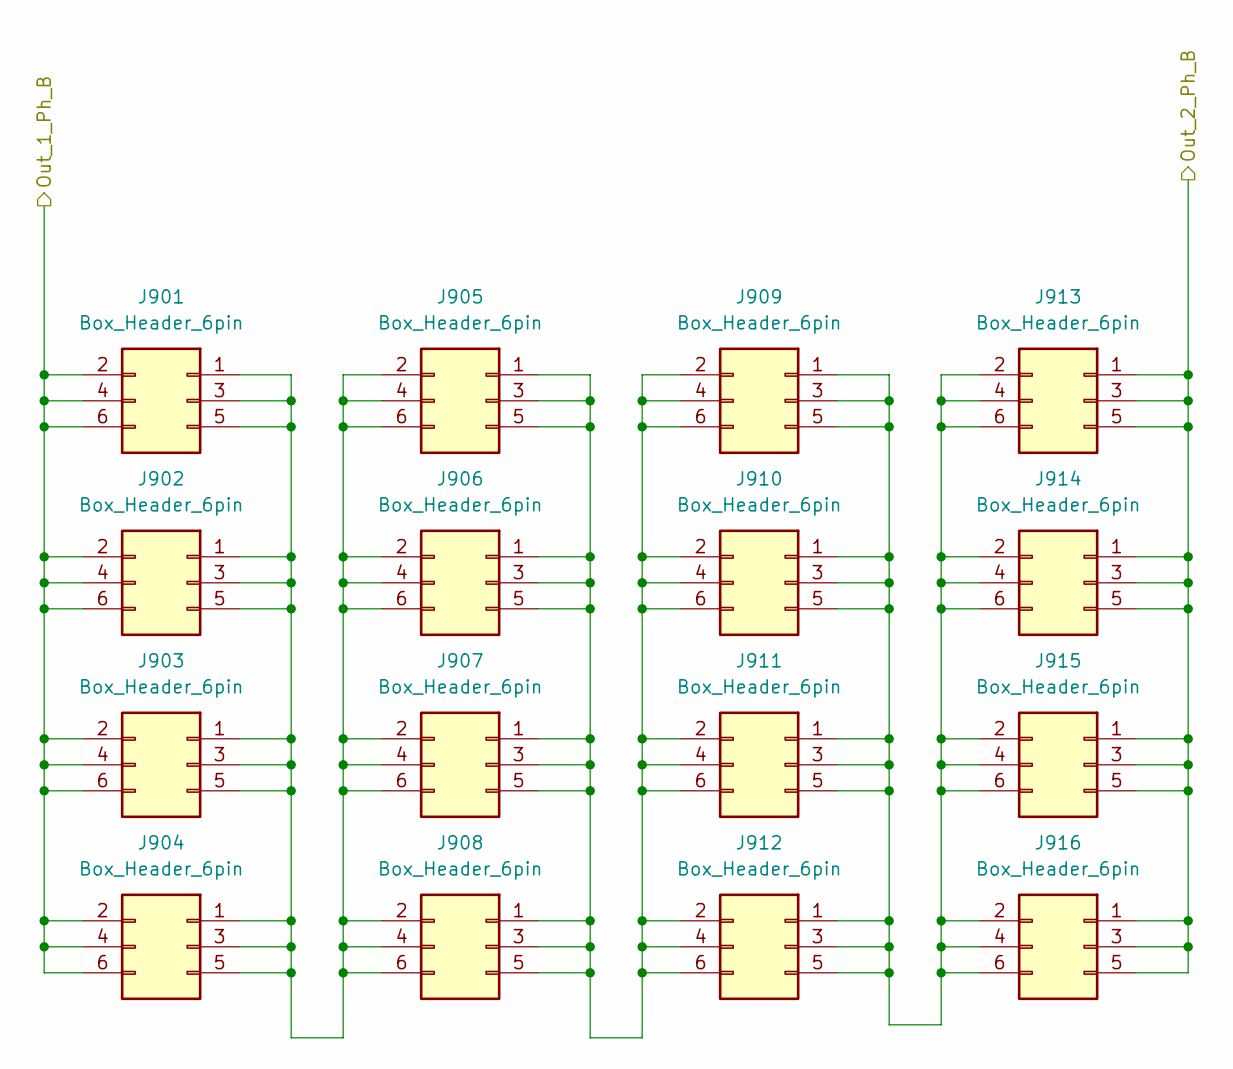
[picture p26: schematic chb_phase_b.kicad_sch]

Parts:
J901, J902, J903, J904, J905, J906, J907, J908, J909, J910, J911, J912, J913, J914, J915, J916: Box_Header_6pin; IDC-Header_2x03_P2.54mm_Vertical

Connections:
unnamed: J901.1, J901.3, J901.5, J902.1, J902.3, J902.5, J903.1, J903.3, J903.5, J904.1, J904.3, J904.5, J905.2, J905.4, J905.6, J906.2, J906.4, J906.6, J907.2, J907.4, J907.6, J908.2, J908.4, J908.6
unnamed: J905.1, J905.3, J905.5, J906.1, J906.3, J906.5, J907.1, J907.3, J907.5, J908.1, J908.3, J908.5, J909.2, J909.4, J909.6, J910.2, J910.4, J910.6, J911.2, J911.4, J911.6, J912.2, J912.4, J912.6
unnamed: J909.1, J909.3, J909.5, J910.1, J910.3, J910.5, J911.1, J911.3, J911.5, J912.1, J912.3, J912.5, J913.2, J913.4, J913.6, J914.2, J914.4, J914.6, J915.2, J915.4, J915.6, J916.2, J916.4, J916.6
Out_1_Ph_B: J901.2, J901.4, J901.6, J902.2, J902.4, J902.6, J903.2, J903.4, J903.6, J904.2, J904.4, J904.6
Out_2_Ph_B: J913.1, J913.3, J913.5, J914.1, J914.3, J914.5, J915.1, J915.3, J915.5, J916.1, J916.3, J916.5
