der-kollege/My_kicad_hardware/FPGA_Board_BA/PCB_Leo_edit/FPGA_Board_feb 01/chb_phase_c.kicad_sch

## KiCad design FPGA_Board_BA/PCB_Leo_edit/FPGA_Board_feb 01/chb_phase_c.kicad_sch (2025-11-10)

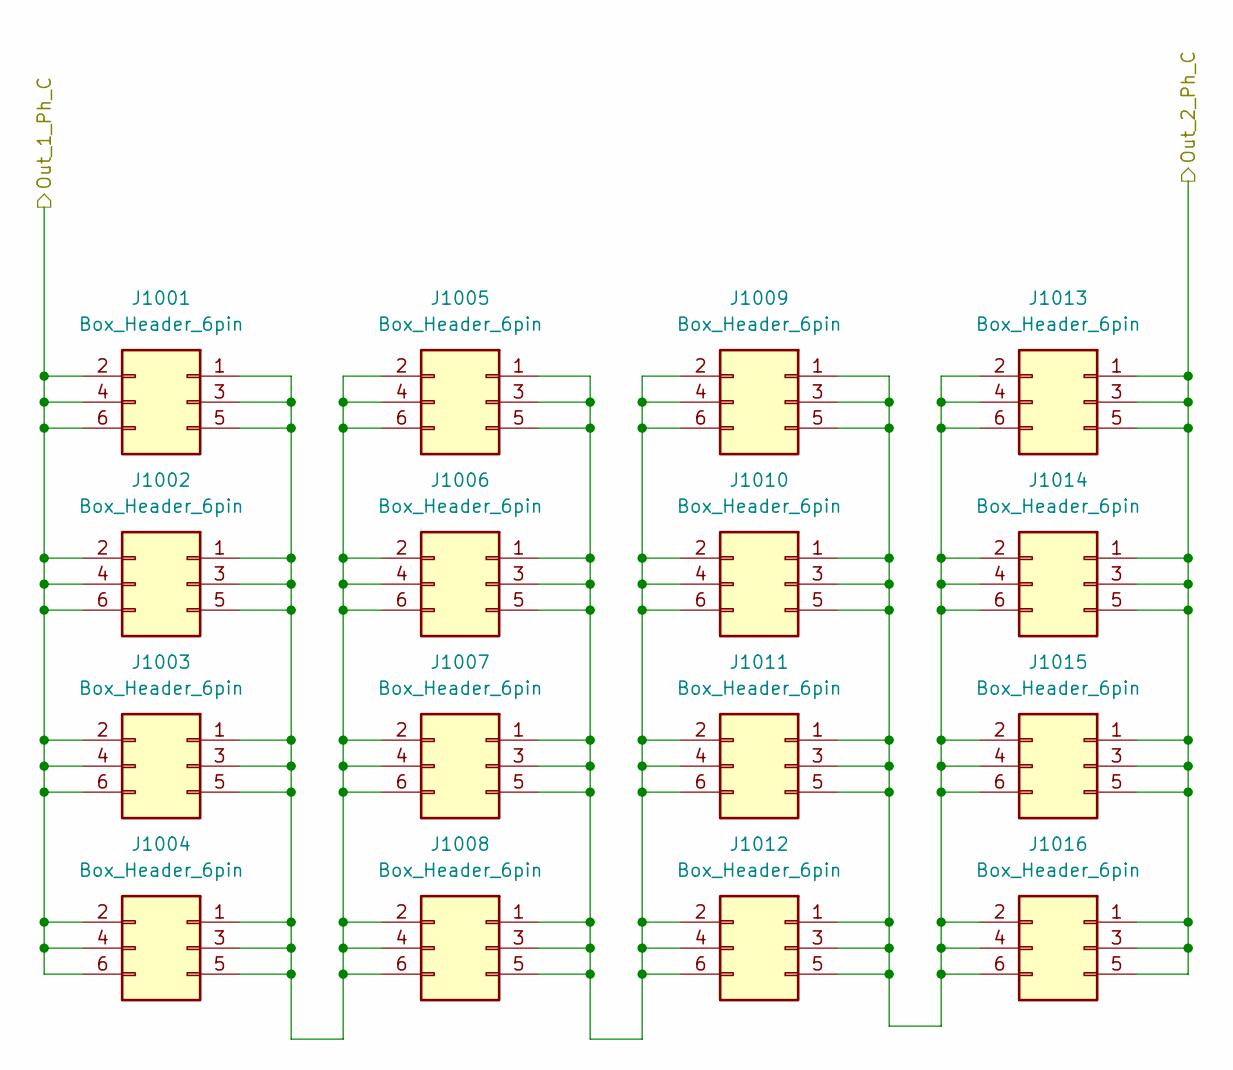
[picture p27: schematic chb_phase_c.kicad_sch]

Parts:
J1001, J1002, J1003, J1004, J1005, J1006, J1007, J1008, J1009, J1010, J1011, J1012, J1013, J1014, J1015, J1016: Box_Header_6pin; IDC-Header_2x03_P2.54mm_Vertical

Connections:
unnamed: J1001.1, J1001.3, J1001.5, J1002.1, J1002.3, J1002.5, J1003.1, J1003.3, J1003.5, J1004.1, J1004.3, J1004.5, J1005.2, J1005.4, J1005.6, J1006.2, J1006.4, J1006.6, J1007.2, J1007.4, J1007.6, J1008.2, J1008.4, J1008.6
unnamed: J1005.1, J1005.3, J1005.5, J1006.1, J1006.3, J1006.5, J1007.1, J1007.3, J1007.5, J1008.1, J1008.3, J1008.5, J1009.2, J1009.4, J1009.6, J1010.2, J1010.4, J1010.6, J1011.2, J1011.4, J1011.6, J1012.2, J1012.4, J1012.6
unnamed: J1009.1, J1009.3, J1009.5, J1010.1, J1010.3, J1010.5, J1011.1, J1011.3, J1011.5, J1012.1, J1012.3, J1012.5, J1013.2, J1013.4, J1013.6, J1014.2, J1014.4, J1014.6, J1015.2, J1015.4, J1015.6, J1016.2, J1016.4, J1016.6
Out_1_Ph_C: J1001.2, J1001.4, J1001.6, J1002.2, J1002.4, J1002.6, J1003.2, J1003.4, J1003.6, J1004.2, J1004.4, J1004.6
Out_2_Ph_C: J1013.1, J1013.3, J1013.5, J1014.1, J1014.3, J1014.5, J1015.1, J1015.3, J1015.5, J1016.1, J1016.3, J1016.5
