der-kollege/My_kicad_hardware/FPGA_Board_BA/PCB_Leo_edit/FPGA_Board_feb 01/chb_phase_d.kicad_sch

## KiCad design FPGA_Board_BA/PCB_Leo_edit/FPGA_Board_feb 01/chb_phase_d.kicad_sch (2025-11-10)

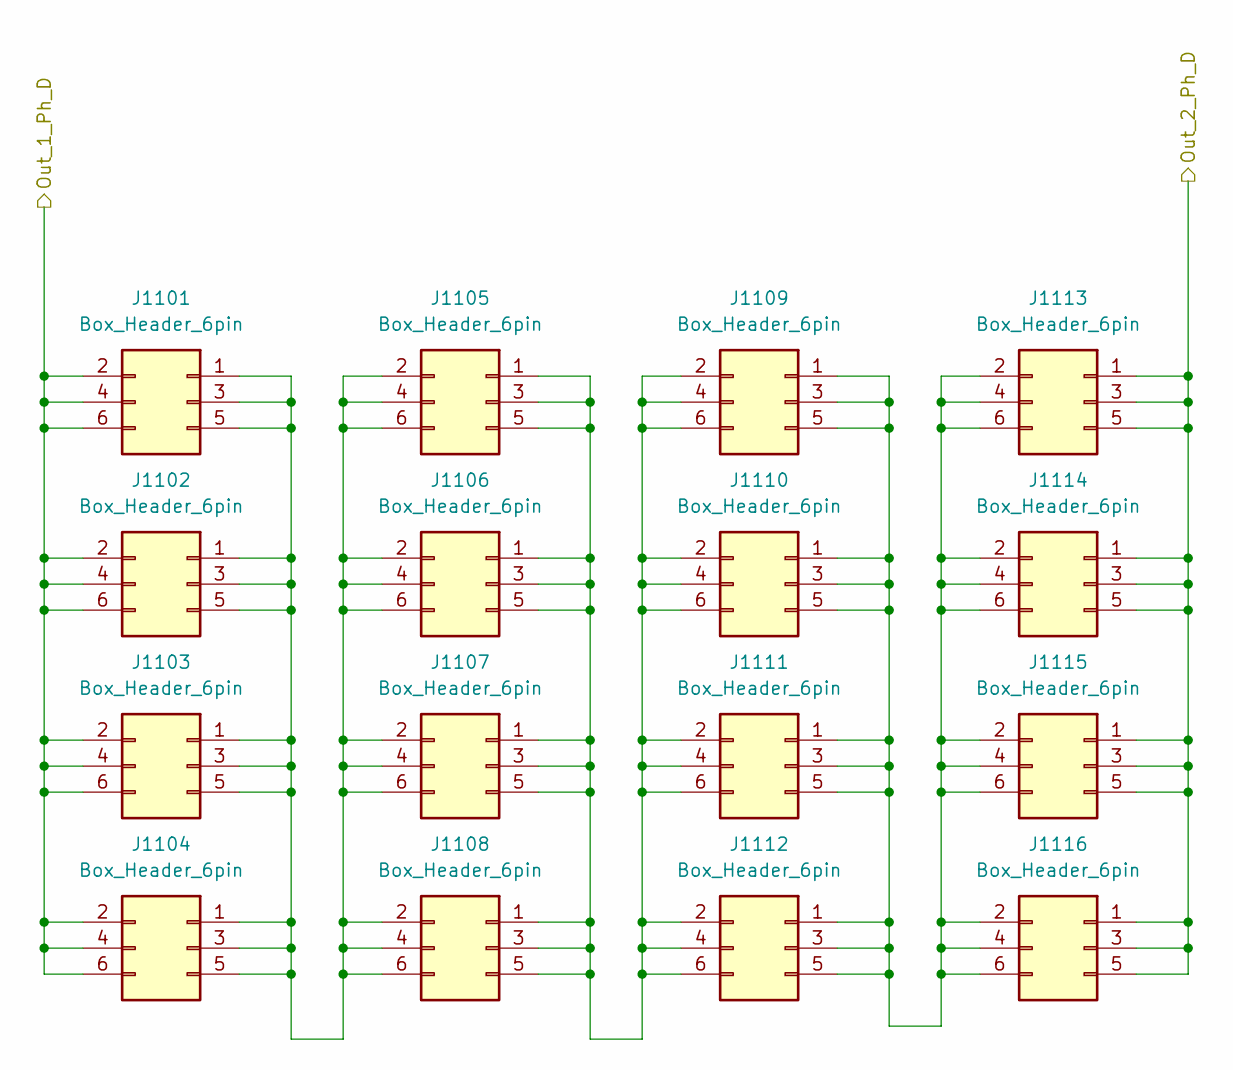
[picture p28: schematic chb_phase_d.kicad_sch]

Parts:
J1101, J1102, J1103, J1104, J1105, J1106, J1107, J1108, J1109, J1110, J1111, J1112, J1113, J1114, J1115, J1116: Box_Header_6pin; IDC-Header_2x03_P2.54mm_Vertical

Connections:
unnamed: J1101.1, J1101.3, J1101.5, J1102.1, J1102.3, J1102.5, J1103.1, J1103.3, J1103.5, J1104.1, J1104.3, J1104.5, J1105.2, J1105.4, J1105.6, J1106.2, J1106.4, J1106.6, J1107.2, J1107.4, J1107.6, J1108.2, J1108.4, J1108.6
unnamed: J1105.1, J1105.3, J1105.5, J1106.1, J1106.3, J1106.5, J1107.1, J1107.3, J1107.5, J1108.1, J1108.3, J1108.5, J1109.2, J1109.4, J1109.6, J1110.2, J1110.4, J1110.6, J1111.2, J1111.4, J1111.6, J1112.2, J1112.4, J1112.6
unnamed: J1109.1, J1109.3, J1109.5, J1110.1, J1110.3, J1110.5, J1111.1, J1111.3, J1111.5, J1112.1, J1112.3, J1112.5, J1113.2, J1113.4, J1113.6, J1114.2, J1114.4, J1114.6, J1115.2, J1115.4, J1115.6, J1116.2, J1116.4, J1116.6
Out_1_Ph_D: J1101.2, J1101.4, J1101.6, J1102.2, J1102.4, J1102.6, J1103.2, J1103.4, J1103.6, J1104.2, J1104.4, J1104.6
Out_2_Ph_D: J1113.1, J1113.3, J1113.5, J1114.1, J1114.3, J1114.5, J1115.1, J1115.3, J1115.5, J1116.1, J1116.3, J1116.5
