der-kollege/My_kicad_hardware/FPGA_Board_BA/PCB_Leo_edit/FPGA_Board_feb 01/connectors.kicad_sch

## KiCad design FPGA_Board_BA/PCB_Leo_edit/FPGA_Board_feb 01/connectors.kicad_sch (2025-11-23)

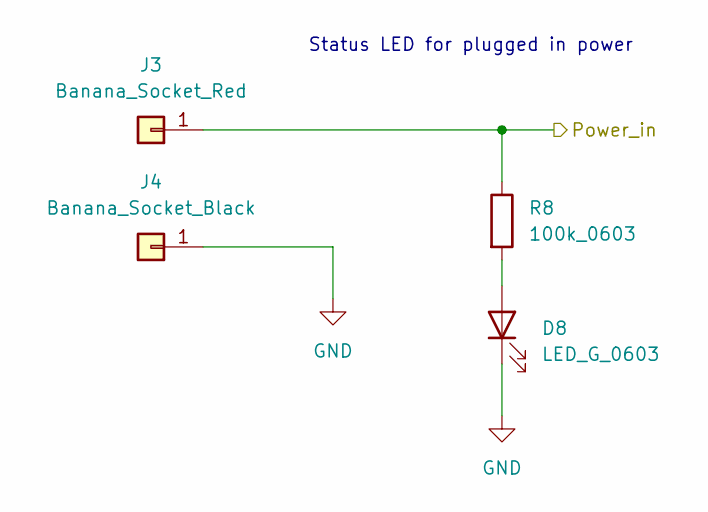
[picture p29: schematic connectors.kicad_sch]

Parts:
D8: LED_G_0603; LED_0603_1608Metric; Forward Voltage 2.65 V @ 2mA; FARNELL 2610409
J3: Banana_Socket_Red; Banana_Socket_Altech_Red; Digikey 973582101-ND
J4: Banana_Socket_Black; Banana_Socket_Aletch_Black; Digikey 973582100-ND
R8: 100k_0603; R_0603_1608Metric; Power Rating 100mW; FARNELL 2078921

Connections:
GND: D8.1 (K), J4.1
unnamed: D8.2 (A), R8.2
Power_in: J3.1, R8.1

Notes on the sheet:
Status LED for plugged in power
