der-kollege/My_kicad_hardware/FPGA_Board_BA/PCB_Leo_edit/FPGA_Board_feb 01/diffamp_.kicad_sch

## KiCad design FPGA_Board_BA/PCB_Leo_edit/FPGA_Board_feb 01/diffamp_.kicad_sch (2025-12-12)

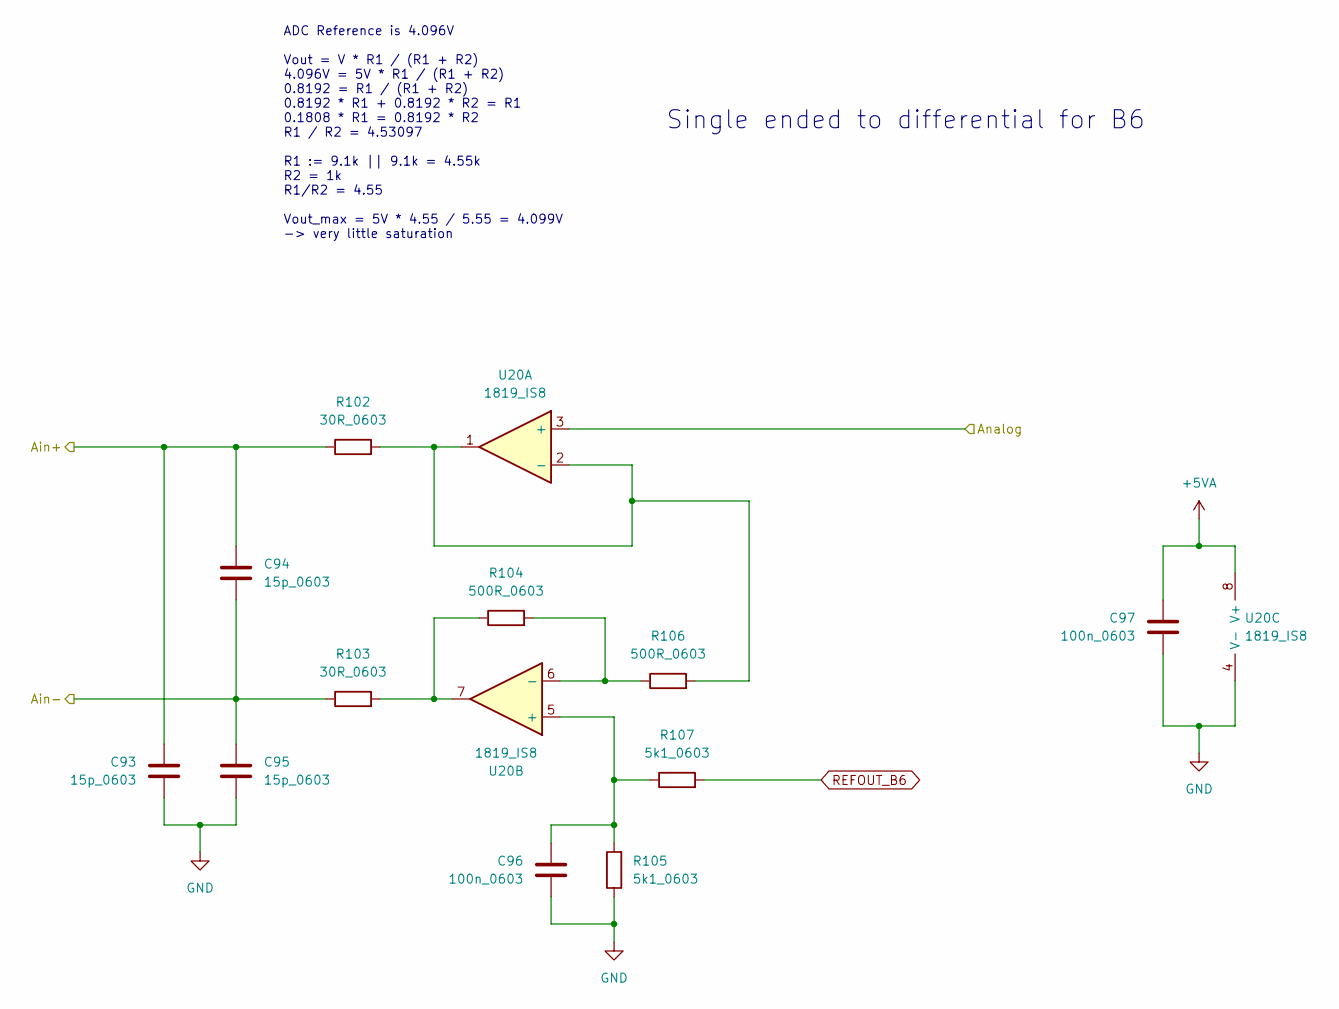
[picture p30: schematic diffamp_.kicad_sch]

Parts:
C93, C94, C95: 15p_0603; C_0603; FARNELL 1759124
C96, C97: 100n_0603; C_0603; FARNELL 1759037
R102, R103: 30R_0603; R_0603_1608Metric; Power Rating 50mW; FARNELL 1711574
R104, R106: 500R_0603; R_0603_1608Metric; FARNELL 2059312
R105, R107: 5k1_0603; R_0603_1608Metric; FARNELL 2447404
U20: 1819_IS8; LT1819

Connections:
+5VA: C97.1, U20.8 (V+)
Ain+: C93.1, C94.1, R102.1
Ain-: C94.2, C95.1, R103.1
Analog: U20.3 (+)
GND: C93.2, C95.2, C96.2, C97.2, R105.1, U20.4 (V-)
unnamed: C96.1, R105.2, R107.1, U20.5 (+)
unnamed: R102.2, R106.2, U20.1, U20.2 (-)
unnamed: R103.2, R104.1, U20.7
unnamed: R104.2, R106.1, U20.6 (-)
REFOUT_B6: R107.2

Notes on the sheet:
ADC Reference is 4.096V Vout = V * R1 / (R1 + R2) 4.096V = 5V * R1 / (R1 + R2) 0.8192 = R1 / (R1 + R2) 0.8192 * R1 + 0.8192 * R2 = R1 0.1808 * R1 = 0.8192 * R2 R1 / R2 = 4.53097 R1 := 9.1k || 9.1k = 4.55k R2 = 1k R1/R2 = 4.55 Vout_max = 5V * 4.55 / 5.55 = 4.099V -> very little saturation
Single ended to differential for B6
