der-kollege/My_kicad_hardware/FPGA_Board_BA/PCB_Leo_edit/FPGA_Board_feb 01/diffamp_adc.kicad_sch

## KiCad design FPGA_Board_BA/PCB_Leo_edit/FPGA_Board_feb 01/diffamp_adc.kicad_sch (2025-12-17)

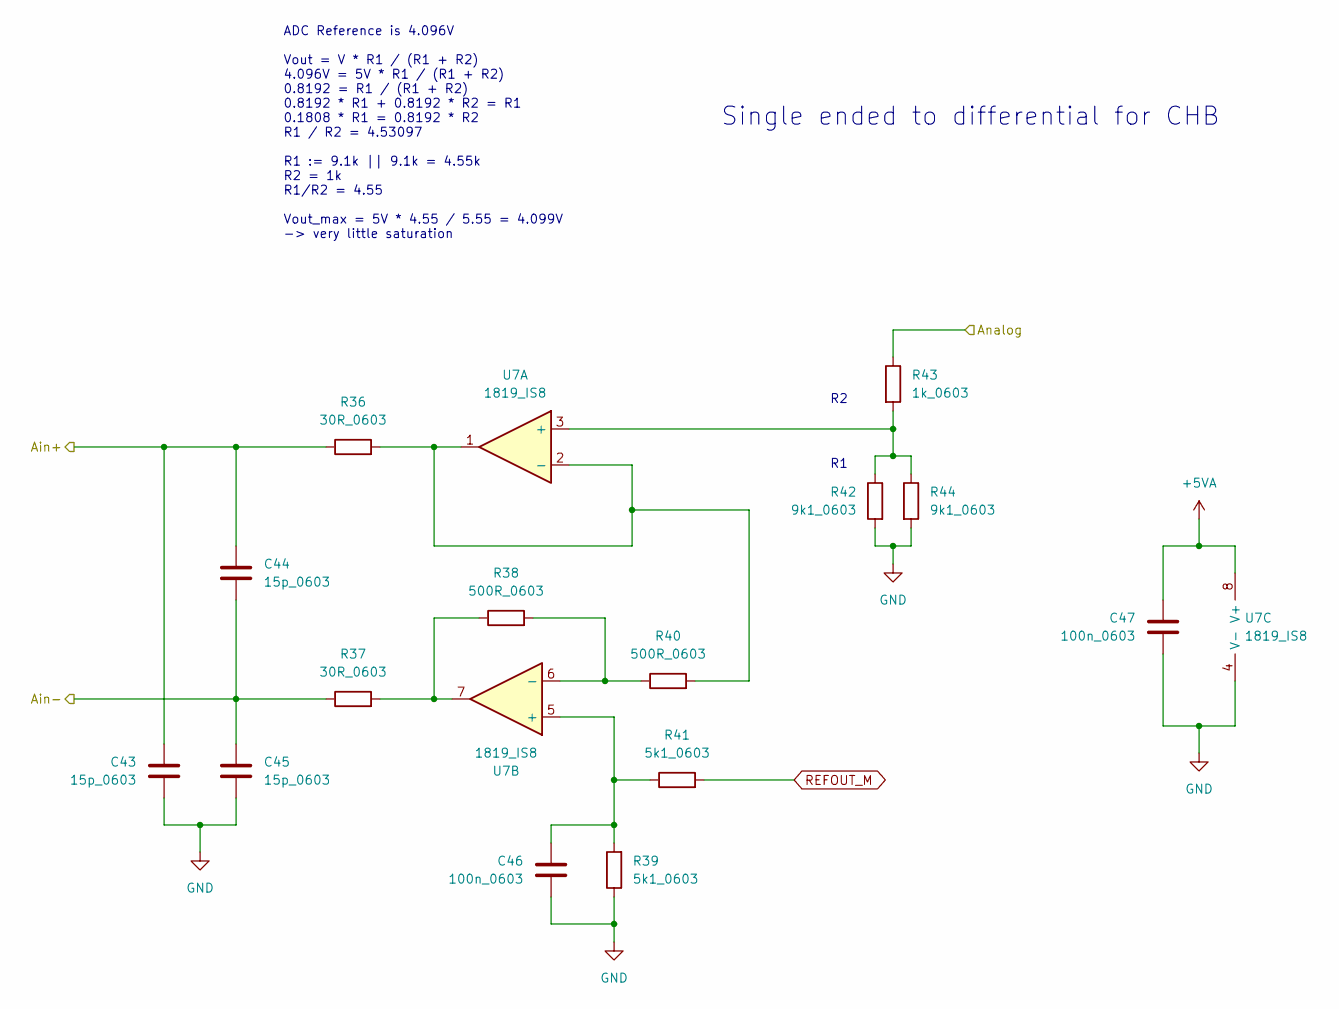
[picture p31: schematic diffamp_adc.kicad_sch]

Parts:
C43, C44, C45: 15p_0603; C_0603; FARNELL 1759124
C46, C47: 100n_0603; C_0603; FARNELL 1759037
R36, R37: 30R_0603; R_0603_1608Metric; Power Rating 50mW; FARNELL 1711574
R38, R40: 500R_0603; R_0603_1608Metric; FARNELL 2059312
R39, R41: 5k1_0603; R_0603_1608Metric; FARNELL 2447404
R42, R44: 9k1_0603; R_0603_1608Metric
R43: 1k_0603; R_0603_1608Metric; FARNELL 2078907
U7: 1819_IS8; LT1819

Connections:
+5VA: C47.1, U7.8 (V+)
Ain+: C43.1, C44.1, R36.1
Ain-: C44.2, C45.1, R37.1
Analog: R43.1
GND: C43.2, C45.2, C46.2, C47.2, R39.1, R42.2, R44.2, U7.4 (V-)
unnamed: C46.1, R39.2, R41.1, U7.5 (+)
unnamed: R36.2, R40.2, U7.1, U7.2 (-)
unnamed: R37.2, R38.1, U7.7
unnamed: R38.2, R40.1, U7.6 (-)
unnamed: R42.1, R43.2, R44.1, U7.3 (+)
REFOUT_M: R41.2

Notes on the sheet:
ADC Reference is 4.096V Vout = V * R1 / (R1 + R2) 4.096V = 5V * R1 / (R1 + R2) 0.8192 = R1 / (R1 + R2) 0.8192 * R1 + 0.8192 * R2 = R1 0.1808 * R1 = 0.8192 * R2 R1 / R2 = 4.53097 R1 := 9.1k || 9.1k = 4.55k R2 = 1k R1/R2 = 4.55 Vout_max = 5V * 4.55 / 5.55 = 4.099V -> very little saturation
Single ended to differential for CHB
