der-kollege/My_kicad_hardware/FPGA_Board_BA/PCB_Leo_edit/FPGA_Board_feb 01/en_err_circuit.kicad_sch

## KiCad design FPGA_Board_BA/PCB_Leo_edit/FPGA_Board_feb 01/en_err_circuit.kicad_sch (2026-01-25)

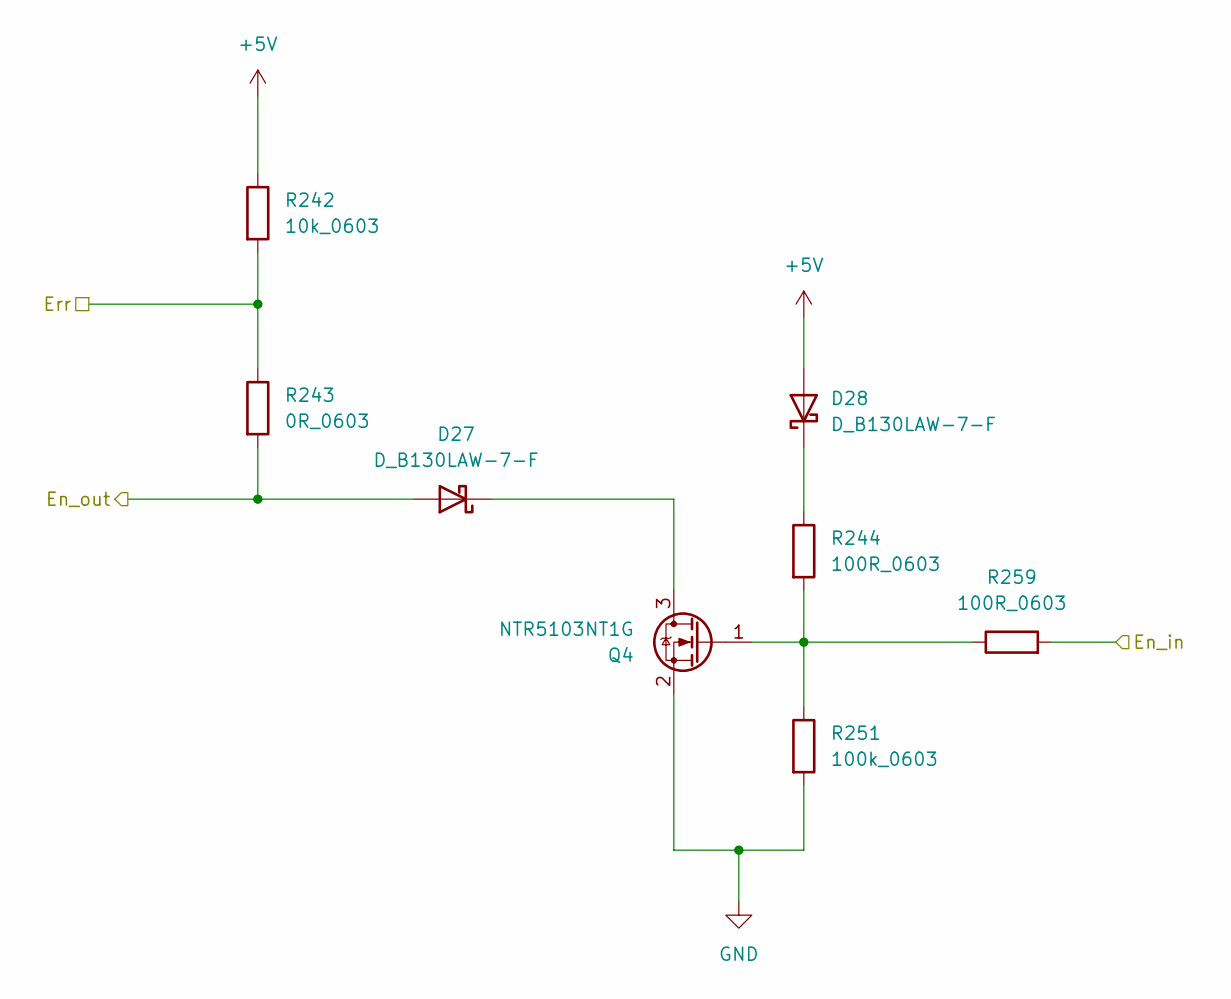
[picture p32: schematic en_err_circuit.kicad_sch]

Parts:
D27, D28: D_B130LAW-7-F; DO_SOD_123; Forward Voltage 420mV max; Reverse Voltage 30V; FARNELL 1858617
Q4: NTR5103NT1G; SOT-23_Handsoldering; Rated Voltage 60V; FARNELL 2724423
R242: 10k_0603; R_0603_1608Metric; FARNELL 2447230
R243: 0R_0603; R_0603_1608Metric; FARNELL 2309111
R244, R259: 100R_0603; R_0603_1608Metric; FARNELL 2078901
R251: 100k_0603; R_0603_1608Metric; Power Rating 100mW; FARNELL 2078921

Connections:
+5V: D28.2 (A), R242.1
En_in: R259.2
En_out: D27.2 (A), R243.2
Err: R242.2, R243.1
GND: Q4.2 (S), R251.2
unnamed: D27.1 (K), Q4.3 (D)
unnamed: D28.1 (K), R244.1
unnamed: Q4.1 (G), R244.2, R251.1, R259.1
