der-kollege/My_kicad_hardware/FPGA_Board_BA/PCB_Leo_edit/FPGA_Board_feb 01/esd_diodes.kicad_sch

## KiCad design FPGA_Board_BA/PCB_Leo_edit/FPGA_Board_feb 01/esd_diodes.kicad_sch (2025-11-23)

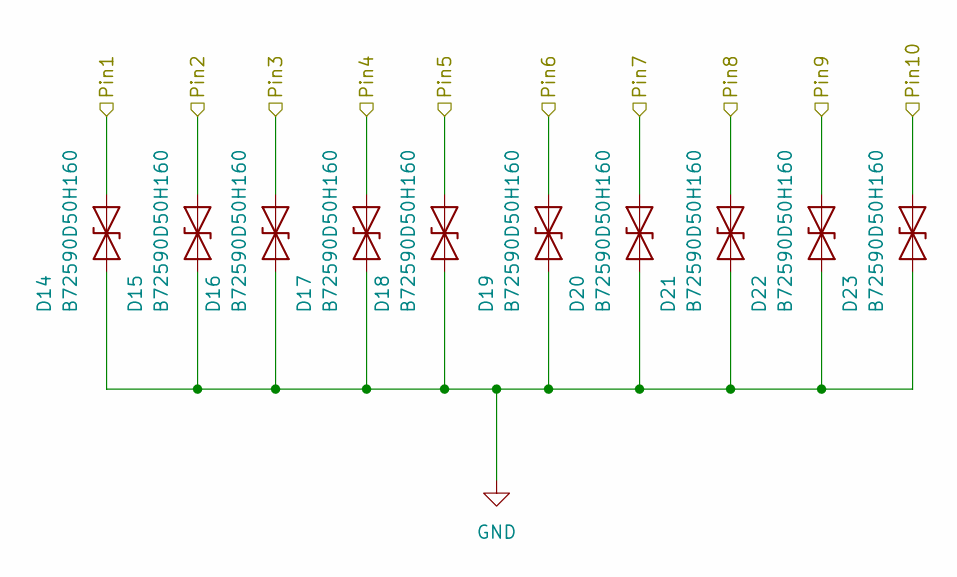
[picture p33: schematic esd_diodes.kicad_sch]

Parts:
D14, D15, D16, D17, D18, D19, D20, D21, D22, D23: B72590D50H160; C_0402_1005Metric_Pad0.74x0.62mm_HandSolder; Mouser nr. 871-B72590D50H160

Connections:
GND: D14.2 (A2), D15.2 (A2), D16.2 (A2), D17.2 (A2), D18.2 (A2), D19.2 (A2), D20.2 (A2), D21.2 (A2), D22.2 (A2), D23.2 (A2)
Pin1: D14.1 (A1)
Pin2: D15.1 (A1)
Pin3: D16.1 (A1)
Pin4: D17.1 (A1)
Pin5: D18.1 (A1)
Pin6: D19.1 (A1)
Pin7: D20.1 (A1)
Pin8: D21.1 (A1)
Pin9: D22.1 (A1)
Pin10: D23.1 (A1)
