der-kollege/My_kicad_hardware/FPGA_Board_BA/PCB_Leo_edit/FPGA_Board_feb 01/fpga.kicad_sch

## KiCad design FPGA_Board_BA/PCB_Leo_edit/FPGA_Board_feb 01/fpga.kicad_sch (2025-12-31)

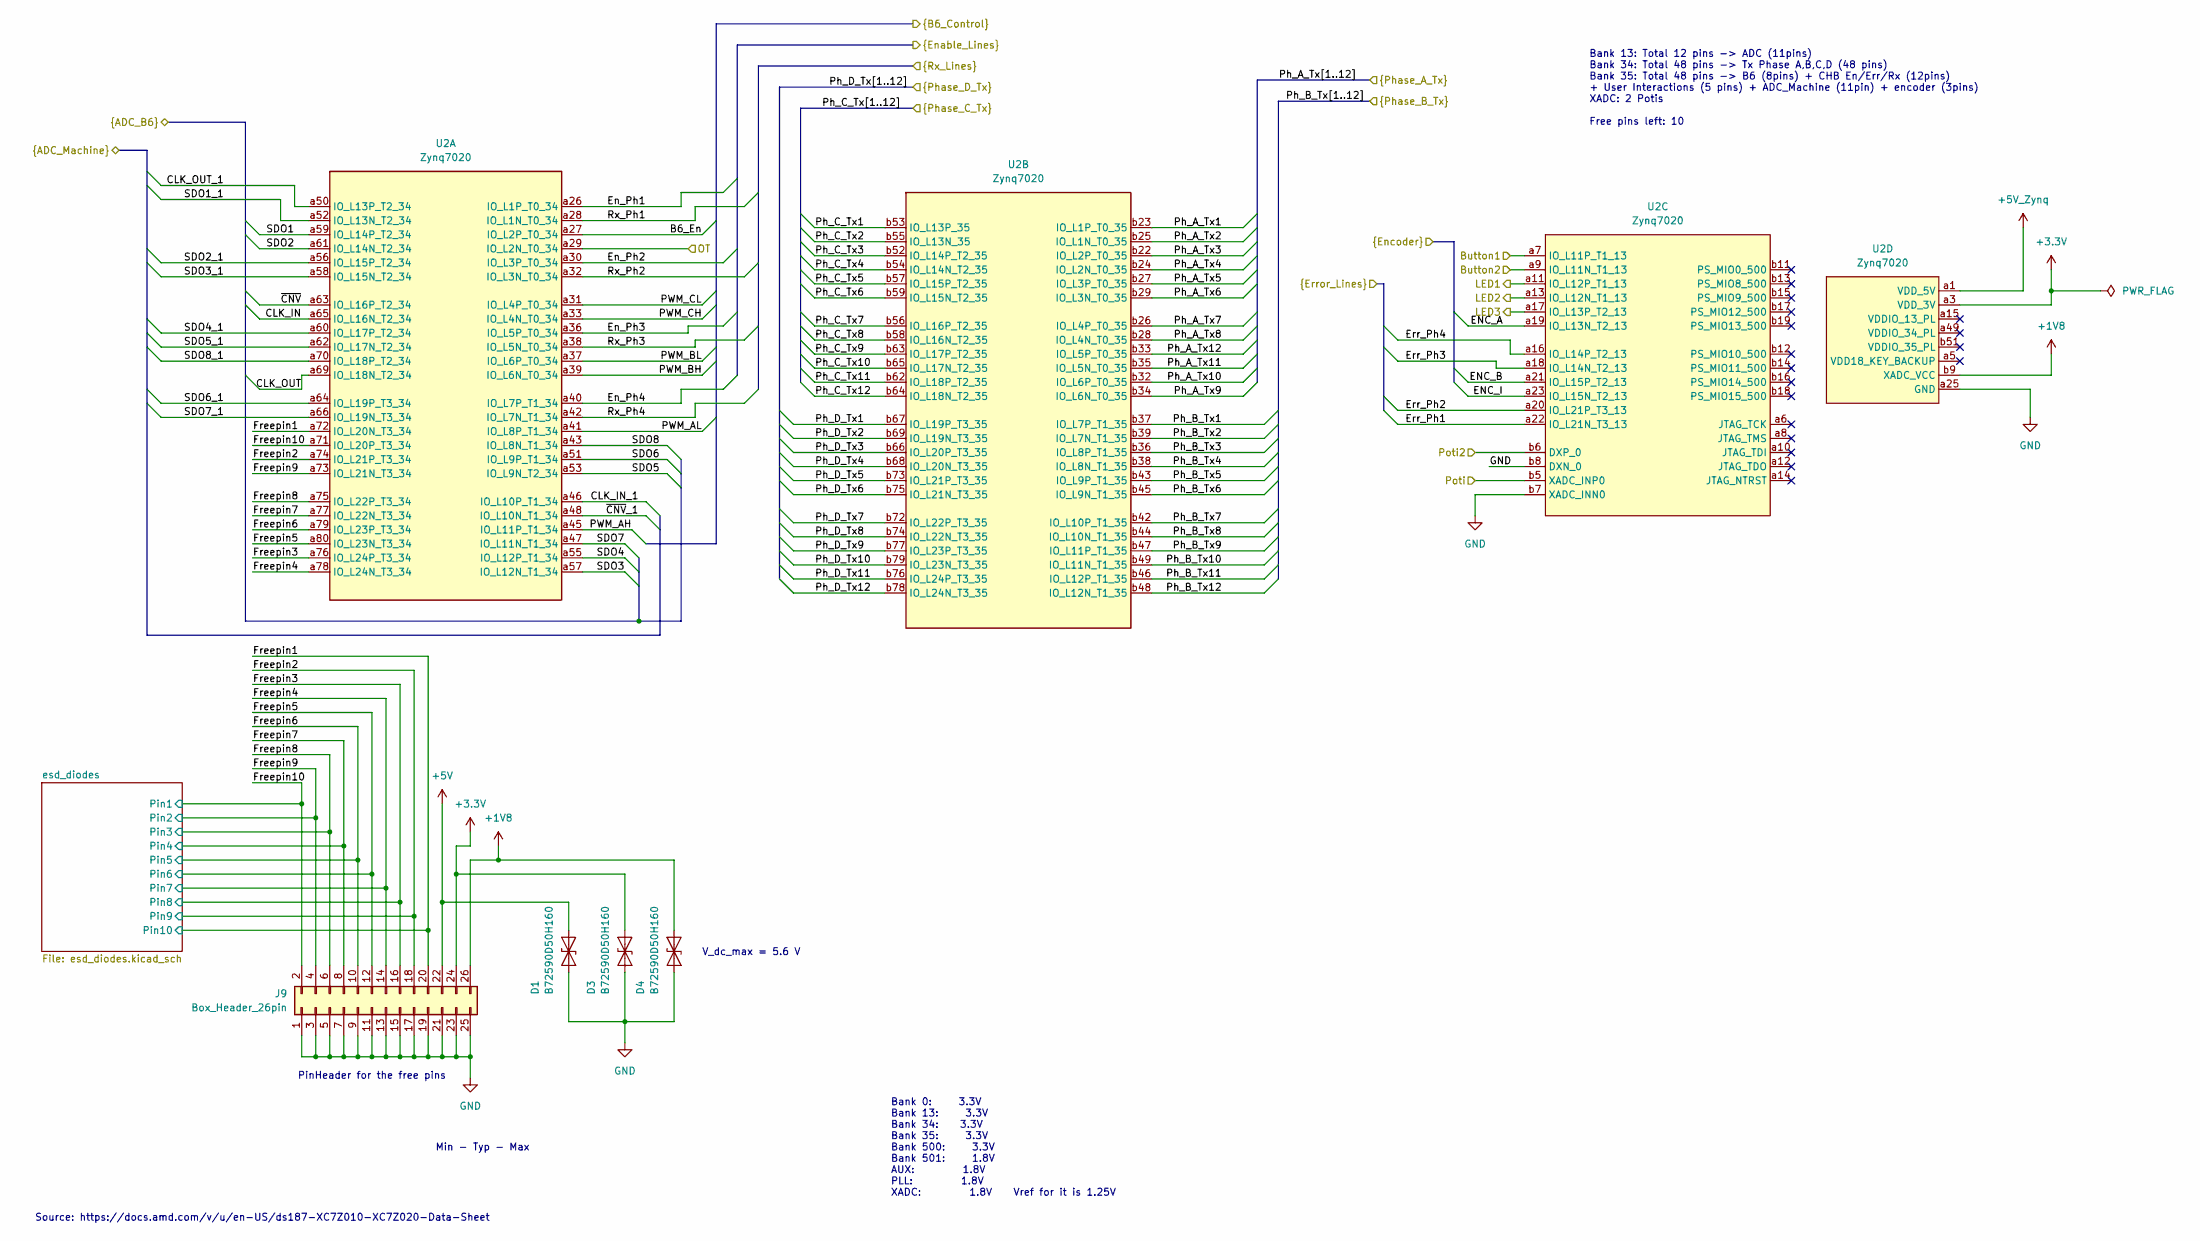
[picture p34: schematic fpga.kicad_sch]

Parts:
D1, D3, D4: B72590D50H160; C_0402_1005Metric_Pad0.74x0.62mm_HandSolder; Mouser nr. 871-B72590D50H160
J9: Box_Header_26pin; IDC-Header_2x13_P2.54mm_Vertical
U2: Zynq7020; Mouser nr connector 200-TFM14002LDWT

Connections:
+1V8: D4.1 (A1), J9.26, U2.b9 (XADC_VCC)
+3.3V: D3.1 (A1), J9.24, U2.a3 (VDD_3V), U2.b3 (VDD_3V)
+5V: D1.1 (A1), J9.22
+5V_Zynq: U2.a1 (VDD_5V), U2.b1 (VDD_5V)
B6_En: U2.a27 (IO_L2P_T0_34)
Button1: U2.a7 (IO_L11P_T1_13)
Button2: U2.a9 (IO_L11N_T1_13)
CLK_IN: U2.a65 (IO_L16N_T2_34)
CLK_IN_1: U2.a46 (IO_L10P_T1_34)
CLK_OUT: U2.a69 (IO_L18N_T2_34)
CLK_OUT_1: U2.a50 (IO_L13P_T2_34)
ENC_A: U2.a19 (IO_L13N_T2_13)
ENC_B: U2.a21 (IO_L15P_T2_13)
ENC_I: U2.a23 (IO_L15N_T2_13)
En_Ph1: U2.a26 (IO_L1P_T0_34)
En_Ph2: U2.a30 (IO_L3P_T0_34)
En_Ph3: U2.a36 (IO_L5P_T0_34)
En_Ph4: U2.a40 (IO_L7P_T1_34)
Err_Ph1: U2.a22 (IO_L21N_T3_13)
Err_Ph2: U2.a20 (IO_L21P_T3_13)
Err_Ph3: U2.a18 (IO_L14N_T2_13)
Err_Ph4: U2.a16 (IO_L14P_T2_13)
Freepin1: J9.20, U2.a72 (IO_L20N_T3_34)
Freepin2: J9.18, U2.a74 (IO_L21P_T3_34)
Freepin3: J9.16, U2.a76 (IO_L24P_T3_34)
Freepin4: J9.14, U2.a78 (IO_L24N_T3_34)
Freepin5: J9.12, U2.a80 (IO_L23N_T3_34)
Freepin6: J9.10, U2.a79 (IO_L23P_T3_34)
Freepin7: J9.8, U2.a77 (IO_L22N_T3_34)
Freepin8: J9.6, U2.a75 (IO_L22P_T3_34)
Freepin9: J9.4, U2.a73 (IO_L21N_T3_34)
Freepin10: J9.2, U2.a71 (IO_L20P_T3_34)
GND: D1.2 (A2), D3.2 (A2), D4.2 (A2), J9.1, J9.3, J9.5, J9.7, J9.9, J9.11, J9.13, J9.15, J9.17, J9.19, J9.21, J9.23, J9.25, U2.a2 (GND), U2.a4 (GND), U2.a24 (GND), U2.a25 (GND), U2.a34 (GND), U2.a35 (GND), U2.a44 (GND), U2.a54 (GND), U2.a67 (GND), U2.a68 (GND), U2.b2 (GND), U2.b4 (GND), U2.b7 (XADC_INN0), U2.b8 (DXN_0), U2.b10 (GND), U2.b20 (GND), U2.b21 (GND), U2.b30 (GND), U2.b31 (GND), U2.b40 (GND), U2.b41 (GND), U2.b50 (GND), U2.b60 (GND), U2.b61 (GND), U2.b70 (GND), U2.b71 (GND), U2.b80 (GND)
LED1: U2.a11 (IO_L12P_T1_13)
LED2: U2.a13 (IO_L12N_T1_13)
LED3: U2.a17 (IO_L13P_T2_13)
OT: U2.a29 (IO_L2N_T0_34)
PWM_AH: U2.a45 (IO_L11P_T1_34)
PWM_AL: U2.a41 (IO_L8P_T1_34)
PWM_BH: U2.a39 (IO_L6N_T0_34)
PWM_BL: U2.a37 (IO_L6P_T0_34)
PWM_CH: U2.a33 (IO_L4N_T0_34)
PWM_CL: U2.a31 (IO_L4P_T0_34)
Ph_A_Tx1: U2.b23 (IO_L1P_T0_35)
Ph_A_Tx2: U2.b25 (IO_L1N_T0_35)
Ph_A_Tx3: U2.b22 (IO_L2P_T0_35)
Ph_A_Tx4: U2.b24 (IO_L2N_T0_35)
Ph_A_Tx5: U2.b27 (IO_L3P_T0_35)
Ph_A_Tx6: U2.b29 (IO_L3N_T0_35)
Ph_A_Tx7: U2.b26 (IO_L4P_T0_35)
Ph_A_Tx8: U2.b28 (IO_L4N_T0_35)
Ph_A_Tx9: U2.b34 (IO_L6N_T0_35)
Ph_A_Tx10: U2.b32 (IO_L6P_T0_35)
Ph_A_Tx11: U2.b35 (IO_L5N_T0_35)
Ph_A_Tx12: U2.b33 (IO_L5P_T0_35)
Ph_B_Tx1: U2.b37 (IO_L7P_T1_35)
Ph_B_Tx2: U2.b39 (IO_L7N_T1_35)
Ph_B_Tx3: U2.b36 (IO_L8P_T1_35)
Ph_B_Tx4: U2.b38 (IO_L8N_T1_35)
Ph_B_Tx5: U2.b43 (IO_L9P_T1_35)
Ph_B_Tx6: U2.b45 (IO_L9N_T1_35)
Ph_B_Tx7: U2.b42 (IO_L10P_T1_35)
Ph_B_Tx8: U2.b44 (IO_L10N_T1_35)
Ph_B_Tx9: U2.b47 (IO_L11P_T1_35)
Ph_B_Tx10: U2.b49 (IO_L11N_T1_35)
Ph_B_Tx11: U2.b46 (IO_L12P_T1_35)
Ph_B_Tx12: U2.b48 (IO_L12N_T1_35)
Ph_C_Tx1: U2.b53 (IO_L13P_35)
Ph_C_Tx2: U2.b55 (IO_L13N_35)
Ph_C_Tx3: U2.b52 (IO_L14P_T2_35)
Ph_C_Tx4: U2.b54 (IO_L14N_T2_35)
Ph_C_Tx5: U2.b57 (IO_L15P_T2_35)
Ph_C_Tx6: U2.b59 (IO_L15N_T2_35)
Ph_C_Tx7: U2.b56 (IO_L16P_T2_35)
Ph_C_Tx8: U2.b58 (IO_L16N_T2_35)
Ph_C_Tx9: U2.b63 (IO_L17P_T2_35)
Ph_C_Tx10: U2.b65 (IO_L17N_T2_35)
Ph_C_Tx11: U2.b62 (IO_L18P_T2_35)
Ph_C_Tx12: U2.b64 (IO_L18N_T2_35)
Ph_D_Tx1: U2.b67 (IO_L19P_T3_35)
Ph_D_Tx2: U2.b69 (IO_L19N_T3_35)
Ph_D_Tx3: U2.b66 (IO_L20P_T3_35)
Ph_D_Tx4: U2.b68 (IO_L20N_T3_35)
Ph_D_Tx5: U2.b73 (IO_L21P_T3_35)
Ph_D_Tx6: U2.b75 (IO_L21N_T3_35)
Ph_D_Tx7: U2.b72 (IO_L22P_T3_35)
Ph_D_Tx8: U2.b74 (IO_L22N_T3_35)
Ph_D_Tx9: U2.b77 (IO_L23P_T3_35)
Ph_D_Tx10: U2.b79 (IO_L23N_T3_35)
Ph_D_Tx11: U2.b76 (IO_L24P_T3_35)
Ph_D_Tx12: U2.b78 (IO_L24N_T3_35)
Poti: U2.b5 (XADC_INP0)
Poti2: U2.b6 (DXP_0)
Rx_Ph1: U2.a28 (IO_L1N_T0_34)
Rx_Ph2: U2.a32 (IO_L3N_T0_34)
Rx_Ph3: U2.a38 (IO_L5N_T0_34)
Rx_Ph4: U2.a42 (IO_L7N_T1_34)
SDO1: U2.a59 (IO_L14P_T2_34)
SDO1_1: U2.a52 (IO_L13N_T2_34)
SDO2: U2.a61 (IO_L14N_T2_34)
SDO2_1: U2.a56 (IO_L15P_T2_34)
SDO3: U2.a57 (IO_L12N_T1_34)
SDO3_1: U2.a58 (IO_L15N_T2_34)
SDO4: U2.a55 (IO_L12P_T1_34)
SDO4_1: U2.a60 (IO_L17P_T2_34)
SDO5: U2.a53 (IO_L9N_T2_34)
SDO5_1: U2.a62 (IO_L17N_T2_34)
SDO6: U2.a51 (IO_L9P_T1_34)
SDO6_1: U2.a64 (IO_L19P_T3_34)
SDO7: U2.a47 (IO_L11N_T1_34)
SDO7_1: U2.a66 (IO_L19N_T3_34)
SDO8: U2.a43 (IO_L8N_T1_34)
SDO8_1: U2.a70 (IO_L18P_T2_34)
~CNV: U2.a63 (IO_L16P_T2_34)
~CNV_1: U2.a48 (IO_L10N_T1_34)

Notes on the sheet:
Bank 13: Total 12 pins -> ADC (11pins) Bank 34: Total 48 pins -> Tx Phase A,B,C,D (48 pins) Bank 35: Total 48 pins -> B6 (8pins) + CHB En/Err/Rx (12pins) + User Interactions (5 pins) + ADC_Machine (11pin) + encoder (3pins) XADC: 2 Potis Free pins left: 10
PinHeader for the free pins
Min - Typ - Max
Bank 0: 3.3V Bank 13: 3.3V Bank 34: 3.3V Bank 35: 3.3V Bank 500: 3.3V Bank 501: 1.8V AUX: 1.8V PLL: 1.8V XADC: 1.8V Vref for it is 1.25V
V_dc_max = 5.6 V
Source: https://docs.amd.com/v/u/en-US/ds187-XC7Z010-XC7Z020-Data-Sheet
