der-kollege/My_kicad_hardware/FPGA_Board_BA/PCB_Leo_edit/FPGA_Board_feb 01/leg_1.kicad_sch

## KiCad design FPGA_Board_BA/PCB_Leo_edit/FPGA_Board_feb 01/leg_1.kicad_sch (2025-12-17)

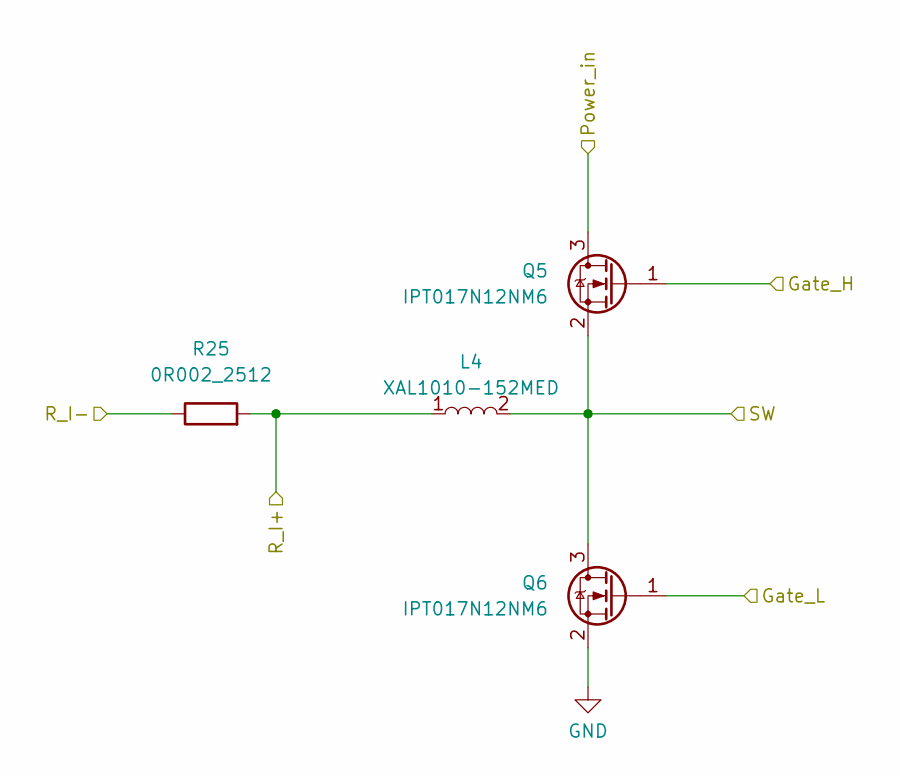
[picture p35: schematic leg_1.kicad_sch]

Parts:
L4: XAL1010-152MED; L_Coilcraft_XAL1010-XXX; Mouser 994-XAL1010-152MED
Q5, Q6: IPT017N12NM6; Infineon_PG-HSOF-8-1; Mouser nr 726-IPT017N12NM6ATMA
R25: 0R002_2512; R_2512_6332Metric; Mouser nr 708-CSNL2512FT2L00

Connections:
GND: Q6.2 (S)
Gate_H: Q5.1 (G)
Gate_L: Q6.1 (G)
Power_in: Q5.3 (D)
R_I+: L4.1, R25.2
R_I-: R25.1
SW: L4.2, Q5.2 (S), Q6.3 (D)
