der-kollege/My_kicad_hardware/FPGA_Board_BA/PCB_Leo_edit/FPGA_Board_feb 01/level_shifter_8bit.kicad_sch

## KiCad design FPGA_Board_BA/PCB_Leo_edit/FPGA_Board_feb 01/level_shifter_8bit.kicad_sch (2025-11-23)

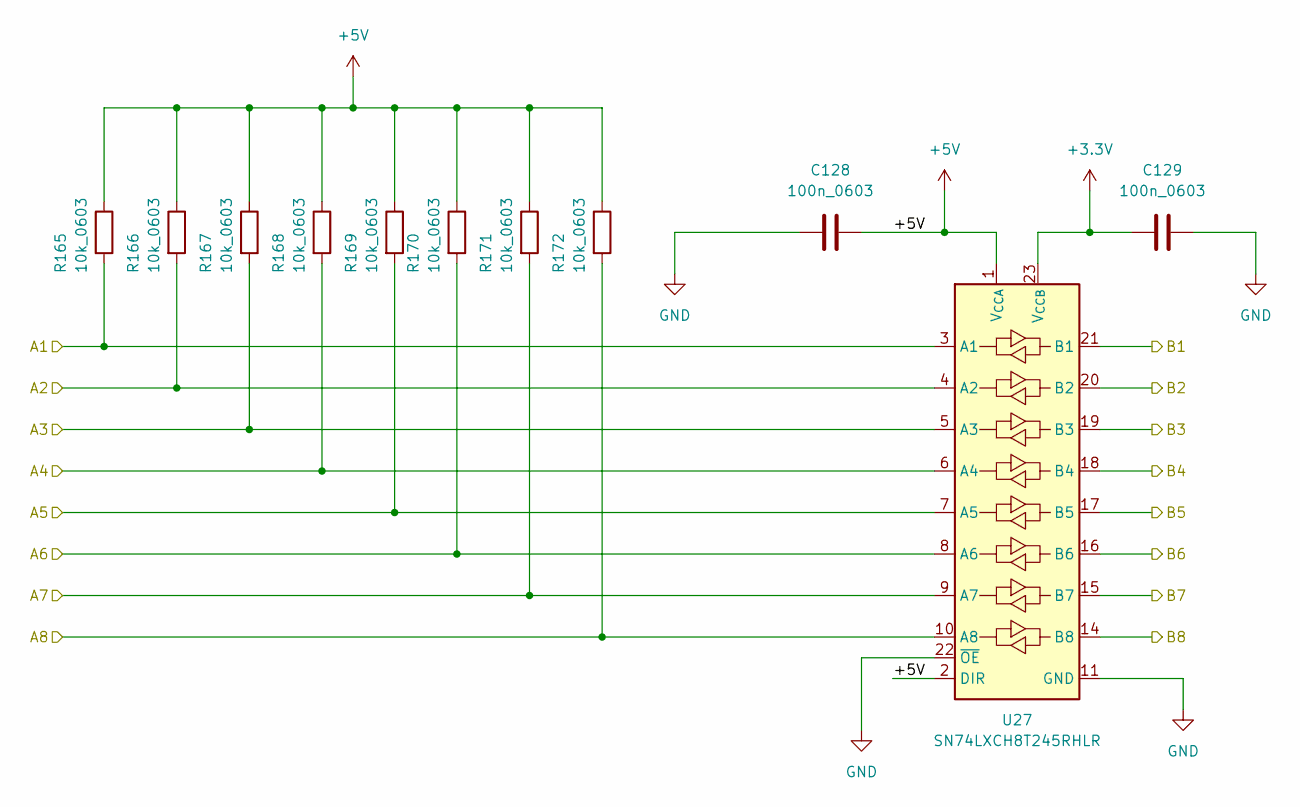
[picture p36: schematic level_shifter_8bit.kicad_sch]

Parts:
C128, C129: 100n_0603; C_0603; FARNELL 1759037
R165, R166, R167, R168, R169, R170, R171, R172: 10k_0603; R_0603_1608Metric; FARNELL 2447230
U27: SN74LXCH8T245RHLR; SN74LXCH8T245

Connections:
+3.3V: C129.1, U27.23 (V_{CCB}), U27.24 (V_{CCB})
+5V: C128.2, R165.1, R166.1, R167.1, R168.1, R169.1, R170.1, R171.1, R172.1, U27.1 (V_{CCA}), U27.2 (DIR)
A1: R165.2, U27.3 (A1)
A2: R166.2, U27.4 (A2)
A3: R167.2, U27.5 (A3)
A4: R168.2, U27.6 (A4)
A5: R169.2, U27.7 (A5)
A6: R170.2, U27.8 (A6)
A7: R171.2, U27.9 (A7)
A8: R172.2, U27.10 (A8)
B1: U27.21 (B1)
B2: U27.20 (B2)
B3: U27.19 (B3)
B4: U27.18 (B4)
B5: U27.17 (B5)
B6: U27.16 (B6)
B7: U27.15 (B7)
B8: U27.14 (B8)
GND: C128.1, C129.2, U27.11 (GND), U27.12 (GND), U27.13 (GND), U27.22 (~OE)
