der-kollege/My_kicad_hardware/FPGA_Board_BA/PCB_Leo_edit/FPGA_Board_feb 01/ls_clkout.kicad_sch

## KiCad design FPGA_Board_BA/PCB_Leo_edit/FPGA_Board_feb 01/ls_clkout.kicad_sch (2025-12-30)

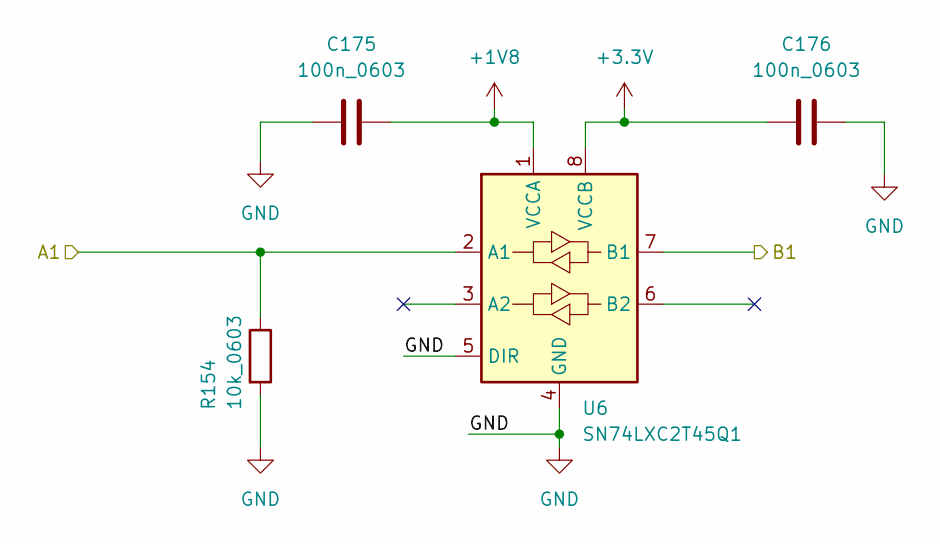
[picture p37: schematic ls_clkout.kicad_sch]

Parts:
C175, C176: 100n_0603; C_0603; FARNELL 1759037
R154: 10k_0603; R_0603_1608Metric; FARNELL 2447230
U6: SN74LXC2T45Q1; SN74LXC2T45QDCURQ1; Mouser nr 595-74LXC2T45QDCURQ1

Connections:
+1V8: C175.2, U6.1 (VCCA)
+3.3V: C176.1, U6.8 (VCCB)
A1: R154.1, U6.2 (A1)
B1: U6.7 (B1)
GND: C175.1, C176.2, R154.2, U6.4 (GND), U6.5 (DIR)
