der-kollege/My_kicad_hardware/FPGA_Board_BA/PCB_Leo_edit/FPGA_Board_feb 01/ls_encoder.kicad_sch

## KiCad design FPGA_Board_BA/PCB_Leo_edit/FPGA_Board_feb 01/ls_encoder.kicad_sch (2026-01-01)

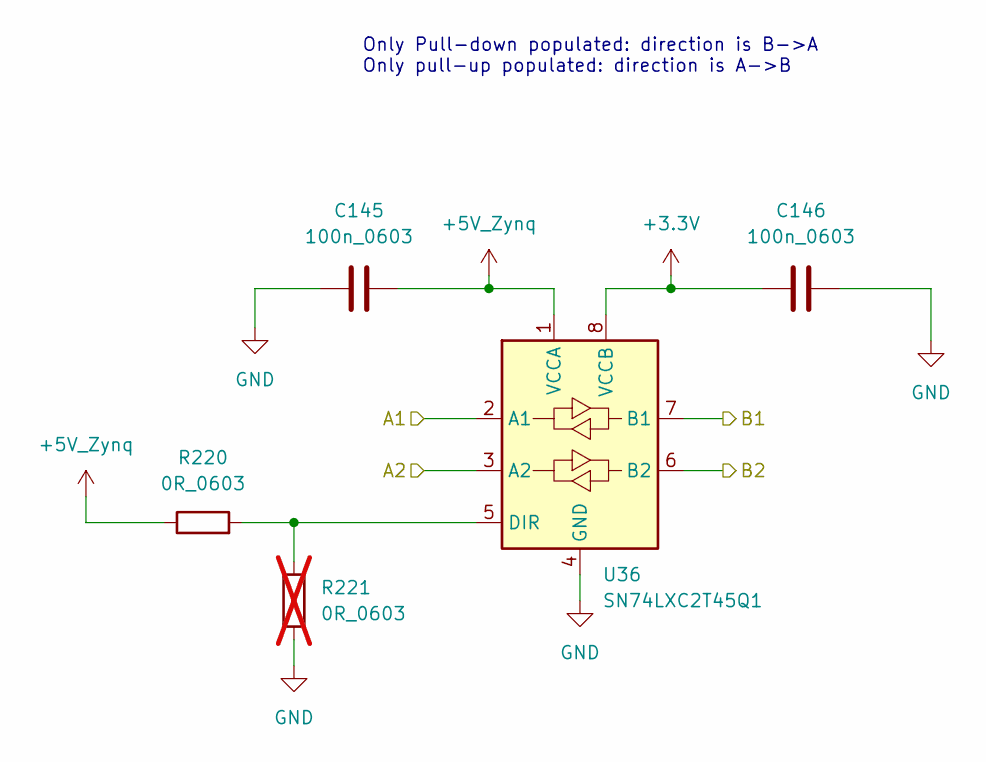
[picture p38: schematic ls_encoder.kicad_sch]

Parts:
C145, C146: 100n_0603; C_0603; FARNELL 1759037
R220: 0R_0603; R_0603_1608Metric; FARNELL 2309111
R221: 0R_0603; R_0603_1608Metric; FARNELL 2309111; not fitted
U36: SN74LXC2T45Q1; SN74LXC2T45QDCURQ1; Mouser nr 595-74LXC2T45QDCURQ1

Connections:
+3.3V: C146.1, U36.8 (VCCB)
+5V_Zynq: C145.2, R220.1, U36.1 (VCCA)
A1: U36.2 (A1)
A2: U36.3 (A2)
B1: U36.7 (B1)
B2: U36.6 (B2)
GND: C145.1, C146.2, R221.1, U36.4 (GND)
unnamed: R220.2, R221.2, U36.5 (DIR)

Notes on the sheet:
Only Pull-down populated: direction is B->A Only pull-up populated: direction is A->B
