der-kollege/My_kicad_hardware/FPGA_Board_BA/PCB_Leo_edit/FPGA_Board_feb 01/ls_error.kicad_sch

## KiCad design FPGA_Board_BA/PCB_Leo_edit/FPGA_Board_feb 01/ls_error.kicad_sch (2025-12-10)

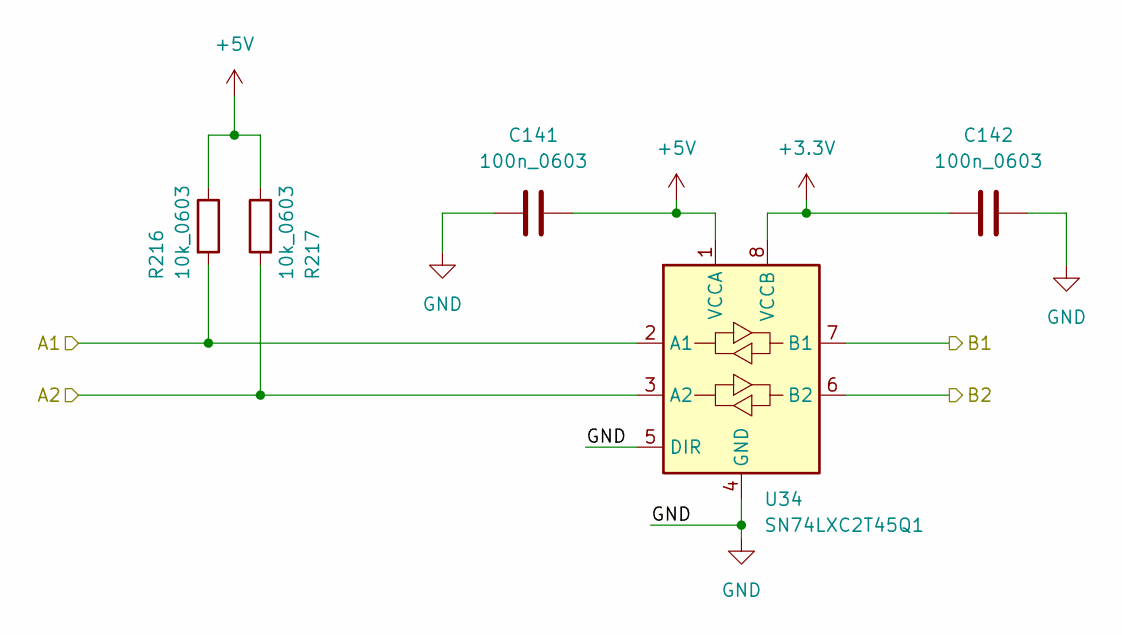
[picture p39: schematic ls_error.kicad_sch]

Parts:
C141, C142: 100n_0603; C_0603; FARNELL 1759037
R216, R217: 10k_0603; R_0603_1608Metric; FARNELL 2447230
U34: SN74LXC2T45Q1; SN74LXC2T45QDCURQ1; Mouser nr 595-74LXC2T45QDCURQ1

Connections:
+3.3V: C142.1, U34.8 (VCCB)
+5V: C141.2, R216.1, R217.1, U34.1 (VCCA)
A1: R216.2, U34.2 (A1)
A2: R217.2, U34.3 (A2)
B1: U34.7 (B1)
B2: U34.6 (B2)
GND: C141.1, C142.2, U34.4 (GND), U34.5 (DIR)
