der-kollege/My_kicad_hardware/FPGA_Board_BA/PCB_Leo_edit/FPGA_Board_feb 01/ls_for_dio.kicad_sch

## KiCad design FPGA_Board_BA/PCB_Leo_edit/FPGA_Board_feb 01/ls_for_dio.kicad_sch (2025-12-30)

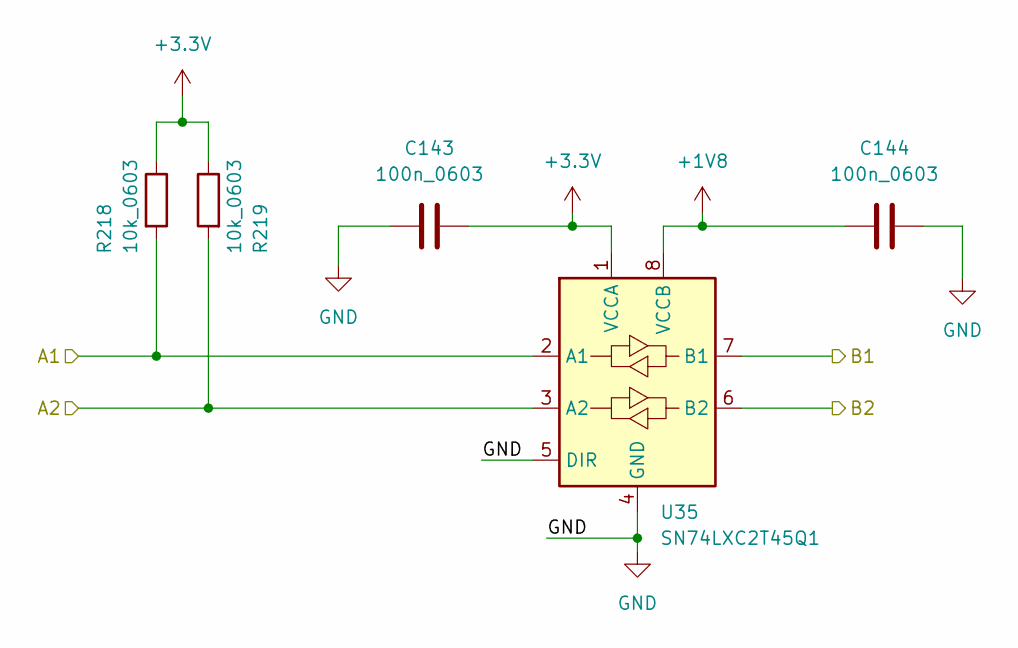
[picture p40: schematic ls_for_dio.kicad_sch]

Parts:
C143, C144: 100n_0603; C_0603; FARNELL 1759037
R218, R219: 10k_0603; R_0603_1608Metric; FARNELL 2447230
U35: SN74LXC2T45Q1; SN74LXC2T45QDCURQ1; Mouser nr 595-74LXC2T45QDCURQ1

Connections:
+1V8: C144.1, U35.8 (VCCB)
+3.3V: C143.2, R218.1, R219.1, U35.1 (VCCA)
A1: R218.2, U35.2 (A1)
A2: R219.2, U35.3 (A2)
B1: U35.7 (B1)
B2: U35.6 (B2)
GND: C143.1, C144.2, U35.4 (GND), U35.5 (DIR)
