der-kollege/My_kicad_hardware/FPGA_Board_BA/PCB_Leo_edit/FPGA_Board_feb 01/ls_rx_en.kicad_sch

## KiCad design FPGA_Board_BA/PCB_Leo_edit/FPGA_Board_feb 01/ls_rx_en.kicad_sch (2025-11-23)

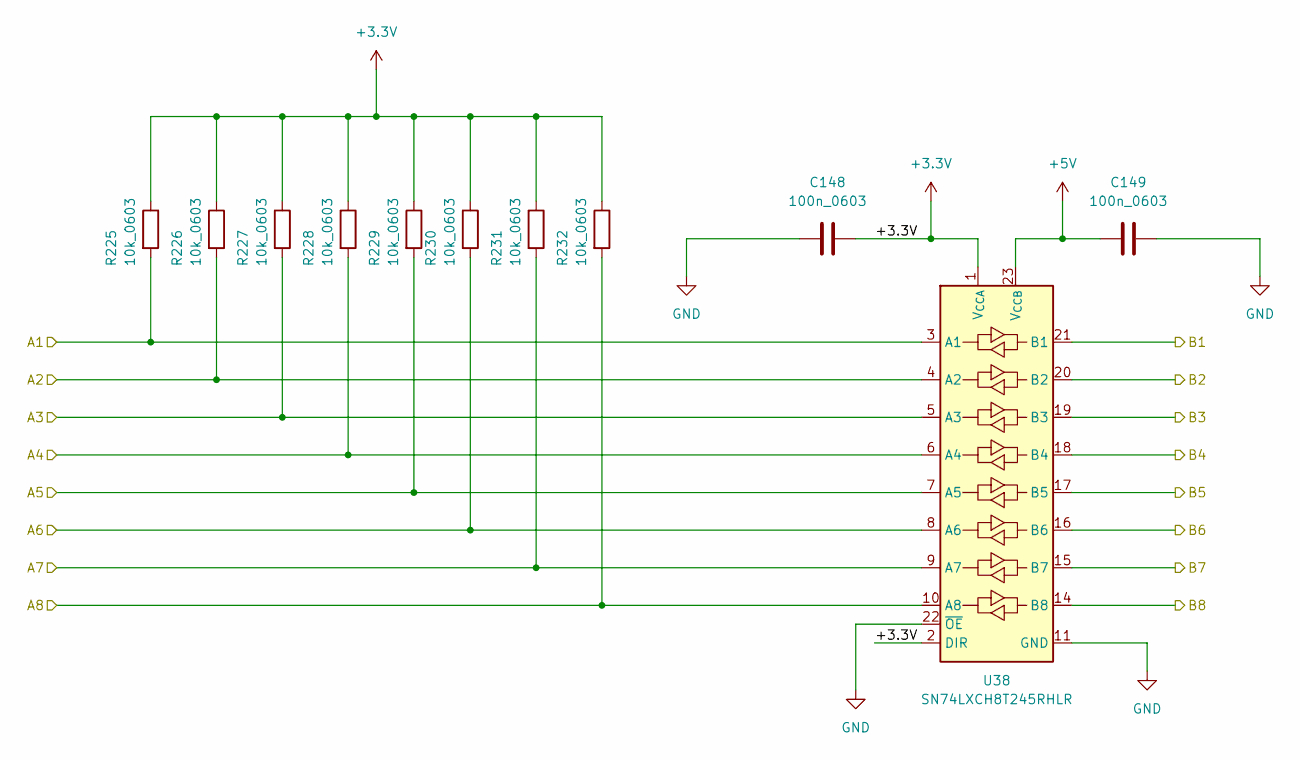
[picture p41: schematic ls_rx_en.kicad_sch]

Parts:
C148, C149: 100n_0603; C_0603; FARNELL 1759037
R225, R226, R227, R228, R229, R230, R231, R232: 10k_0603; R_0603_1608Metric; FARNELL 2447230
U38: SN74LXCH8T245RHLR; SN74LXCH8T245

Connections:
+3.3V: C148.2, R225.1, R226.1, R227.1, R228.1, R229.1, R230.1, R231.1, R232.1, U38.1 (V_{CCA}), U38.2 (DIR)
+5V: C149.1, U38.23 (V_{CCB}), U38.24 (V_{CCB})
A1: R225.2, U38.3 (A1)
A2: R226.2, U38.4 (A2)
A3: R227.2, U38.5 (A3)
A4: R228.2, U38.6 (A4)
A5: R229.2, U38.7 (A5)
A6: R230.2, U38.8 (A6)
A7: R231.2, U38.9 (A7)
A8: R232.2, U38.10 (A8)
B1: U38.21 (B1)
B2: U38.20 (B2)
B3: U38.19 (B3)
B4: U38.18 (B4)
B5: U38.17 (B5)
B6: U38.16 (B6)
B7: U38.15 (B7)
B8: U38.14 (B8)
GND: C148.1, C149.2, U38.11 (GND), U38.12 (GND), U38.13 (GND), U38.22 (~OE)
