der-kollege/My_kicad_hardware/FPGA_Board_BA/PCB_Leo_edit/FPGA_Board_feb 01/m_ain1.kicad_sch

## KiCad design FPGA_Board_BA/PCB_Leo_edit/FPGA_Board_feb 01/m_ain1.kicad_sch (2025-11-17)

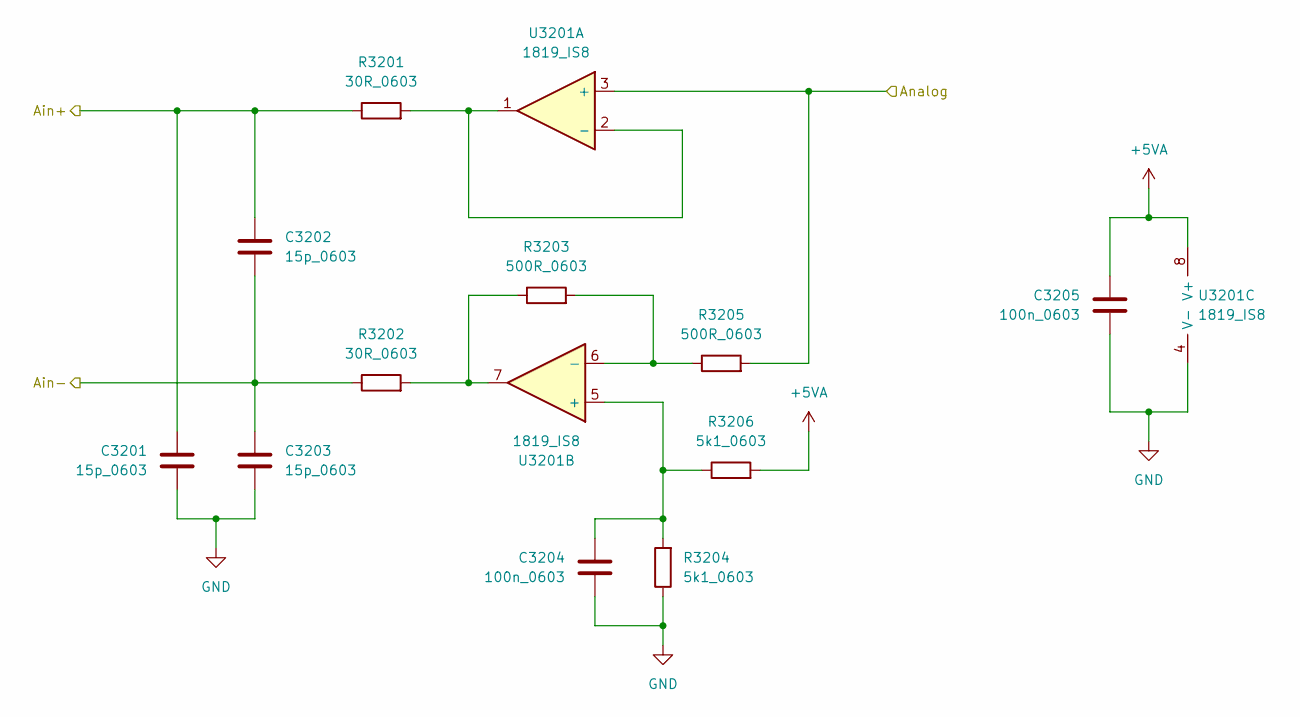
[picture p42: schematic m_ain1.kicad_sch]

Parts:
C3201, C3202, C3203: 15p_0603; C_0603; FARNELL 1759124
C3204, C3205: 100n_0603; C_0603; FARNELL 1759037
R3201, R3202: 30R_0603; R_0603_1608Metric; Power Rating 50mW; FARNELL 1711574
R3203, R3205: 500R_0603; R_0603_1608Metric; FARNELL 2059312
R3204, R3206: 5k1_0603; R_0603_1608Metric; FARNELL 2447404
U3201: 1819_IS8; LT1819

Connections:
+5VA: C3205.1, R3206.2, U3201.8 (V+)
Ain+: C3201.1, C3202.1, R3201.1
Ain-: C3202.2, C3203.1, R3202.1
Analog: R3205.2, U3201.3 (+)
GND: C3201.2, C3203.2, C3204.2, C3205.2, R3204.1, U3201.4 (V-)
unnamed: C3204.1, R3204.2, R3206.1, U3201.5 (+)
unnamed: R3201.2, U3201.1, U3201.2 (-)
unnamed: R3202.2, R3203.1, U3201.7
unnamed: R3203.2, R3205.1, U3201.6 (-)
