der-kollege/My_kicad_hardware/FPGA_Board_BA/PCB_Leo_edit/FPGA_Board_feb 01/main_dcdc.kicad_sch

## KiCad design FPGA_Board_BA/PCB_Leo_edit/FPGA_Board_feb 01/main_dcdc.kicad_sch (2026-01-25)

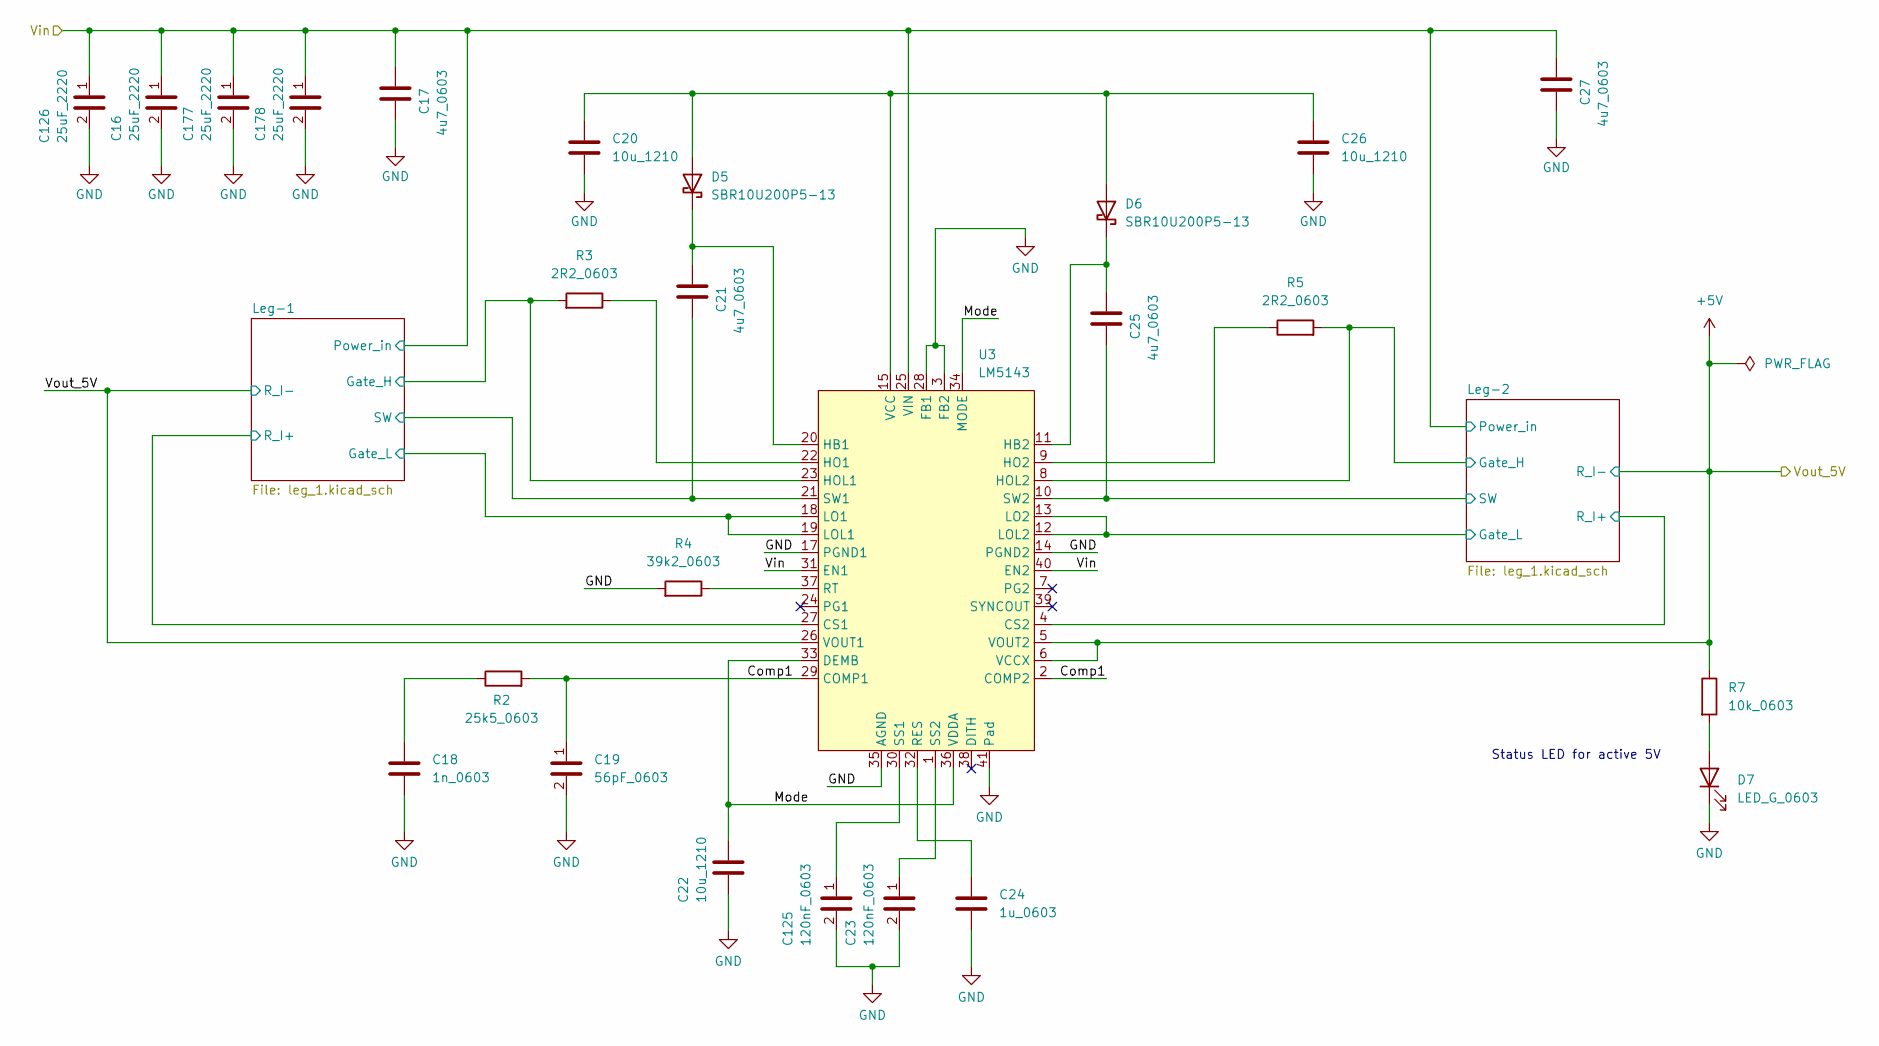
[picture p43: schematic main_dcdc.kicad_sch]

Parts:
C16, C126, C177, C178: 25uF_2220; C_2220_5650Metric_Pad1.97x5.40mm_HandSolder
C17, C21, C25, C27: 4u7_0603; C_0603; Voltage 25 V; FARNELL 2426959
C18: 1n_0603; C_0603; FARNELL 2627458
C19: 56pF_0603; C_0603_1608Metric_Pad1.08x0.95mm_HandSolder
C20, C22, C26: 10u_1210; C_1210; FARNELL 1327737
C23, C125: 120nF_0603; C_0603_1608Metric_Pad1.08x0.95mm_HandSolder
C24: 1u_0603; C_0603; FARNELL 3013414
D5, D6: SBR10U200P5-13; SBR10U200P5; Mouser nr 621-SBR10U200P5-13
D7: LED_G_0603; LED_0603_1608Metric; Forward Voltage 2.65 V @ 2mA; FARNELL 2610409
R2: 25k5_0603; R_0603_1608Metric_Pad0.98x0.95mm_HandSolder
R3, R5: 2R2_0603; R_0603_1608Metric; Power Rating 100mW; FARNELL 3495946
R4: 39k2_0603; R_0603_1608Metric_Pad0.98x0.95mm_HandSolder
R7: 10k_0603; R_0603_1608Metric; FARNELL 2447230
U3: LM5143; VQFN 40 pin 5.8mm x 5.8mm

Connections:
+5V: R7.1, U3.5 (VOUT2), U3.6 (VCCX)
Comp1: C19.1, R2.2, U3.2 (COMP2), U3.29 (COMP1)
GND: C16.2, C17.2, C18.2, C19.2, C20.2, C22.2, C23.2, C24.2, C26.2, C27.2, C125.2, C126.2, C177.2, C178.2, D7.1 (K), R4.1, U3.3 (FB2), U3.14 (PGND2), U3.17 (PGND1), U3.28 (FB1), U3.35 (AGND), U3.41 (Pad)
Gate_H: R3.1, R5.1, U3.8 (HOL2), U3.23 (HOL1)
Gate_L: U3.12 (LOL2), U3.13 (LO2), U3.18 (LO1), U3.19 (LOL1)
Mode: C22.1, U3.33 (DEMB), U3.34 (MODE), U3.36 (VDDA)
unnamed: C18.1, R2.1
unnamed: C20.1, C26.1, D5.2 (A), D6.2 (A), U3.15 (VCC), U3.16 (VCC)
unnamed: C21.1, D5.1 (K), U3.20 (HB1)
unnamed: C23.1, U3.1 (SS2)
unnamed: C24.1, U3.32 (RES)
unnamed: C25.1, D6.1 (K), U3.11 (HB2)
unnamed: C125.1, U3.30 (SS1)
unnamed: D7.2 (A), R7.2
unnamed: R3.2, U3.22 (HO1)
unnamed: R4.2, U3.37 (RT)
unnamed: R5.2, U3.9 (HO2)
R_I+: U3.4 (CS2), U3.27 (CS1)
SW: C21.2, C25.2, U3.10 (SW2), U3.21 (SW1)
Vin: C16.1, C17.1, C27.1, C126.1, C177.1, C178.1, U3.25 (VIN), U3.31 (EN1), U3.40 (EN2)
Vout_5V: U3.26 (VOUT1)

Notes on the sheet:
Status LED for active 5V
