der-kollege/My_kicad_hardware/FPGA_Board_BA/PCB_Leo_edit/FPGA_Board_feb 01/power_from_chb.kicad_sch

## KiCad design FPGA_Board_BA/PCB_Leo_edit/FPGA_Board_feb 01/power_from_chb.kicad_sch (2025-11-23)

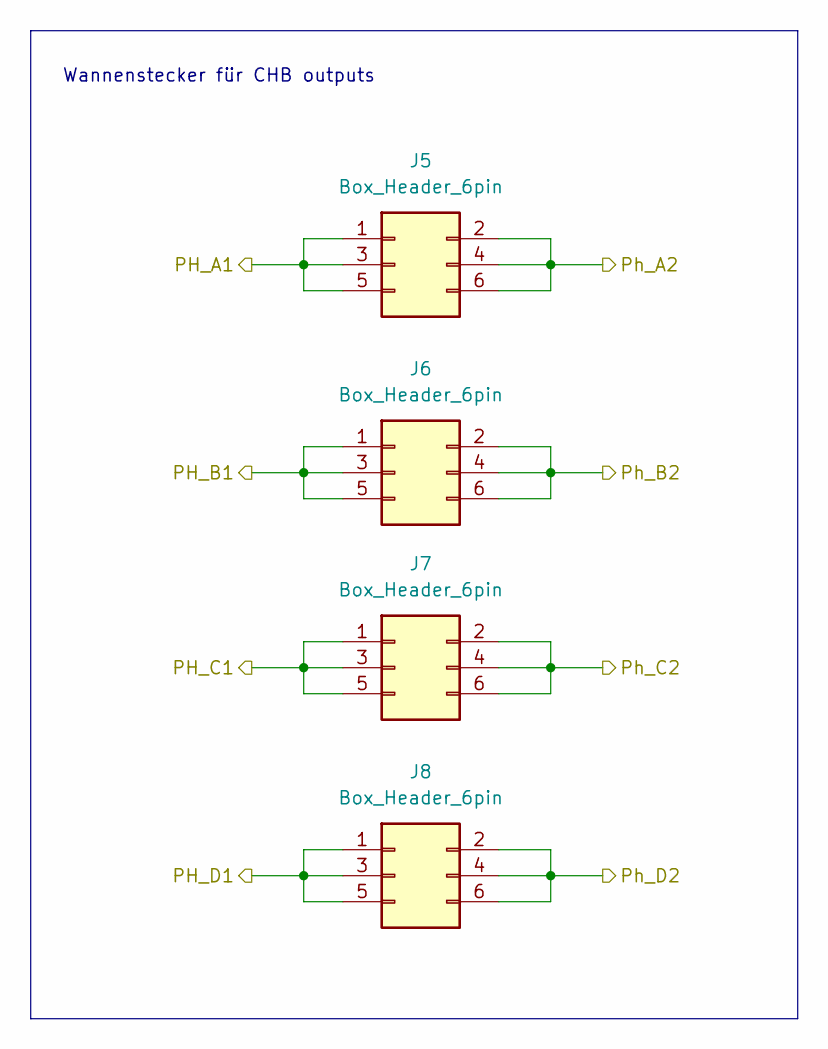
[picture p44: schematic power_from_chb.kicad_sch]

Parts:
J5, J6, J7, J8: Box_Header_6pin; IDC-Header_2x03_P2.54mm_Vertical

Connections:
PH_A1: J5.1, J5.3, J5.5
PH_B1: J6.1, J6.3, J6.5
PH_C1: J7.1, J7.3, J7.5
PH_D1: J8.1, J8.3, J8.5
Ph_A2: J5.2, J5.4, J5.6
Ph_B2: J6.2, J6.4, J6.6
Ph_C2: J7.2, J7.4, J7.6
Ph_D2: J8.2, J8.4, J8.6

Notes on the sheet:
Wannenstecker für CHB outputs
