der-kollege/My_kicad_hardware/FPGA_Board_BA/PCB_Leo_edit/FPGA_Board_feb 01/tamura.kicad_sch

## KiCad design FPGA_Board_BA/PCB_Leo_edit/FPGA_Board_feb 01/tamura.kicad_sch (2025-12-10)

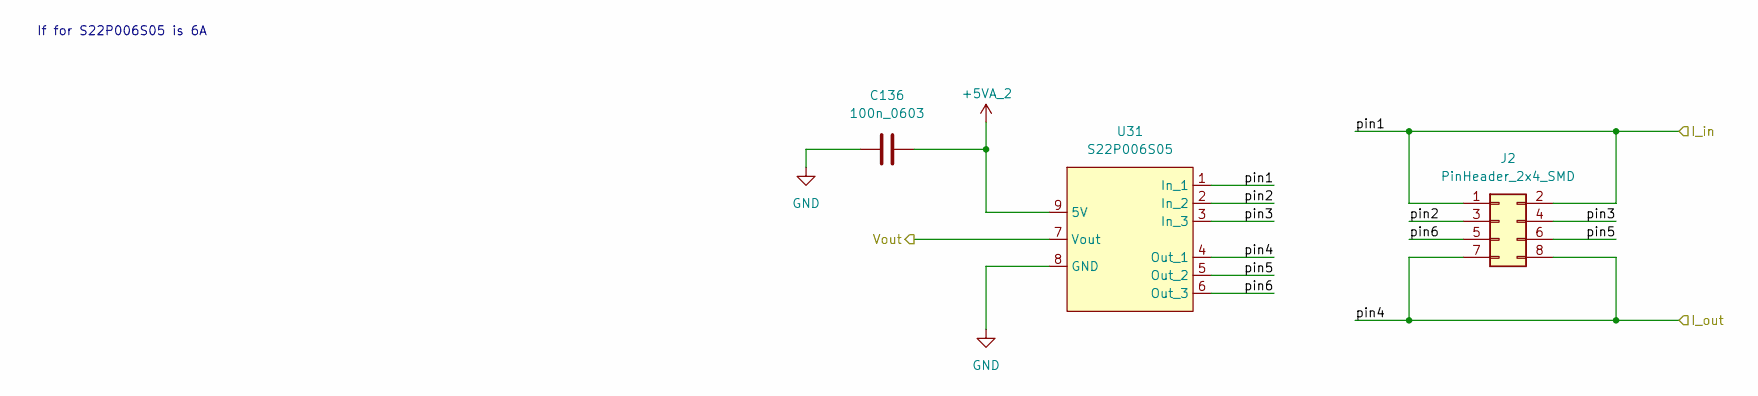
[picture p45: schematic tamura.kicad_sch]

Parts:
C136: 100n_0603; C_0603; FARNELL 1759037
J2: PinHeader_2x4_SMD; PinHeader_2x04_P2.54mm_Vertical_SMD; Mouser Nr 710-61030821121
U31: S22P006S05; Tamura_S22P006S05; Mouser nr 838-S22P006S05

Connections:
+5VA_2: C136.2, U31.9 (5V)
GND: C136.1, U31.8 (GND)
I_in: J2.1, J2.2, U31.1 (In_1)
I_out: J2.7, J2.8, U31.4 (Out_1)
Vout: U31.7 (Vout)
pin2: J2.3, U31.2 (In_2)
pin3: J2.4, U31.3 (In_3)
pin5: J2.6, U31.5 (Out_2)
pin6: J2.5, U31.6 (Out_3)

Notes on the sheet:
If for S22P006S05 is 6A
