der-kollege/My_kicad_hardware/FPGA_Board_BA/PCB_Leo_edit/FPGA_Board_feb 01/user_interaction.kicad_sch

## KiCad design FPGA_Board_BA/PCB_Leo_edit/FPGA_Board_feb 01/user_interaction.kicad_sch (2025-12-27)

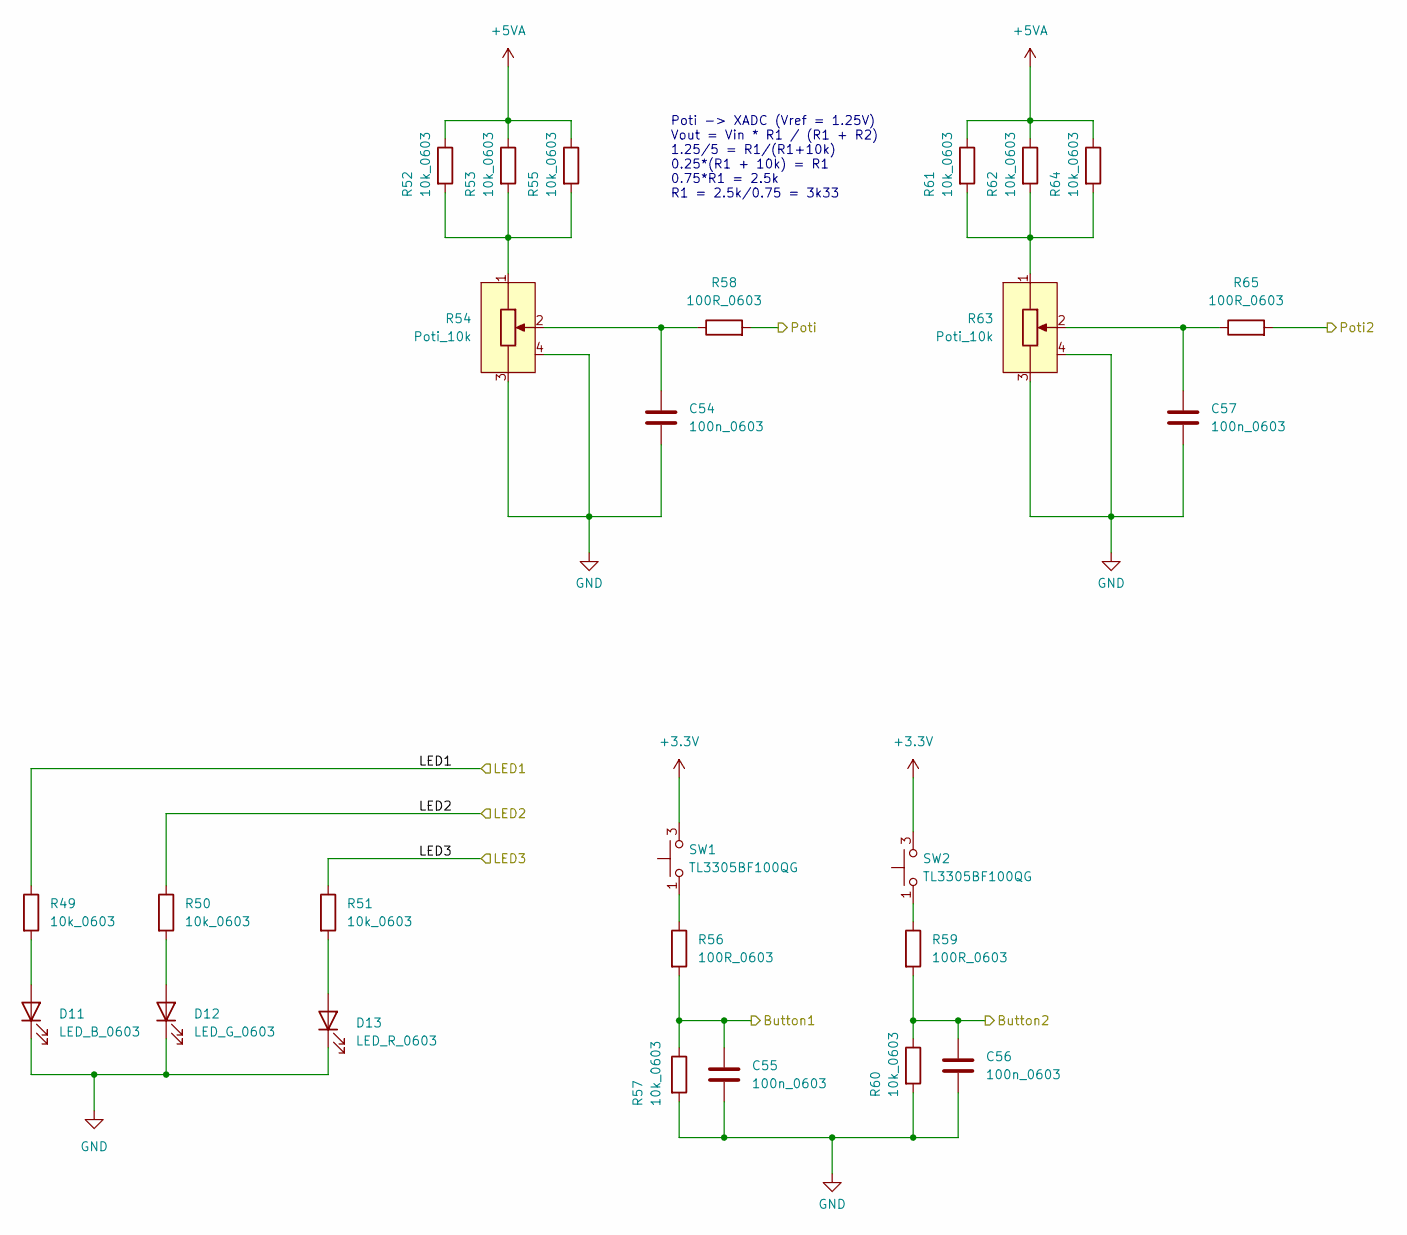
[picture p46: schematic user_interaction.kicad_sch]

Parts:
C54, C55, C56, C57: 100n_0603; C_0603; FARNELL 1759037
D11: LED_B_0603; LED_0603_1608Metric; Forward Voltage 2.65V @ 2mA; FARNELL 2610410
D12: LED_G_0603; LED_0603_1608Metric; Forward Voltage 2.65 V @ 2mA; FARNELL 2610409
D13: LED_R_0603; LED_0603_1608Metric; Forward voltage 1.8V @ 2mA; FARNELL 2610406
R49, R50, R51, R52, R53, R55, R57, R60, R61, R62, R64: 10k_0603; R_0603_1608Metric; FARNELL 2447230
R54, R63: Poti_10k; RK09D1130A1N; Mouser nr 688-RK09D1130A1N
R56, R58, R59, R65: 100R_0603; R_0603_1608Metric; FARNELL 2078901
SW1, SW2: TL3305BF100QG; TL3305BF160QG; mouser 612-TL3305BF100QG

Connections:
+3.3V: SW1.3, SW1.4, SW2.3, SW2.4
+5VA: R52.1, R53.1, R55.1, R61.1, R62.1, R64.1
Button1: C55.1, R56.2, R57.1
Button2: C56.1, R59.2, R60.1
GND: C54.2, C55.2, C56.2, C57.2, D11.1 (K), D12.1 (K), D13.1 (K), R54.3, R54.4, R54.5, R57.2, R60.2, R63.3, R63.4, R63.5
LED1: R49.1
LED2: R50.1
LED3: R51.1
unnamed: C54.1, R54.2, R58.1
unnamed: C57.1, R63.2, R65.1
unnamed: D11.2 (A), R49.2
unnamed: D12.2 (A), R50.2
unnamed: D13.2 (A), R51.2
unnamed: R52.2, R53.2, R54.1, R55.2
unnamed: R56.1, SW1.1, SW1.2
unnamed: R59.1, SW2.1, SW2.2
unnamed: R61.2, R62.2, R63.1, R64.2
Poti: R58.2
Poti2: R65.2

Notes on the sheet:
Poti -> XADC (Vref = 1.25V) Vout = Vin * R1 / (R1 + R2) 1.25/5 = R1/(R1+10k) 0.25*(R1 + 10k) = R1 0.75*R1 = 2.5k R1 = 2.5k/0.75 = 3k33
