der-kollege/My_kicad_hardware/FPGA_Board_BA/PCB_Leo_edit/FPGA_Board_feb 01/v_measure.kicad_sch

## KiCad design FPGA_Board_BA/PCB_Leo_edit/FPGA_Board_feb 01/v_measure.kicad_sch (2025-12-17)

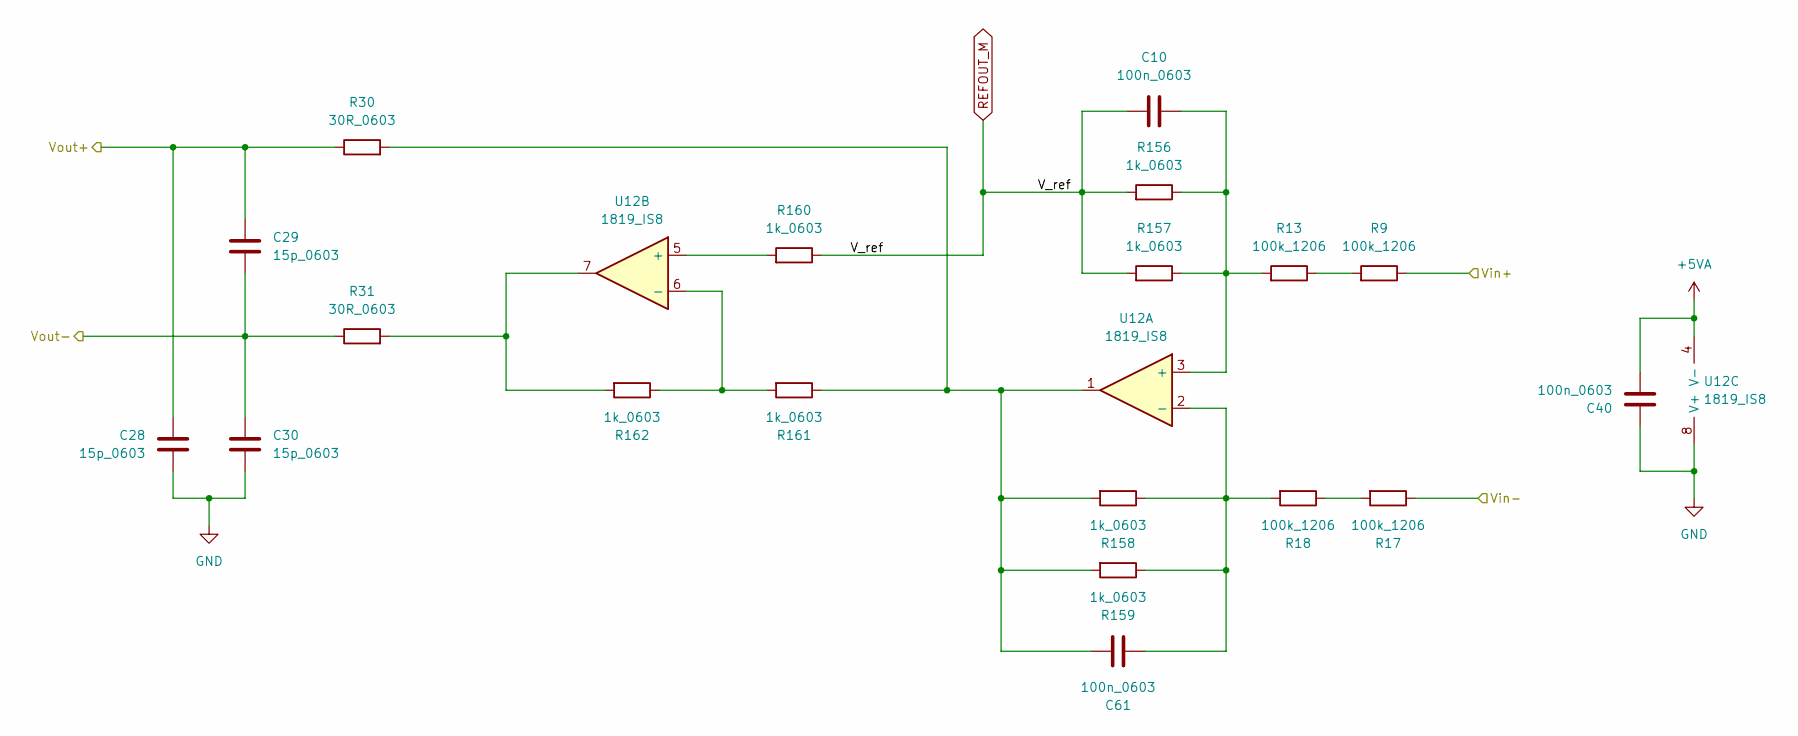
[picture p47: schematic v_measure.kicad_sch]

Parts:
C10, C40, C61: 100n_0603; C_0603; FARNELL 1759037
C28, C29, C30: 15p_0603; C_0603; FARNELL 1759124
R9, R13, R17, R18: 100k_1206; R_1206_3216Metric
R30, R31: 30R_0603; R_0603_1608Metric; Power Rating 50mW; FARNELL 1711574
R156, R157, R158, R159, R160, R161, R162: 1k_0603; R_0603_1608Metric; FARNELL 2078907
U12: 1819_IS8; LT1819

Connections:
+5VA: C40.2, U12.4 (V-)
GND: C28.2, C30.2, C40.1, U12.8 (V+)
unnamed: C10.1, R13.2, R156.1, R157.1, U12.3 (+)
unnamed: C61.1, R18.2, R158.1, R159.1, U12.2 (-)
unnamed: C61.2, R30.2, R158.2, R159.2, R161.1, U12.1
unnamed: R9.2, R13.1
unnamed: R17.2, R18.1
unnamed: R160.2, U12.5 (+)
unnamed: R161.2, R162.1, U12.6 (-)
unnamed: R31.2, R162.2, U12.7
REFOUT_M: C10.2, R156.2, R157.2, R160.1
Vin+: R9.1
Vin-: R17.1
Vout+: C28.1, C29.1, R30.1
Vout-: C29.2, C30.1, R31.1
