der-kollege/My_kicad_hardware/FPGA_Board_BA/PCB_Leo_edit/FPGA_Board_feb 01/zynq_5v.kicad_sch

## KiCad design FPGA_Board_BA/PCB_Leo_edit/FPGA_Board_feb 01/zynq_5v.kicad_sch (2026-01-01)

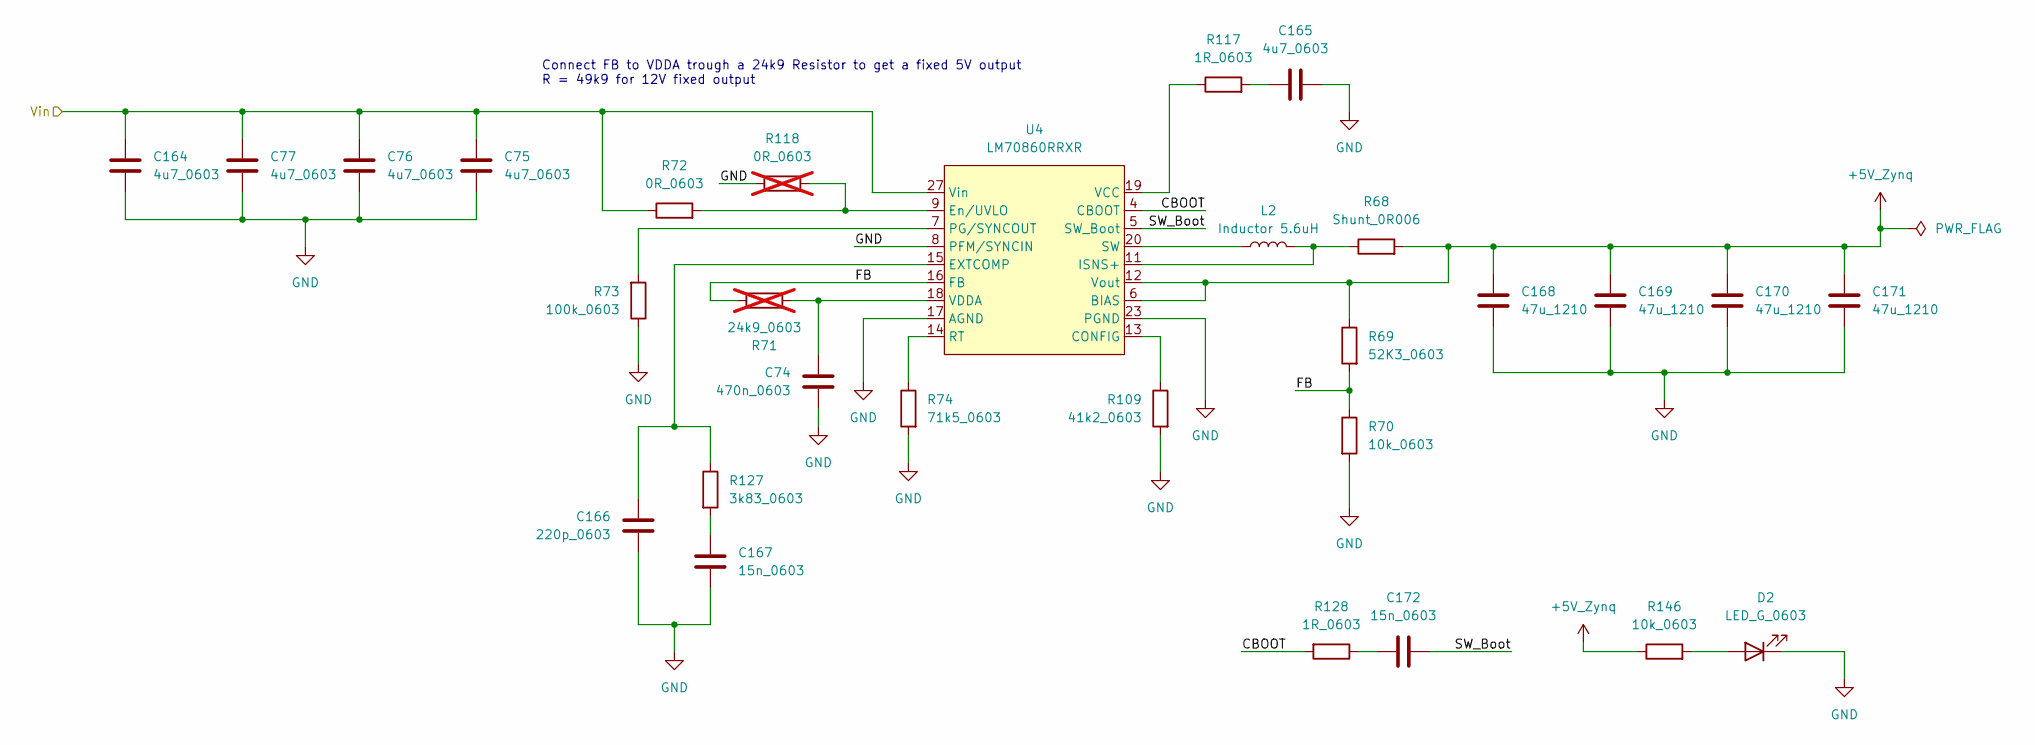
[picture p48: schematic zynq_5v.kicad_sch]

Parts:
C74: 470n_0603; C_0603; Voltage 25 V; FARNELL 2320797
C75, C76, C77, C164, C165: 4u7_0603; C_0603; Voltage 25 V; FARNELL 2426959
C166: 220p_0603; R_0603_1608Metric
C167, C172: 15n_0603; C_0603; FARNELL 2984967
C168, C169, C170, C171: 47u_1210; C_1210_3225Metric
D2: LED_G_0603; LED_0603_1608Metric; Forward Voltage 2.65 V @ 2mA; FARNELL 2610409
L2: Inductor 5.6uH; L_5u6_78439346056
R68: Shunt_0R006; PRL1632-R006-F-T1; Mouser nr 754-PRL1632-R006-FT1
R69: 52K3_0603; R_0603_1608Metric; FARNELL 2337222
R70, R146: 10k_0603; R_0603_1608Metric; FARNELL 2447230
R71: 24k9_0603; R_0603_1608Metric; FARNELL 2670717; not fitted
R72: 0R_0603; R_0603_1608Metric; FARNELL 2309111
R73: 100k_0603; R_0603_1608Metric; Power Rating 100mW; FARNELL 2078921
R74: 71k5_0603; R_0603_1608Metric
R109: 41k2_0603; R_0603_1608Metric
R117, R128: 1R_0603; R_0603_1608Metric_Pad0.98x0.95mm_HandSolder; Power Rating 100mW; FARNELL 2073361
R118: 0R_0603; R_0603_1608Metric; FARNELL 2309111; not fitted
R127: 3k83_0603; R_0603_1608Metric
U4: LM70860RRXR; RRX Package, 29-Pin VQFN; Mouser Nr 595-LM70860RRXR

Connections:
+5V_Zynq: C168.2, C169.2, C170.2, C171.2, R68.2, R69.1, R146.1, U4.6 (BIAS), U4.12 (Vout)
CBOOT: R128.2, U4.4 (CBOOT)
FB: R69.2, R70.1, R71.1, U4.16 (FB)
GND: C74.2, C75.2, C76.2, C77.2, C164.2, C165.2, C166.1, C167.2, C168.1, C169.1, C170.1, C171.1, D2.1 (K), R70.2, R73.1, R74.1, R109.1, R118.1, U4.8 (PFM/SYNCIN), U4.17 (AGND), U4.23 (PGND), U4.24 (PGND), U4.25 (PGND), U4.26 (PGND), U4.30 (PGND)
unnamed: C74.1, R71.2, U4.18 (VDDA)
unnamed: C165.1, R117.2
unnamed: C166.2, R127.2, U4.15 (EXTCOMP)
unnamed: C167.1, R127.1
unnamed: C172.1, R128.1
unnamed: D2.2 (A), R146.2
unnamed: L2.1, U4.20 (SW), U4.21 (SW), U4.22 (SW)
unnamed: L2.2, R68.1, U4.11 (ISNS+)
unnamed: R73.2, U4.7 (PG/SYNCOUT)
unnamed: R74.2, U4.14 (RT)
unnamed: R109.2, U4.13 (CONFIG)
unnamed: R117.1, U4.19 (VCC)
unnamed: R72.2, R118.2, U4.9 (En/UVLO)
SW_Boot: C172.2, U4.5 (SW_Boot)
Vin: C75.1, C76.1, C77.1, C164.1, R72.1, U4.1 (Vin), U4.2 (Vin), U4.3 (Vin), U4.27 (Vin), U4.28 (Vin), U4.29 (Vin)

Notes on the sheet:
Connect FB to VDDA trough a 24k9 Resistor to get a fixed 5V output R = 49k9 for 12V fixed output
