der-kollege/My_kicad_hardware/(commit log)

2025-10-27 created FPGA Board project + added lib
    [FPGA_Board_BA.kicad_pcb, FPGA_Board_BA.kicad_sch]
2025-10-28 starting schematic + added kicad lib
    [FPGA_Board_BA.kicad_sch, adc.kicad_sch, current_measure.kicad_sch, fpga.kicad_sch]
2025-10-29 moved Project, lib changes
    [FPGA_Board_BA.kicad_pcb, FPGA_Board_BA.kicad_sch, adc.kicad_sch, current_measure.kicad_sch, fpga.kicad_sch]
2025-11-01 some changes + lib
    [adc.kicad_sch, current_measure.kicad_sch, fpga.kicad_sch]
2025-11-09 adding DCCD
    [FPGA_Board_BA.kicad_sch, connectors.kicad_sch, current_measure.kicad_sch, main_dcdc.kicad_sch]
2025-11-10 some work on the schematics
    [EM_Connector.kicad_sch, FPGA_Board_BA.kicad_sch, chb_coupler.kicad_sch, chb_phase_a.kicad_sch, chb_phase_b.kicad_sch, chb_phase_c.kicad_sch, chb_phase_d.kicad_sch, chb_to_3ph.kicad_sch]
2025-11-10 some stuff
    [FPGA_Board_BA.kicad_sch, chb_com.kicad_sch, encoder.kicad_sch, power_from_chb.kicad_sch]
2025-11-11 schematic almost ready
    [FPGA_Board_BA.kicad_sch, adc.kicad_sch, analog_voltage.kicad_sch, chb_com.kicad_sch, current_measure.kicad_sch, fpga.kicad_sch, main_dcdc.kicad_sch, ti_b6.kicad_sch]
2025-11-12 schematic almost ready pt2
    [FPGA_Board_BA.kicad_pcb, FPGA_Board_BA.kicad_sch, adc.kicad_sch, analog_voltage.kicad_sch, chb_com.kicad_sch, connectors.kicad_sch, fpga.kicad_sch, main_dcdc.kicad_sch]
2025-11-16 Besprechung mit Leo
    [FPGA_Board_BA.kicad_sch, adc.kicad_sch, chb_com.kicad_sch, encoder.kicad_sch, power_from_chb.kicad_sch, ti_b6.kicad_sch, user_interaction.kicad_sch]
2025-11-17 some schematic changes + Misc
    [FPGA_Board_BA.kicad_sch, adc_machine.kicad_sch, current_measure.kicad_sch, fpga.kicad_sch, voltage_meas.kicad_sch]
2025-11-17 lot of work
    [FPGA_Board_BA.kicad_pcb, FPGA_Board_BA.kicad_sch, Machine_ain_2.kicad_sch, adc_for_b6.kicad_sch, adc_machine.kicad_sch, adc_power.kicad_sch, b6_ain1.kicad_sch, chb_com.kicad_sch]
2025-11-17 lots of work
    [FPGA_Board_BA.kicad_pcb, FPGA_Board_BA.kicad_sch, chb_com.kicad_sch, chb_to_3ph.kicad_sch, encoder.kicad_sch, fpga.kicad_sch, level_shifter_8bit.kicad_sch, ls_error.kicad_sch]
2025-11-18 18.11 Bib Session
    [FPGA_Board_BA.kicad_pcb, FPGA_Board_BA.kicad_sch, adc_for_b6.kicad_sch, adc_machine.kicad_sch, adc_power.kicad_sch, diffamp_adc.kicad_sch, fpga.kicad_sch, ls_for_dio.kicad_sch]
2025-11-23 exported stuff
    [FPGA_Board_BA.kicad_sch, adc_for_b6.kicad_sch, adc_machine.kicad_sch, analog_voltage.kicad_sch, chb_com.kicad_sch, chb_to_3ph.kicad_sch, connectors.kicad_sch, diffamp_.kicad_sch]
2025-12-01 added Wannenstecker 24pin + BOM
    [BOM_Farnell_0.csv, BOM_Mouser_0.xls, BOM_Mouser_1.xls, FPGA_Board_BA.csv, FPGA_Board_BA.kicad_sch, chb_com.kicad_sch]
2025-12-10 schematic fixes after Leo Meeting
    [5va.kicad_sch, FPGA_Board_BA.kicad_pcb, FPGA_Board_BA.kicad_sch, analog_voltage.kicad_sch, diffamp_.kicad_sch, diffamp_adc.kicad_sch, fpga.kicad_sch, ls_error.kicad_sch]
2025-12-10 started component placement
    [FPGA_Board_BA.kicad_pcb, FPGA_Board_BA.kicad_sch, fpga.kicad_sch]
2025-12-12 placement of Power DCDC and Buffers ready
    [FPGA_Board_BA.kicad_pcb, diffamp_.kicad_sch, fpga.kicad_sch, main_dcdc.kicad_sch]
2025-12-13 arranged level shifters in schematic + solid progress in layout
    [FPGA_Board_BA.kicad_pcb, FPGA_Board_BA.kicad_sch, adc_for_b6.kicad_sch]
2025-12-13 layout of islands is ready
    [FPGA_Board_BA.kicad_pcb, FPGA_Board_BA.kicad_sch, adc_machine.kicad_sch, main_dcdc.kicad_sch]
2025-12-16 Component placement ready. Waiting to meet with Leo
    [FPGA_Board_BA.kicad_pcb, FPGA_Board_BA.kicad_sch, analog_voltage.kicad_sch, fpga.kicad_sch]
2025-12-16 Placement optimised
    [FPGA_Board_BA.kicad_pcb, fpga.kicad_sch, leg_1.kicad_sch, main_dcdc.kicad_sch]
2025-12-17 component placement with new concept is ready
    [FPGA_Board_BA.kicad_pcb, FPGA_Board_BA.kicad_sch, adc_for_b6.kicad_sch, adc_machine.kicad_sch, chb_to_3ph.kicad_sch, diffamp_adc.kicad_sch, leg_1.kicad_sch, v_measure.kicad_sch]
2025-12-17 started power DCDC layout
    [FPGA_Board_BA.kicad_pcb, adc_machine.kicad_sch, v_measure.kicad_sch]
2025-12-20 DCDC Converter layout almost ready
    [FPGA_Board_BA.kicad_pcb]
2025-12-21 small changes in the PCB
    [FPGA_Board_BA.kicad_pcb]
2025-12-24 started routing of the right side
    [FPGA_Board_BA.kicad_pcb]
2025-12-24 right side almost finished
    [FPGA_Board_BA.kicad_pcb, chb_com.kicad_sch]
2025-12-25 some changes in the PCB
    [FPGA_Board_BA.kicad_pcb, fpga.kicad_sch]
2025-12-26 some minimal changes on the PCB on the right side
    [FPGA_Board_BA.kicad_pcb, fpga.kicad_sch]
2025-12-26 added bus into schematic
    [FPGA_Board_BA.kicad_pcb, FPGA_Board_BA.kicad_sch, chb_com.kicad_sch, fpga.kicad_sch]
2025-12-27 big schematic cleanup. Added wire to bus
    [FPGA_Board_BA.kicad_pcb, FPGA_Board_BA.kicad_sch, adc_for_b6.kicad_sch, adc_machine.kicad_sch, chb_com.kicad_sch, current_measure.kicad_sch, encoder.kicad_sch, fpga.kicad_sch]
2025-12-28 PCB left side almost finished + some optimization in schematics
    [FPGA_Board_BA.kicad_pcb, FPGA_Board_BA.kicad_sch, adc_for_b6.kicad_sch, adc_machine.kicad_sch, fpga.kicad_sch, main_dcdc.kicad_sch, ti_b6.kicad_sch]
2025-12-28 added 5V supply for Zynq
    [FPGA_Board_BA.kicad_sch, analog_voltage.kicad_sch, zynq_5v.kicad_sch]
2025-12-29 layed out power supply for Zynq
    [FPGA_Board_BA.kicad_pcb, fpga.kicad_sch, zynq_5v.kicad_sch]
2025-12-30 optimised pinout in schematic + added level shifter for CLKOUT + got forward with layout
    [FPGA_Board_BA.kicad_pcb, adc_for_b6.kicad_sch, adc_machine.kicad_sch, fpga.kicad_sch, ls_clkout.kicad_sch, ls_for_dio.kicad_sch]
2025-12-31 fixed wire bus in schematic + routing almost ready, only routing of power is left
    [FPGA_Board_BA.kicad_sch, chb_com.kicad_sch, current_measure.kicad_sch, encoder.kicad_sch, fpga.kicad_sch]
2025-12-31 layout 99% ready
    [ls_encoder.kicad_sch, zynq_5v.kicad_sch]
2026-01-01 layout ready to be reviewed by Leo
    [encoder.kicad_sch, ls_encoder.kicad_sch, voltage_meas.kicad_sch, zynq_5v.kicad_sch]
2026-01-24 Nach meeting mit Leo
    [adc_for_b6.kicad_sch, adc_machine.kicad_sch]
2026-01-25 final layout almost ready (onlypower is left)
    [FPGA_Board_BA.kicad_sch, adc_machine.kicad_sch, chb_com.kicad_sch, en_err_circuit.kicad_sch]
2026-01-25 PCB ready to be ordered
    [FPGA_Board_BA-B_Cu.gbr, FPGA_Board_BA-B_Mask.gbr, FPGA_Board_BA-B_Paste.gbr, FPGA_Board_BA-B_Silkscreen.gbr, FPGA_Board_BA-Edge_Cuts.gbr, FPGA_Board_BA-F_Cu.gbr, FPGA_Board_BA-F_Mask.gbr, FPGA_Board_BA-F_Paste.gbr]
2026-02-26 added Leo edit
    [5va.kicad_sch, EM_Connector.kicad_sch, FPGA_Board_BA.kicad_sch, FPGA_Board_BA_final.csv, FPGA_Board_BA_final_left.csv, Machine_ain_2.kicad_sch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]
2026-03-02 Adding drawings to PCB + Improvements.txt
    [FPGA_Board_BA-User_Comments.dxf, FPGA_Board_BA-User_Drawings.dxf]
2026-04-03 creating pinout docs for the Zynq board + BA Struktur
    [Zynq_pinout.xlsx]
